novelda/Legacy-HW/X4A02-PCBA-Rev3_3_Design-Documentation_Public/readme.md

# X4A02-PCBA-Rev3_3_Design_Documentation_Public.zip - Package content 

This document describes the contents of this PCBA documentation package.

## Package Content

    |-- PCBA_Doc_28xxxx-xxx/                    # Folder containing documents for board assembly
        |-- BOM-28xxxx-xxx.xlsx                 # Bill of Materials in Excel format
        |-- PCBA_Doc_28xxxx-xxx.PDF             # PCBA Manufacturing Documentation in pdf format
        |-- Pick_Place-28xxxx-xxx.txt           # ascii file for Pick and Place machine
        |-- Test_Point_Report-28xxxx-xxx.txt    # ascii file with coordinates of test points
    |-- 3D_Print_28xxxx-xxx.PDF                 # 3D-view of PCBA in pdf format
    |-- readme.md                               # This file
    |-- STEP_Model_28xxxx-xxx.step              # 3D model of PCBA in step format

## Viewing step model

The step model file contains the PCBA in 3D step format. The model may be imported into most 3D CAD tools. To view the model, use a simple step viewer like
[STP Viewer](http://stpviewer.com/).

## Documents under license

Antennas are available under license. Contact your XeThru partner to get a license agreement for XeThru antennas.
