novelda/Legacy-HW/X4M03-Rev5_Design_Documentation_Public/readme.md

# X4M03-Rev5_Design_Documentation_Public.zip - Package content

This document describes the contents of this PCBA documentation package.

## Package Content

    |-- Altium_Project_000153-005/              # Folder containing Altium project files
      |-- doc/                                  # Folder containing documents in ascii format
        |-- PCBA_documentation.txt              # Markdown file for generation of assembly specifications
        |-- Release_Notes.txt                   # Markdown file with project release notes
      |-- Project.outjob                        # Altium Outjob file
      |-- X4M03.PcbDoc                          # Altium PCB Document
      |-- PCBA_Assembly.PCBDwf                  # Altium Draftsman assembly drawing
      |-- X4M03.PrjPcb                          # Altium PCB Project File
      |-- Main.SchDoc                           # Altium Schematic sheet
    |-- PCBA_Doc_000153-005/                    # Folder containing documents for board assembly
      |-- BOM-000153-005.xlsx                   # Bill of Materials in Excel format
      |-- PCBA_Doc_000153-005.PDF               # PCBA Manufacturing Documentation in pdf format
    |-- readme.md                               # This file
    |-- 3D_Print_000153-005.PDF                 # 3D-view of PCBA in pdf format
    |-- PDF3D_000153-005                        # 3D-model of PCBA in PDF3D format
    |-- STEP_Model_000153-005.step              # 3D model of PCBA in step format

## Viewing step model

The step model file contains the PCBA in 3D step format. The model may be imported into most 3D CAD tools. To view the model, use a simple step viewer like
[STP Viewer](http://stpviewer.com/).

## Documents under license

Antennas are available under license. Contact your XeThru partner to get a license agreement for XeThru antennas.
