novelda/Legacy-HW/X4M05-Rev3_2_Design_Documentation_Public/readme.md

# X4M05_Rev3_2_Design_Documentation_Public.zip - Package content

This document describes the contents of this PCBA documentation package.

## Package Content

    |-- PCBA_Doc_280040-003/                    # Folder containing documents for board assembly
        |-- BOM-280040-003.xlsx                 # Bill of Materials in Excel format
        |-- PCBA_Doc_280040-003.PDF             # PCBA Manufacturing Documentation in pdf format
        |-- Pick_Place-280040-003.txt           # ascii file for Pick and Place machine
        |-- Test_Point_Report-280040-003.txt    # ascii file with coordinates of test points
    |-- 3D_Print_280040-003.PDF                 # 3D-view of PCBA in pdf format
    |-- readme.md                               # This file
    |-- STEP_Model_280040-003.step              # 3D model of PCBA in step format

## Viewing step model

The step model file contains the PCBA in 3D step format. The model may be imported into most 3D CAD tools. To view the model, use a simple step viewer like
[STP Viewer](http://stpviewer.com/).

## Documents under license

Antennas are available under license. Contact your XeThru partner to get a license agreement for XeThru antennas.
