novelda/Legacy-HW/X4A02-PCBA-Rev3_3_Design-Documentation_Public/PCBA_Doc_280024-003/BOM-280024-003.xlsx

 | BOM | 280024-003
 | Project: | X4A02 |  | Company: | Novelda AS
 | Title: | Populated components |  | Address: | Gjerdrums vei 8
 | Date: | 2018-03-19 |  |  | NO-0484 Oslo
 | Sheet number: | 1 of 1 |  |  | Norway
 |  |  |  | Classification: | Public
 |  |  |  | Copyright: | Copyright©2018 Novelda AS
# | Designator | Description | Manufacturer | MPN | Quantity | Notes
1 | A1 | X4A02 PCB Rev3 | Novelda |  | 1 | -
2 | P1 | CONNECTOR, HEADER, 1.27MM, SMT, 8WAY, 2ROW | Harwin | M50-3600842 | 1 | -
3 | R100 | RESISTOR, 0R, 0402, 5%, 63mW | -- |  | 1
 |  |  | Total |  | 3
