novelda/Legacy-HW/X4M02-PCBA-Rev10_2_Design_Documentation_Public/PCBA_Doc_280031-010/BOM-280031-010.xlsx

 | BOM | 280031-010
 | Project: | X4M02 |  | Company: | Novelda AS
 | Title: | Populated components |  | Address: | Gjerdrums vei 8
 | Date: | 2017-06-13 |  |  | NO-0484 Oslo
 | Sheet number: | 1 of 1 |  |  | Norway
 |  |  |  | Classification: | Public
 |  |  |  | Copyright: | Copyright©2017 Novelda AS
# | Designator | Description | Manufacturer | MPN | Quantity | Notes
1 | A1 | X4M02 PCB Rev10 | Novelda | 290056-010 | 1 | -
2 | C1 | CAPACITOR, 10n, 0402, 20%, 25V, X7R | -- |  | 1
3 | C100 | CAPACITOR, 10u, 0603, 20%, 6V3, X5R | -- |  | 1
4 | C101 | CAPACITOR, 22p, 0402, 5%, 25V, NP0 | -- |  | 1
5 | C102 | CAPACITOR, 22u, 0603, 20%, 6V3, X5R | -- |  | 1 | -
6 | C103 | CAPACITOR, 1u, 0402, 10%, 10V, X5R | -- |  | 1
7 | C200 | CAPACITOR, 4u7, 0603, 10%, 10V, X5R | -- |  | 1 | -
8 | C201 | CAPACITOR, 100n, 0402, 10%, 10V, X5R | -- |  | 1
9 | C202 | CAPACITOR, 10n, 0402, 10%, 25V, X7R | -- |  | 1
10 | C203 | CAPACITOR, 1n, 0402, 10%, 25V, X7R | -- |  | 1 | -
11 | C204 | CAPACITOR, 100p, 0402, 5%, 50V, NP0 | -- |  | 1
12 | C212 | CAPACITOR, 12p, 0402, 5%, 50V, NP0 | -- |  | 1 | -
13 | C213 | CAPACITOR, 12p, 0402, 5%, 50V, NP0 | -- |  | 1 | -
14 | C300 | CAPACITOR, 2u2, 0402, 20%, 6V3, X5R | -- |  | 1
15 | C301 | CAPACITOR, 100n, 0402, 10%, 10V, X5R | -- |  | 1
16 | C302 | CAPACITOR, 100n, 0402, 10%, 10V, X5R | -- |  | 1
17 | C303 | CAPACITOR, 100n, 0402, 10%, 10V, X5R | -- |  | 1
18 | C304 | CAPACITOR, 100n, 0402, 10%, 10V, X5R | -- |  | 1
19 | C305 | CAPACITOR, 100n, 0402, 10%, 10V, X5R | -- |  | 1
20 | C310 | CAPACITOR, 100n, 0402, 10%, 10V, X5R | -- |  | 1
21 | C311 | CAPACITOR, 100n, 0402, 10%, 10V, X5R | -- |  | 1
22 | C312 | CAPACITOR, 100n, 0402, 10%, 10V, X5R | -- |  | 1
23 | C313 | CAPACITOR, 1u, 0402, 10%, 10V, X5R | -- |  | 1
24 | C314 | CAPACITOR, 100n, 0402, 10%, 10V, X5R | -- |  | 1
25 | C315 | CAPACITOR, 100n, 0402, 10%, 10V, X5R | -- |  | 1
26 | C316 | CAPACITOR, 100n, 0402, 10%, 10V, X5R | -- |  | 1
27 | C319 | CAPACITOR, 100n, 0402, 10%, 10V, X5R | -- |  | 1
28 | C320 | CAPACITOR, 2u2, 0402, 20%, 6V3, X5R | -- |  | 1
29 | C321 | CAPACITOR, 100n, 0402, 10%, 10V, X5R | -- |  | 1
30 | C322 | CAPACITOR, 10u, 0603, 20%, 6V3, X5R | -- |  | 1
31 | C323 | CAPACITOR, 10p, 0402, 5%, 50V, NP0 | -- |  | 1
32 | C324 | CAPACITOR, 18p, 0402, 5%, 50V, NP0 | -- |  | 1
33 | C325 | CAPACITOR, 18p, 0402, 5%, 50V, NP0 | -- |  | 1
34 | C326 | CAPACITOR, 100n, 0402, 10%, 10V, X5R | -- |  | 1
35 | C328 | CAPACITOR, 100n, 0402, 10%, 10V, X5R | -- |  | 1
36 | C329 | CAPACITOR, 100n, 0402, 10%, 10V, X5R | -- |  | 1
37 | C330 | CAPACITOR, 100n, 0402, 10%, 10V, X5R | -- |  | 1
38 | C331 | CAPACITOR, 4u7, 0603, 10%, 10V, X5R | -- |  | 1 | -
39 | C332 | CAPACITOR, 1u, 0402, 10%, 10V, X5R | -- |  | 1
40 | C333 | CAPACITOR, 1u, 0402, 10%, 10V, X5R | -- |  | 1
41 | C334 | CAPACITOR, 100n, 0402, 10%, 10V, X5R | -- |  | 1
42 | C335 | CAPACITOR, 100n, 0603, 10%, 16V, X7R | -- |  | 1 | 0603
43 | C336 | CAPACITOR, 100n, 0402, 10%, 10V, X5R | -- |  | 1
44 | C337 | CAPACITOR, 2u2, 0402, 20%, 6V3, X5R | -- |  | 1
45 | C338 | CAPACITOR, 100n, 0402, 10%, 10V, X5R | -- |  | 1
46 | C339 | CAPACITOR, 100n, 0402, 10%, 10V, X5R | -- |  | 1
47 | C340 | CAPACITOR, 100n, 0402, 10%, 10V, X5R | -- |  | 1
48 | D1 | DIODE, 1N4148W-7-F, SWITCH, 300MA, 100V, SOD123 | -- |  | 1 | -
49 | D100 | DIODE, 1N4148W-7-F, SWITCH, 300MA, 100V, SOD123 | -- |  | 1 | -
50 | FB1 | FERRITE 1.5A 40 OHM 0805 SMD | Laird-Signal Integrity Product | MI0805K400R-10 | 1
51 | FB300 | FERRITE BEAD, 470ohm@100MHz, 1A | Murata | BLM18PG471SN1D | 1
52 | FB301 | FERRITE BEAD, 470ohm@100MHz, 1A | Murata | BLM18PG471SN1D | 1
53 | L100 | INDUCTOR, PWR, 6.8UH,0.76A,10%,120MHZ | Coilcraft | 1008PS-682KLB | 1
54 | L300 | INDUCTOR, 10u, 0805, 20%, 60mA, 650mOhm | TAIYO YUDEN | CK2125100M-T | 1 | -
55 | LED1 | LED RGB, 0404, Everlight 18-239A/R6GHBHC-D02/2T | Everlight | 18-239A/R6GHBHC-D02/2T | 1
56 | P1 | BOARD-BOARD CONNECTOR HEADER, 8WAY, 2ROW, 2MM PITCH | PINREX | 220-92-08GB22 | 1
57 | P2 | CONNECTOR, MICRO USB, RECEPTACLE, 5WAY | Hirose | ZX62D-B-5PA8 | 1
58 | Q100 | MOSFET, P-CHANNEL, 12V, 4A, 31mOhm | Diodes Incorporated | DMP1045U | 1
59 | R1 | RESISTOR, 27k, 0402, 1%, 63mW | -- |  | 1
60 | R2 | RESISTOR, 47k, 0402, 1%, 63mW | -- |  | 1
61 | R3 | RESISTOR, 620R, 0402, 1%, 63mW | -- |  | 1
62 | R4 | RESISTOR, 200R, 0402, 1%, 63mW | -- |  | 1
63 | R5 | RESISTOR, 120R, 0402, 1%, 63mW | -- |  | 1
64 | R6 | RESISTOR, 0R, 0603, 1%, 100mW | -- |  | 1 | -
65 | R100 | RESISTOR, 680k, 0402, 1%, 63mW | -- |  | 1
66 | R101 | RESISTOR, 1M, 0402, 5%, 63mW | -- |  | 1
67 | R102 | RESISTOR, 100k, 0402, 1%, 63mW | -- |  | 1
68 | R103 | RESISTOR, 100k, 0402, 1%, 63mW | -- |  | 1
69 | R200 | RESISTOR, 10k, 0402, 1%, 63mW | -- |  | 1
70 | R201 | RESISTOR, 100k, 0402, 1%, 63mW | -- |  | 1
71 | R300 | RESISTOR, 5k6, 0402, 1%, 63mW | -- |  | 1
72 | R301 | RESISTOR, 100k, 0402, 1%, 63mW | -- |  | 1
73 | R304 | RESISTOR, 100k, 0402, 1%, 63mW | -- |  | 1
74 | R305 | RESISTOR, 2R2, 0402, 1%, 63mW | -- |  | 1
75 | S1 | Shieldbox 16 x 8 x 3mm | -- | - | 1 | -
76 | U1 | DIODE PROTECTION, TVS, DUAL | NXP | PRTR5V0U2X | 1
77 | U100 | LTC3621EDCB-2, BUCK, 2.7-17V, 2.2MHZ, 1A, 0.6-17V, 6DFN | Linear Technology | LTC3621EDCB-2#TRMBF | 1
78 | U200 | XeThru X4 | Novelda | 200260-002 | 1 | -
79 | U301 | ATSAMS70Q21A-CN, MCU, LFBGA144, 2048k Flash, 384k SRAM | Atmel | ATSAMS70Q21A-CN | 1 | -
80 | U302 | IC, SYNCHRONOUS DRAM (SDRAM), 64MBIT, 6NS, 166MHZ, 4M x 16BIT, 54FBGA | Winbond Electronics Corp. | W9864G6JT-6I | 1 | -
81 | U303 | DSC6003JI2A-012.0000, 12MHZ CMOS MEMS OSCILLATOR 2.5X2MM | Microchip Technology | DSC6003JI2A-012.0000 | 1 | -
82 | Y200 | LFXTAL072115, CRYSTAL 27MHZ, 10PF, SMD | IQD Frequency Products | LFXTAL072115 | 1 | -
83 | Y300 | CRYSTAL, 32.768KHZ, 12.5PF, SMD | Abracon | ABS07-32.768KHZ-T | 1
 |  |  | Total |  | 83
