novelda/Legacy-HW/X4M03-Rev5_Design_Documentation_Public/PCBA_Doc_000153-005/BOM-000153-005.xlsx

 | BOM | 000153-005
 | Project: | X4M03 |  | Company: | Novelda AS
 | Title: | Populated components |  | Address: | Gjerdrums vei 8
 | Date: | 2017-06-07 |  |  | NO-0484 Oslo
 | Sheet number: | 1 of 1 |  |  | Norway
 |  |  |  | Classification: | Public
 |  |  |  | Copyright: | Copyright©2017 Novelda AS
# | Designator | Description | Manufacturer | MPN | Quantity | Notes
1 | A1 | X4M05 PCBA Rev3 | Novelda | 280040-003 | 1 | -
2 | A2 | XTMCU02 PCBA Rev4 | Novelda | 280027-004 | 1 | -
3 | H1 | HEX NUT, M2.5, PLASTIC | -- |  | 1 | -
4 | H2 | HEX NUT, M2.5, PLASTIC | -- |  | 1 | -
5 | H3 | SLOTTED MACHINE SCREW, M2.5, 16MM LENGTH BELOW HEAD, PLASTIC | -- |  | 1 | -
6 | H4 | SLOTTED MACHINE SCREW, M2.5, 16MM LENGTH BELOW HEAD, PLASTIC | -- |  | 1 | -
7 | H5 | FEMALE SPACER, Ø5MM O/D, 6MM LENGTH, PLASTIC | -- |  | 1 | -
8 | H6 | FEMALE SPACER, Ø5MM O/D, 6MM LENGTH, PLASTIC | -- |  | 1 | -
 |  |  | Total |  | 8
