novelda/Legacy-HW/X4M05-Rev3_2_Design_Documentation_Public/PCBA_Doc_280040-003/BOM-280040-003.xlsx

 | BOM | 280040-003
 | Project: | X4M05 |  | Company: | Novelda AS
 | Title: | Populated components |  | Address: | Gjerdrums vei 8
 | Date: | 2017-06-02 |  |  | NO-0484 Oslo
 | Sheet number: | 1 of 1 |  |  | Norway
 |  |  |  | Classification: | Public
 |  |  |  | Copyright: | Copyright©2017 Novelda AS
# | Designator | Description | Manufacturer | MPN | Quantity | Notes
1 | A1 | X4A02 PCB Rev3 | Novelda |  | 1 | -
2 | M1 | X4SIP02 PCBA Rev4 | Novelda | 280022-004 | 1
3 | P1 | CONNECTOR, HEADER, 1.27MM, SMT, 8WAY, 2ROW | Harwin | M50-3600842 | 1 | -
4 | R100 | RESISTOR, 0R, 0402, 5%, 63mW | -- |  | 1
 |  |  | Total |  | 4
