novelda/Legacy-HW/X4M07-Rev2_Design_Documentation_Public/PCBA_Doc_280042-002/BOM-280042-002.xlsx

 | BOM | 280042-002
 | Project: | X4M07 |  | Company: | Novelda AS
 | Title: | Populated components |  | Address: | Gjerdrums vei 8
 | Date: | 2018-02-01 |  |  | NO-0484 Oslo
 | Sheet number: | 1 of 1 |  |  | Norway
 |  |  |  | Classification: | Public
 |  |  |  | Copyright: | Copyright©2018 Novelda AS
# | Designator | Description | Manufacturer | MPN | Quantity | Notes
1 | A1 | X4A04 PCB Rev1 | Novelda | 290065-001 | 1 | -
2 | M1 | X4SIP02 PCBA Rev4 | Novelda | 280022-004 | 1 | -
3 | P1 | CONNECTOR, HEADER, 1.27MM, SMT, 8WAY, 2ROW | Harwin | M50-3600842 | 1 | -
4 | R100 | RESISTOR, 0R, 0402, 5%, 63mW | -- |  | 1
 |  |  | Total |  | 4
