novelda/Legacy-HW/X4SIP02-Rev4_1_Design_Documentation_Public/PCBA_Doc_280022-004/BOM-280022-004.xlsx

 | BOM | 280022-004
 | Project: | X4SIP02 |  | Company: | Novelda AS
 | Title: | Populated components |  | Address: | Gjerdrums vei 8
 | Date: | 2018-03-19 |  |  | NO-0484 Oslo
 | Sheet number: | 1 of 1 |  |  | Norway
 |  |  |  | Classification: | Public
 |  |  |  | Copyright: | Copyright©2018 Novelda AS
# | Designator | Description | Manufacturer | MPN | Quantity | Notes
1 | A1 | X4SIP02 PCB Rev4 | Novelda | 290047-004 | 1 | -
2 | C100 | CAPACITOR, 4u7, 0603, 10%, 10V, X5R | -- |  | 1 | -
3 | C101 | CAPACITOR, 100n, 0402, 10%, 10V, X5R | -- |  | 1
4 | C102 | CAPACITOR, 10n, 0402, 10%, 25V, X7R | -- |  | 1
5 | C103 | CAPACITOR, 1n, 0402, 10%, 25V, X7R | -- |  | 1 | -
6 | C104 | CAPACITOR, 100p, 0402, 20%, 50V, X7R | -- |  | 1 | -
7 | C105 | CAPACITOR, 12p, 0402, 5%, 50V, NP0 | -- |  | 1 | -
8 | C106 | CAPACITOR, 12p, 0402, 5%, 50V, NP0 | -- |  | 1 | -
9 | R100 | RESISTOR, 10k, 0402, 1%, 63mW | -- |  | 1
10 | R101 | RESISTOR, 100k, 0402, 1%, 63mW | -- |  | 1
11 | S1 | Shieldbox 14.2 x 12.2 x 3mm | -- | - | 1 | -
12 | U100 | XeThru X4 | Novelda | 200260-002 | 1 | -
13 | Y100 | LFXTAL072115, CRYSTAL 27MHZ, 10PF, SMD | IQD Frequency Products | LFXTAL072115 | 1 | -
 |  |  | Total |  | 13
