novelda/Legacy-HW/XTMCU02-Rev4_1_Design-Documentation_Public/PCBA_Doc_280027-004/BOM-280027-004.xlsx

 | BOM | 280027-004
 | Project: | XTMCU02 |  | Company: | Novelda AS
 | Title: | Populated components |  | Address: | Gjerdrums vei 8
 | Date: | 2018-03-21 |  |  | NO-0484 Oslo
 | Sheet number: | 1 of 1 |  |  | Norway
 |  |  |  | Classification: | Public
 |  |  |  | Copyright: | Copyright©2018 Novelda AS
# | Designator | Description | Manufacturer | MPN | Quantity | Notes
1 | A1 | XTMCU02 PCB Rev4 | Novelda | 290052-004 | 1 | -
2 | C1 | CAPACITOR, 10n, 0402, 20%, 25V, X7R | -- |  | 1
3 | C100 | CAPACITOR, 10u, 0603, 20%, 6V3, X5R | -- |  | 1
4 | C101 | CAPACITOR, 22p, 0402, 5%, 25V, NP0 | -- |  | 1
5 | C102 | CAPACITOR, 22u, 0603, 20%, 6V3, X5R | -- |  | 1 | -
6 | C103 | CAPACITOR, 1u, 0402, 10%, 10V, X5R | -- |  | 1
7 | C200 | CAPACITOR, 100n, 0402, 10%, 10V, X5R | -- |  | 1
8 | C201 | CAPACITOR, 100n, 0402, 10%, 10V, X5R | -- |  | 1
9 | C202 | CAPACITOR, 100n, 0402, 10%, 10V, X5R | -- |  | 1
10 | C203 | CAPACITOR, 100n, 0402, 10%, 10V, X5R | -- |  | 1
11 | C204 | CAPACITOR, 100n, 0402, 10%, 10V, X5R | -- |  | 1
12 | C205 | CAPACITOR, 100n, 0402, 10%, 10V, X5R | -- |  | 1
13 | C206 | CAPACITOR, 100n, 0402, 10%, 10V, X5R | -- |  | 1
14 | C207 | CAPACITOR, 100n, 0402, 10%, 10V, X5R | -- |  | 1
15 | C208 | CAPACITOR, 100n, 0402, 10%, 10V, X5R | -- |  | 1
16 | C209 | CAPACITOR, 1u, 0402, 10%, 10V, X5R | -- |  | 1
17 | C210 | CAPACITOR, 2u2, 0402, 20%, 6V3, X5R | -- |  | 1
18 | C211 | CAPACITOR, 100n, 0402, 10%, 10V, X5R | -- |  | 1
19 | C212 | CAPACITOR, 100n, 0402, 10%, 10V, X5R | -- |  | 1
20 | C213 | CAPACITOR, 100n, 0402, 10%, 10V, X5R | -- |  | 1
21 | C214 | CAPACITOR, 2u2, 0402, 20%, 6V3, X5R | -- |  | 1
22 | C215 | CAPACITOR, 100n, 0402, 10%, 10V, X5R | -- |  | 1
23 | C216 | CAPACITOR, 100n, 0402, 10%, 10V, X5R | -- |  | 1
24 | C217 | CAPACITOR, 100n, 0402, 10%, 10V, X5R | -- |  | 1
25 | C218 | CAPACITOR, 100n, 0402, 10%, 10V, X5R | -- |  | 1
26 | C219 | CAPACITOR, 10u, 0603, 20%, 6V3, X5R | -- |  | 1
27 | C220 | CAPACITOR, 10p, 0402, 5%, 50V, NP0 | -- |  | 1
28 | C221 | CAPACITOR, 18p, 0402, 5%, 50V, NP0 | -- |  | 1
29 | C222 | CAPACITOR, 18p, 0402, 5%, 50V, NP0 | -- |  | 1
30 | C223 | CAPACITOR, 100n, 0402, 10%, 10V, X5R | -- |  | 1
31 | C225 | CAPACITOR, 4u7, 0603, 10%, 10V, X5R | -- |  | 1 | -
32 | C226 | CAPACITOR, 100n, 0402, 10%, 10V, X5R | -- |  | 1
33 | C227 | CAPACITOR, 100n, 0402, 10%, 10V, X5R | -- |  | 1
34 | C228 | CAPACITOR, 100n, 0402, 10%, 10V, X5R | -- |  | 1
35 | C229 | CAPACITOR, 100n, 0402, 10%, 10V, X5R | -- |  | 1
36 | C230 | CAPACITOR, 100n, 0402, 10%, 10V, X5R | -- |  | 1
37 | C231 | CAPACITOR, 100n, 0402, 10%, 10V, X5R | -- |  | 1
38 | C232 | CAPACITOR, 2u2, 0402, 20%, 6V3, X5R | -- |  | 1
39 | C233 | CAPACITOR, 1u, 0402, 10%, 10V, X5R | -- |  | 1
40 | C234 | CAPACITOR, 1u, 0402, 10%, 10V, X5R | -- |  | 1
41 | D1 | DIODE, 1N4148W-7-F, SWITCH, 300MA, 100V, SOD123 | -- |  | 1 | -
42 | D100 | DIODE, 1N4148W-7-F, SWITCH, 300MA, 100V, SOD123 | -- |  | 1 | -
43 | FB1 | FERRITE 1.5A 40 OHM 0805 SMD | Laird-Signal Integrity Product | MI0805K400R-10 | 1
44 | FB200 | FERRITE BEAD, 470ohm@100MHz, 1A | Murata | BLM18PG471SN1D | 1
45 | FB201 | FERRITE BEAD, 470ohm@100MHz, 1A | Murata | BLM18PG471SN1D | 1
46 | J1 | CONNECTOR, RECEPTACLE, 1.27MM, THT, 8WAY, 2ROW | Harwin | M50-3000845 | 1 | -
47 | L100 | INDUCTOR, PWR, 6.8UH,0.76A,10%,120MHZ | Coilcraft | 1008PS-682KLB | 1
48 | L200 | INDUCTOR, 10u, 0805, 20%, 60mA, 650mOhm | TAIYO YUDEN | CK2125100M-T | 1 | -
49 | LED1 | LED RGB, 0404, Everlight 18-239A/R6GHBHC-D02/2T | Everlight | 18-239A/R6GHBHC-D02/2T | 1
50 | P1 | BOARD-BOARD CONNECTOR HEADER, 8WAY, 2ROW, 2MM PITCH | PINREX | 220-92-08GB22 | 1
51 | P2 | CONNECTOR, MICRO USB, RECEPTACLE, 5WAY | Hirose | ZX62D-B-5PA8 | 1
52 | P3 | CONNECTOR, 1.27MM, THRU HOLE, 2X5WAY | Samtec | SHF-105-01-L-D-TH | 1 | -
53 | Q100 | MOSFET, P-CHANNEL, 12V, 4A, 31mOhm | Diodes Incorporated | DMP1045U | 1
54 | R1 | RESISTOR, 27k, 0402, 1%, 63mW | -- |  | 1
55 | R2 | RESISTOR, 47k, 0402, 1%, 63mW | -- |  | 1
56 | R3 | RESISTOR, 620R, 0402, 1%, 63mW | -- |  | 1
57 | R4 | RESISTOR, 200R, 0402, 1%, 63mW | -- |  | 1
58 | R5 | RESISTOR, 120R, 0402, 1%, 63mW | -- |  | 1
59 | R6 | RESISTOR, 0R, 0603, 1%, 100mW | -- |  | 1 | -
60 | R100 | RESISTOR, 680k, 0402, 1%, 63mW | -- |  | 1
61 | R101 | RESISTOR, 1M, 0402, 5%, 63mW | -- |  | 1
62 | R102 | RESISTOR, 100k, 0402, 1%, 63mW | -- |  | 1
63 | R103 | RESISTOR, 100k, 0402, 1%, 63mW | -- |  | 1
64 | R200 | RESISTOR, 100k, 0402, 1%, 63mW | -- |  | 1
65 | R201 | RESISTOR, 5k6, 0402, 1%, 63mW | -- |  | 1
66 | R204 | RESISTOR, 100k, 0402, 1%, 63mW | -- |  | 1
67 | R205 | RESISTOR, 2R2, 0402, 1%, 63mW | -- |  | 1
68 | U1 | DIODE PROTECTION, TVS, DUAL | NXP | PRTR5V0U2X | 1
69 | U100 | LTC3621EDCB-2, BUCK, 2.7-17V, 2.2MHZ, 1A, 0.6-17V, 6DFN | Linear Technology | LTC3621EDCB-2#TRMBF | 1
70 | U200 | ATSAMS70Q21A-CN, MCU, LFBGA144, 2048k Flash, 384k SRAM | Atmel | ATSAMS70Q21A-CN | 1 | -
71 | U201 | IC, SYNCHRONOUS DRAM (SDRAM), 64MBIT, 6NS, 166MHZ, 4M x 16BIT, 54FBGA | Winbond Electronics Corp. | W9864G6JT-6I | 1 | -
72 | U202 | DSC6003JI2A-012.0000, 12MHZ CMOS MEMS OSCILLATOR 2.5X2MM | Microchip Technology | DSC6003JI2A-012.0000 | 1 | -
73 | Y200 | CRYSTAL, 32.768KHZ, 12.5PF, SMD | Abracon | ABS07-32.768KHZ-T | 1
 |  |  | Total |  | 73
