novelda/Legacy-HW/X4A02-PCBA-Rev3_3_Design-Documentation_Public/STEP_Model_280024-003.step

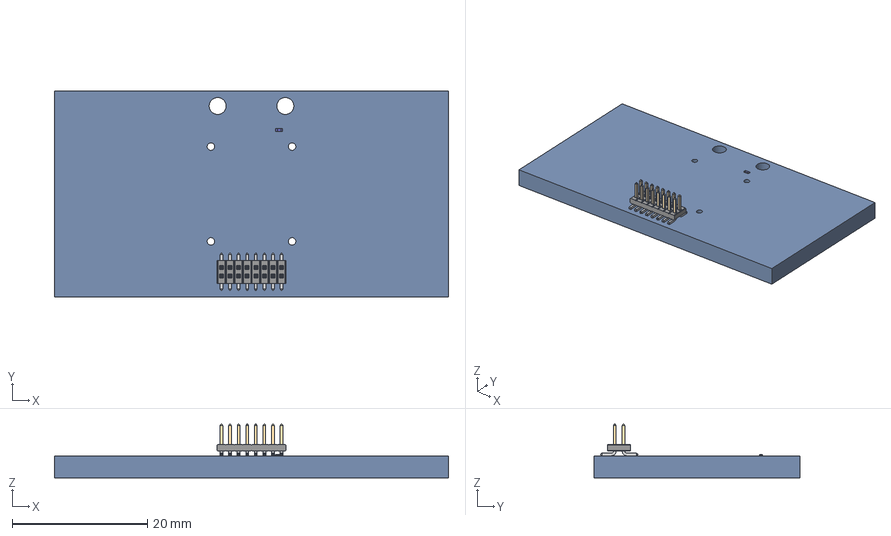
[picture p1: CAD file, 2020-04-07]
X4A02-PCBA-Rev3_3_Design-Documentation_Public/STEP_Model_280024-003.step
58.2 x 30.4 x 7.95 mm
Board
Open_CASCADE_STEP_translator_6.2_6.1
M50-350-MLD
M50-360-CONTACT x 16
