novelda/Legacy-HW/X4M05-Rev3_2_Design_Documentation_Public/STEP_Model_280040-003.step

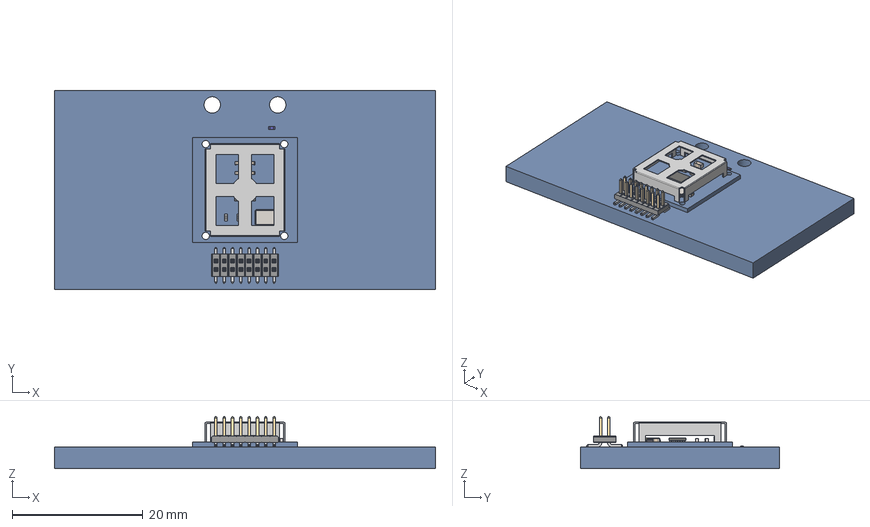
[picture p2: CAD file, 2020-04-07]
X4M05-Rev3_2_Design_Documentation_Public/STEP_Model_280040-003.step
58.2 x 30.4 x 7.95 mm
Board x 2
200284-003_ShieldBox
Extruded
User_Library-res0402-1 x 2
User_Library-SMD_CAPACITOR0402 x 6
User_Library-SMD_CAPACITOR0603
tsx-3225
M50-350-MLD
M50-360-CONTACT x 16
Open_CASCADE_STEP_translator_6.2_6.1
