novelda/Legacy-HW/X4SIP02-Rev4_1_Design_Documentation_Public/STEP_Model_280022-004.step

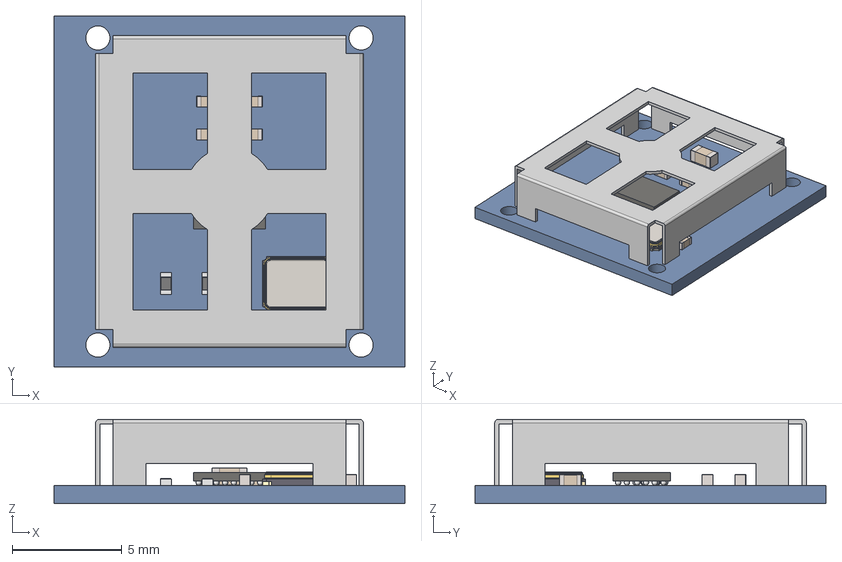
[picture p3: CAD file, 2020-04-07]
X4SIP02-Rev4_1_Design_Documentation_Public/STEP_Model_280022-004.step
16.0 x 16.0 x 3.83 mm
Board
200284-003_ShieldBox
Extruded
User_Library-res0402-1 x 2
User_Library-SMD_CAPACITOR0402 x 6
User_Library-SMD_CAPACITOR0603
tsx-3225
