novelda/Legacy-HW/(list of files, cad)

Other CAD files:
X4M07-Rev2_Design_Documentation_Public/STEP_Model_280042-002.step
