novelda/Legacy-HW/X4SIP02-Rev4_1_Design_Documentation_Public/Altium_Project_280022-004/doc/Testpoints.txt

---
title: Documentation of test points
---
# Test points - general information

This PCB have implemented no dedicated test points, but the pads on the bottom layer can be used as test points for
MDA (Manufacturing Defect Analyser).
