novelda/Legacy-HW/X4M03-Rev5_Design_Documentation_Public/Altium_Project_000153-005/doc/Release_Notes.txt

# Release Notes

## Revision 5 - 2017-06-07

* Changed A1 to X4M05 PCBA Rev3.
* Changed A2 to XTMCU02 PCBA Rev4.

## Revision 4 - 2017-02-22

* Changed A2 to XTMCU02 PCBA Rev3.

## Revision 3 - 2017-01-26

* Change A1 to X4M05 PCBA Rev2.
* Add hardware.

## Revision 2

* Change A1 to X4A02-T1 PCBA Rev1.
* Change A2 to XTMCU02 PCBA Rev2.

## Revision 1

Initial Prototype.
