novelda/Legacy-HW/X4A02-PCBA-Rev3_3_Design-Documentation_Public/PCBA_Doc_280024-003/PCBA_Doc-280024-003.PDF

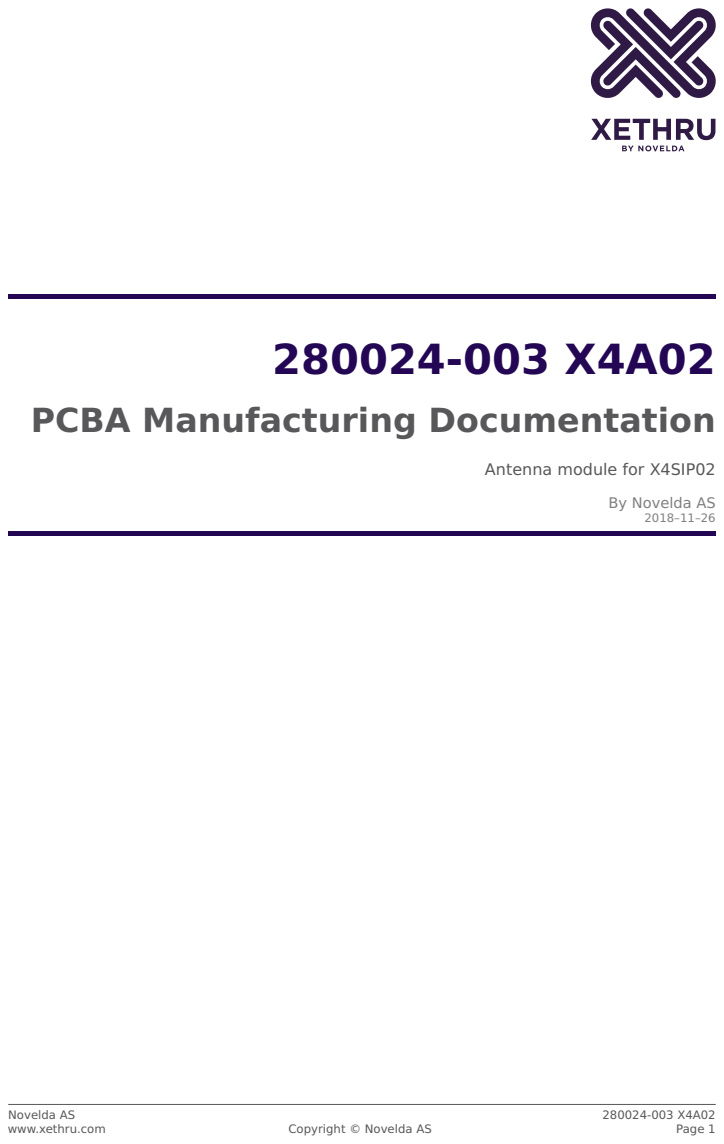
[picture p4: page 1]

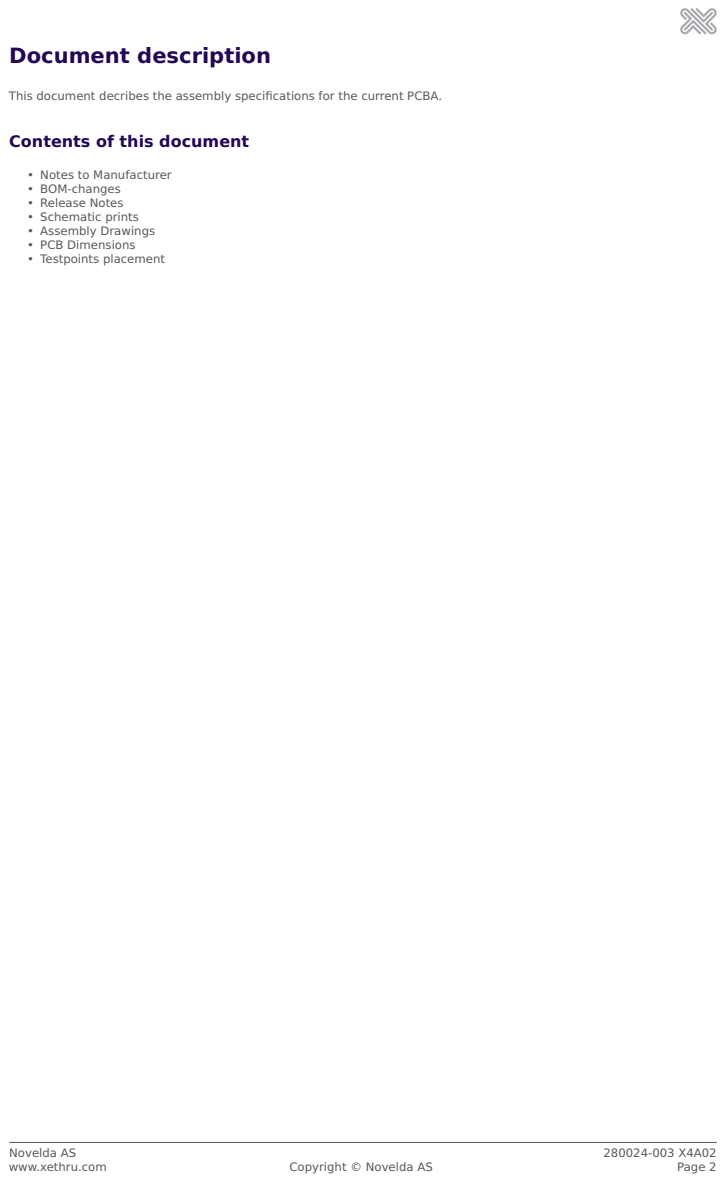
[picture p5: page 2]

This document decribes the assembly specifications for the current PCBA.

Contents of this document

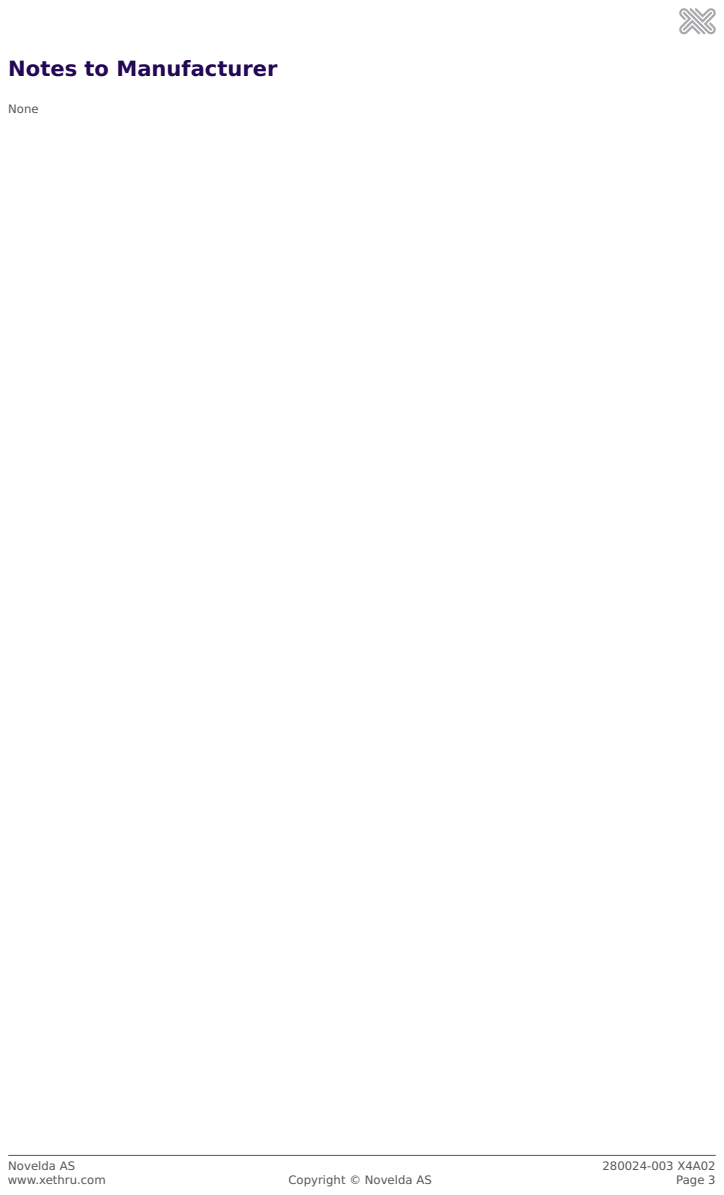
[picture p6: page 3]

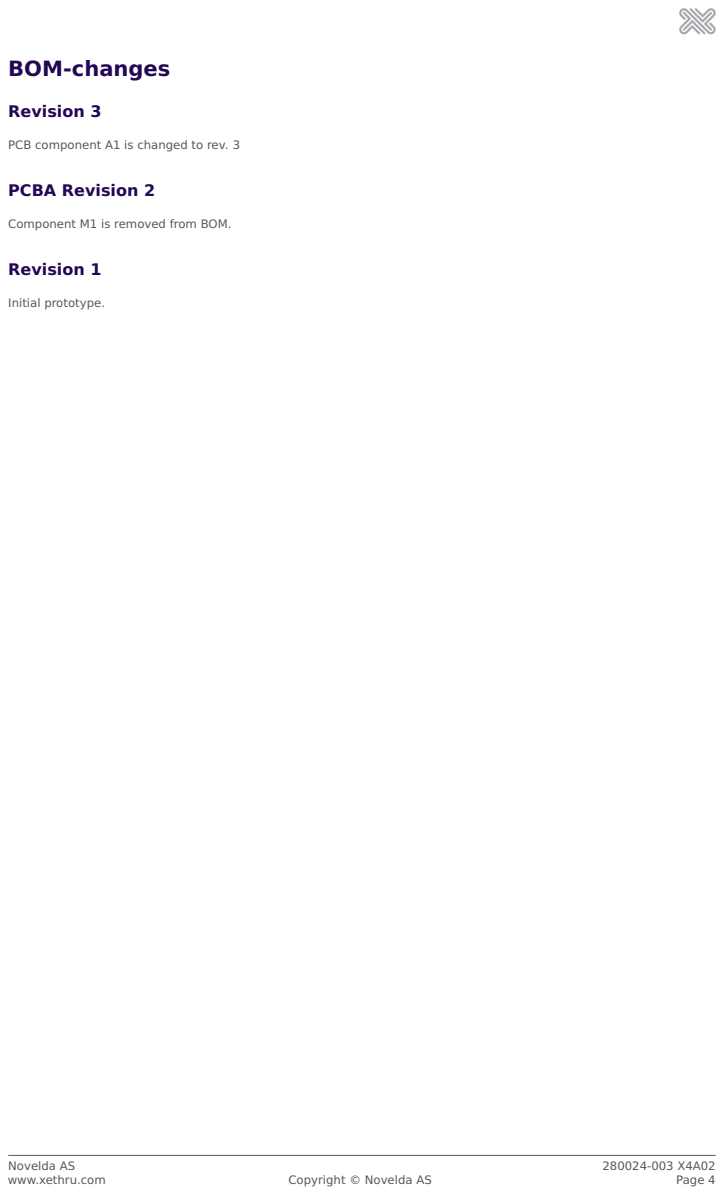
[picture p7: page 4]

PCB component A1 is changed to rev. 3

Component M1 is removed from BOM.

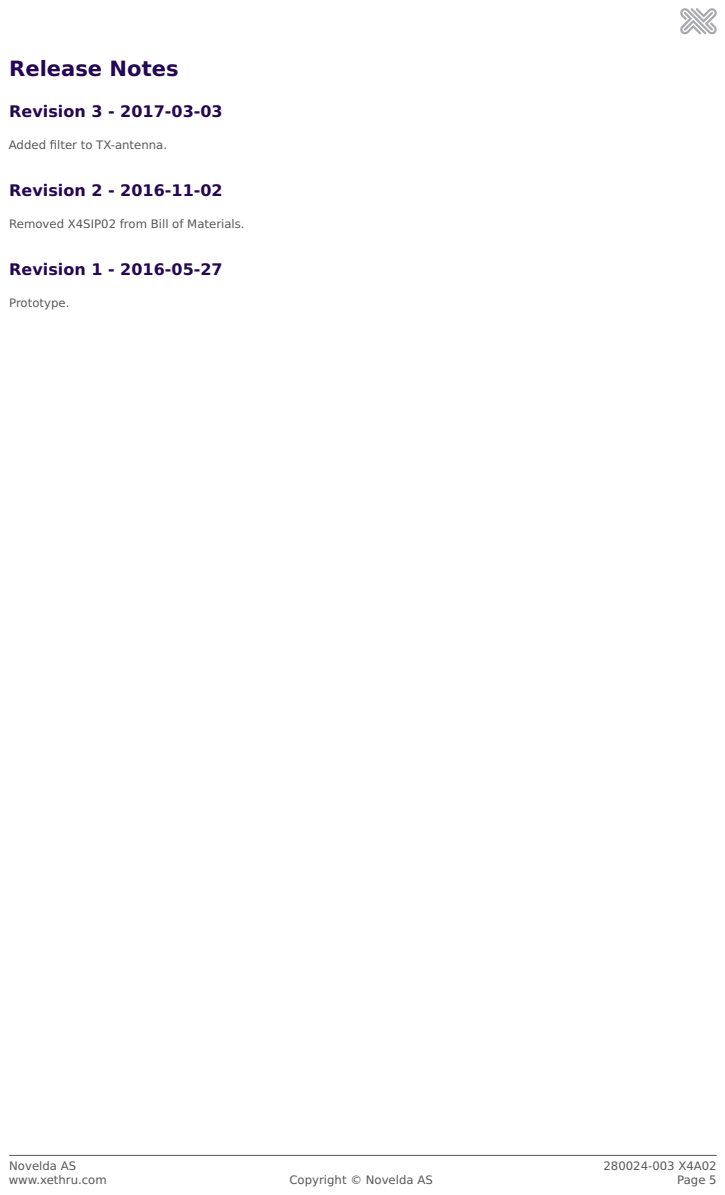
[picture p8: page 5]

Added filter to TX-antenna.

Removed X4SIP02 from Bill of Materials.

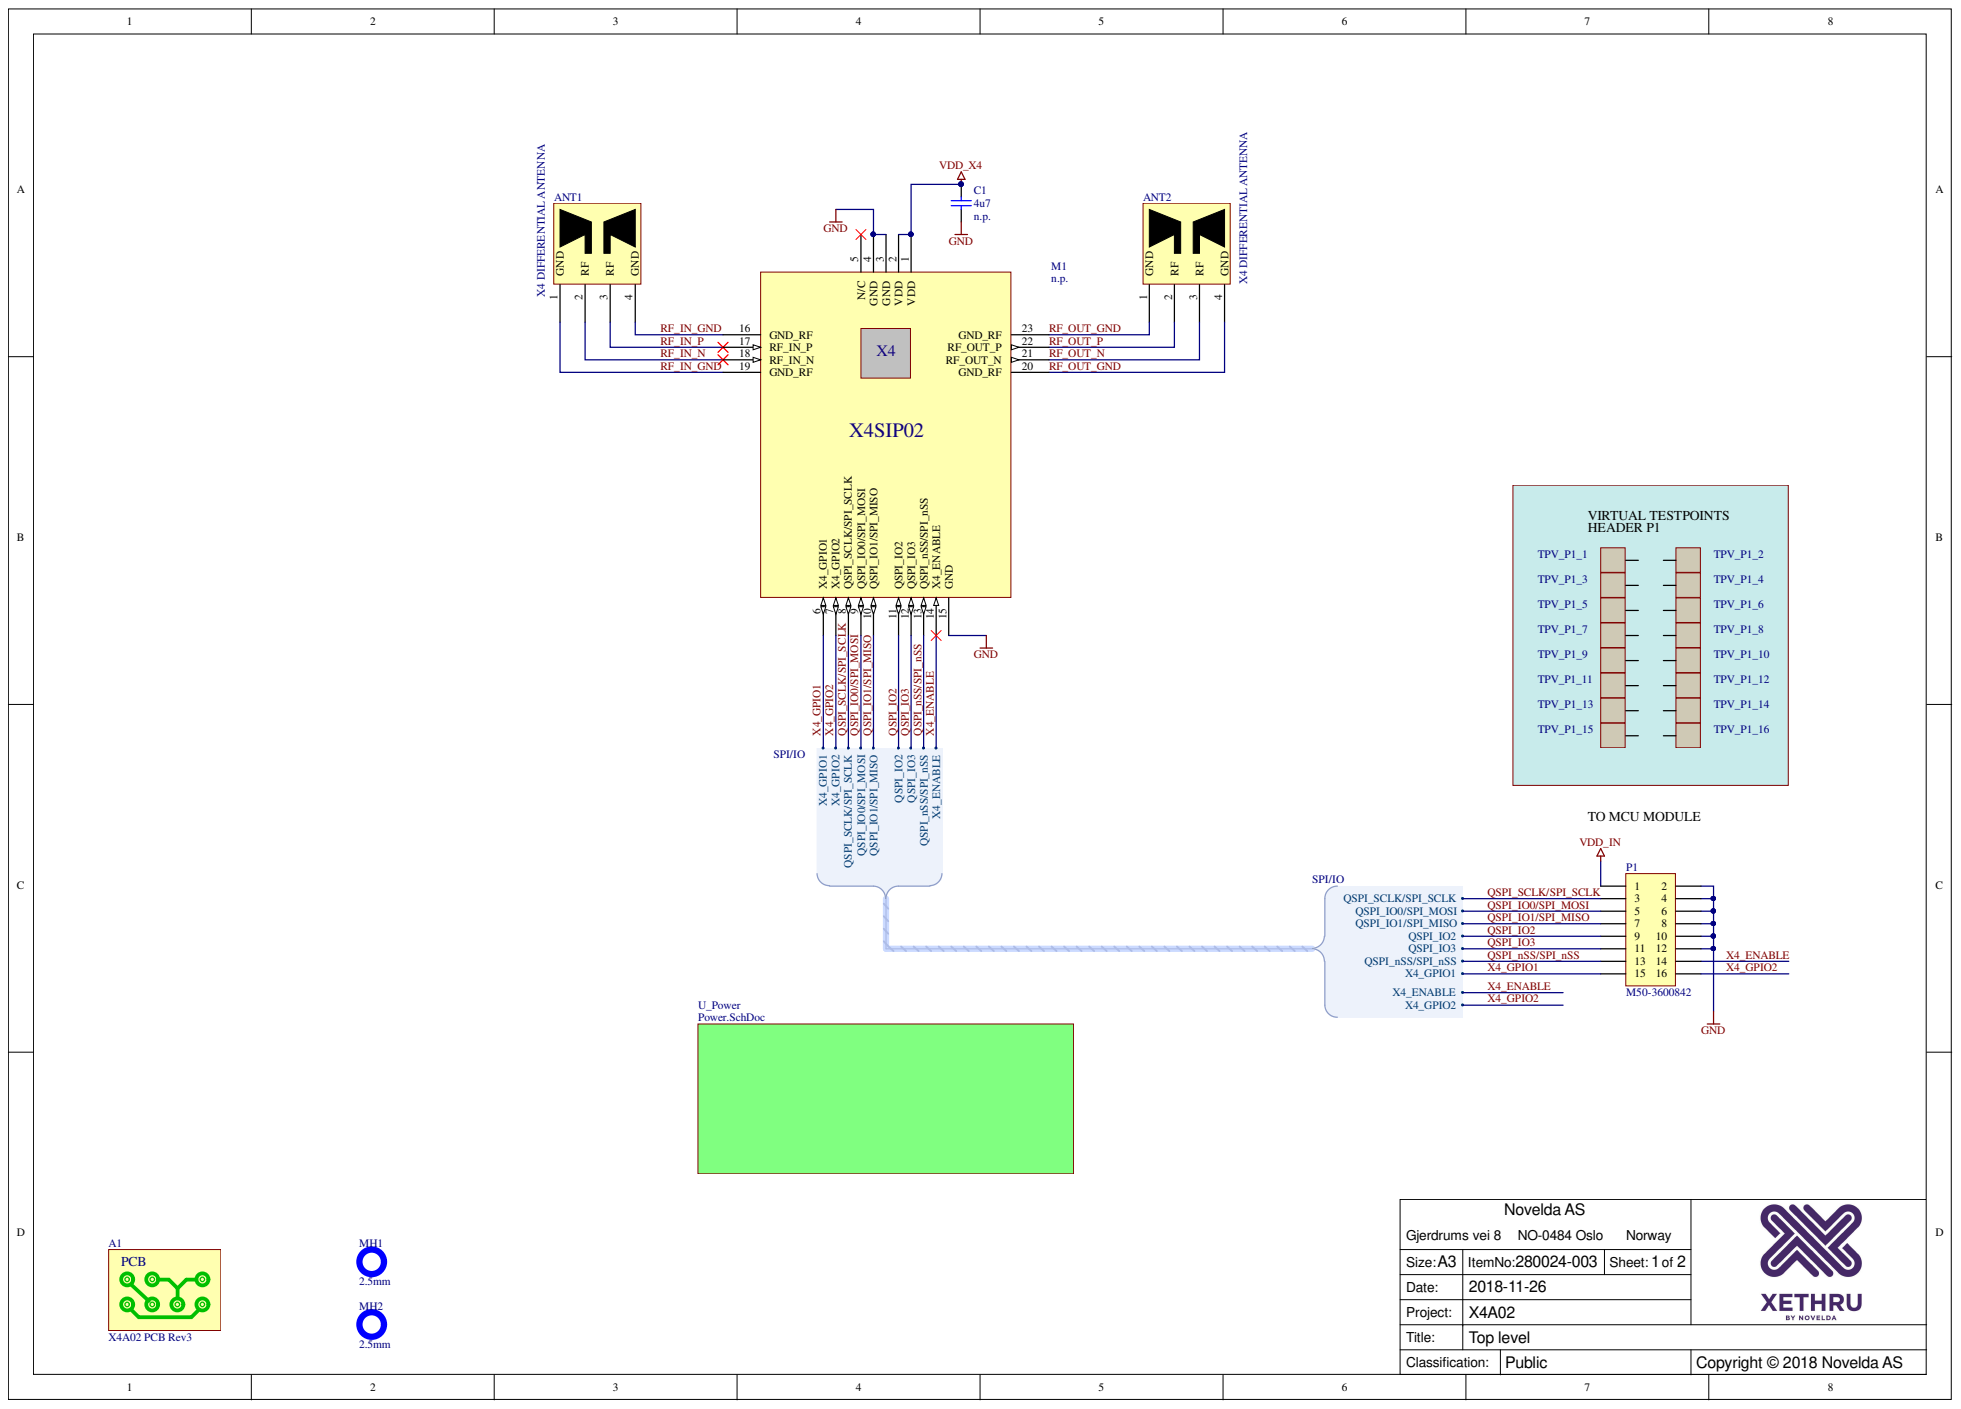
[picture p9: page 6]

Date: | 2018-11-26

Project: | X4A02
Title: | Top level
Classification: | Public | Copyright © 2018 Novelda AS

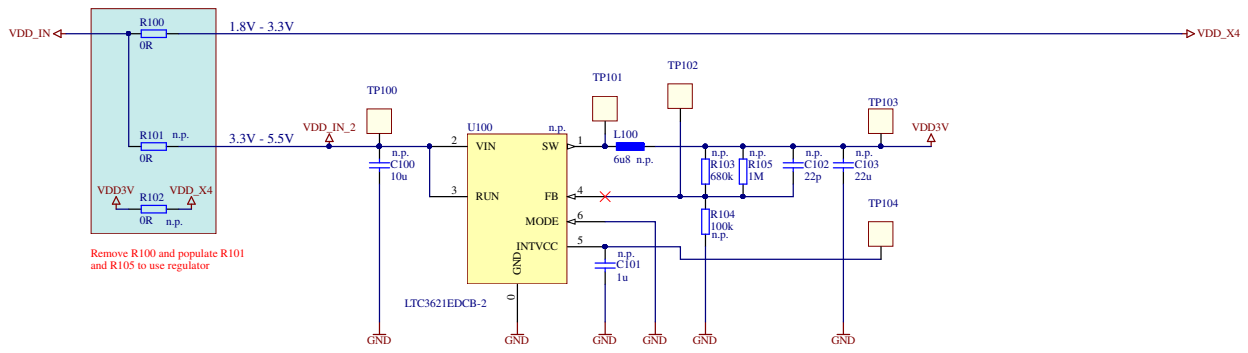
[picture p10: page 7]

Remove R100 and populate R101
and R105 to use regulator

n.p.
C101 1u

Novelda AS Gjerdrums vei 8 NO-0484 Oslo Norway

Size:A3 | ItemNo:280024-003 | Sheet: 2of 2
Date: | 2018-11-26

Project: | X4A02

Title: | Power
Classification: | Public | Copyright © 2018 Novelda AS

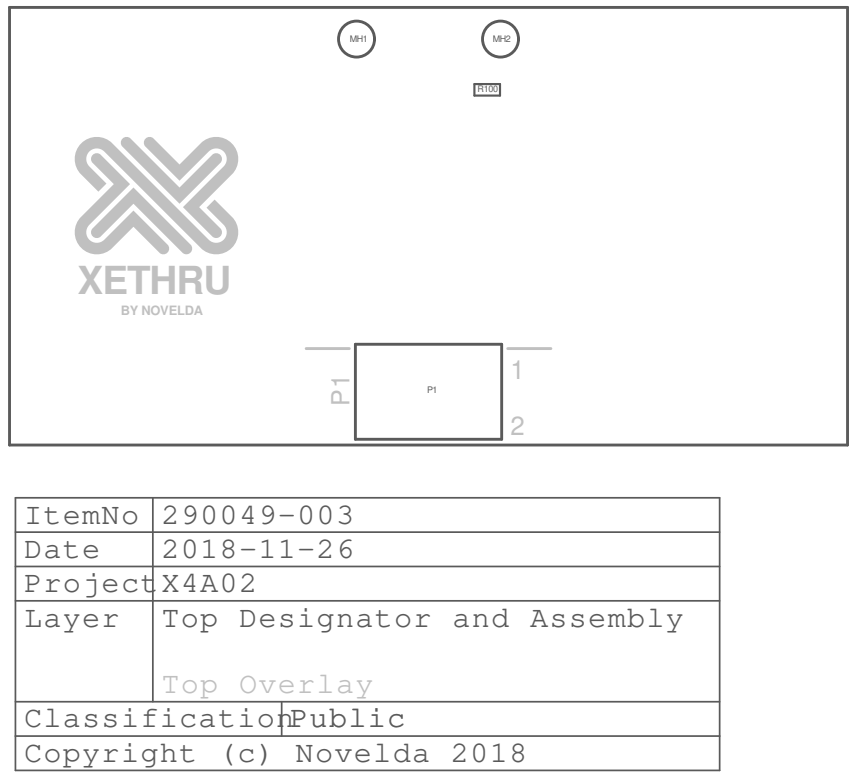
[picture p11: page 8]

ItemNo | 290049-003
Date | 2018-11-26
Project | X4A02
Layer | Top Designator and Assembly Top Overlay

Classification | Public

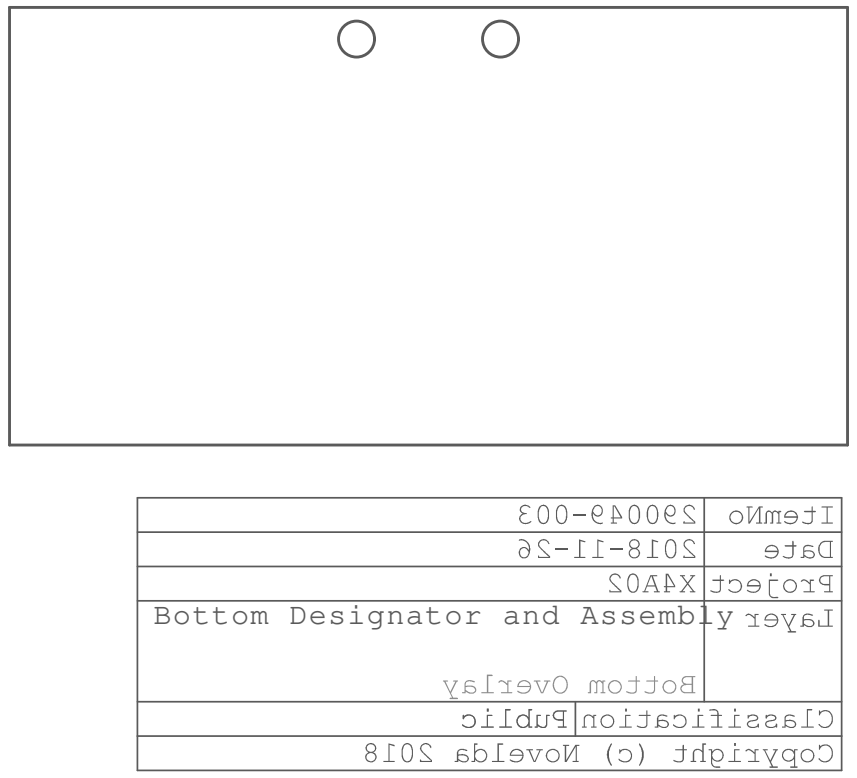
[picture p12: page 9]

Bottom Designator and Assembly

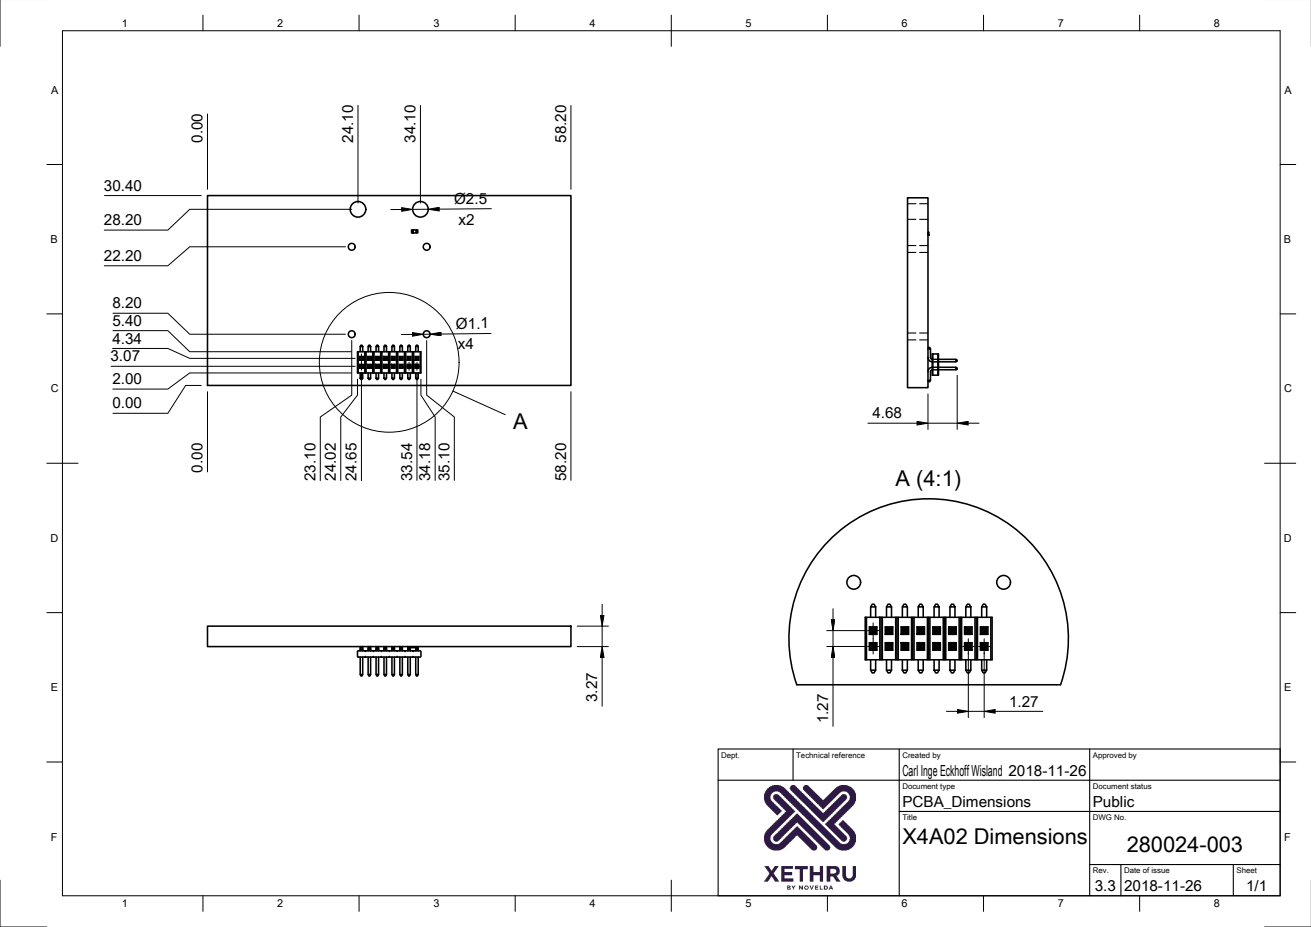
[picture p13: page 10]

Dept. | Technical reference | Created by Carl Inge Eckhoff Wisland 2018-11-26 | Approved by

Document type PCBA_Dimensions | Document status Public

Title | DWG No. 280024-003 X4A02 Dimensions

Rev. 3.3 2018-11-26 | Date of issue | Sheet 1/1

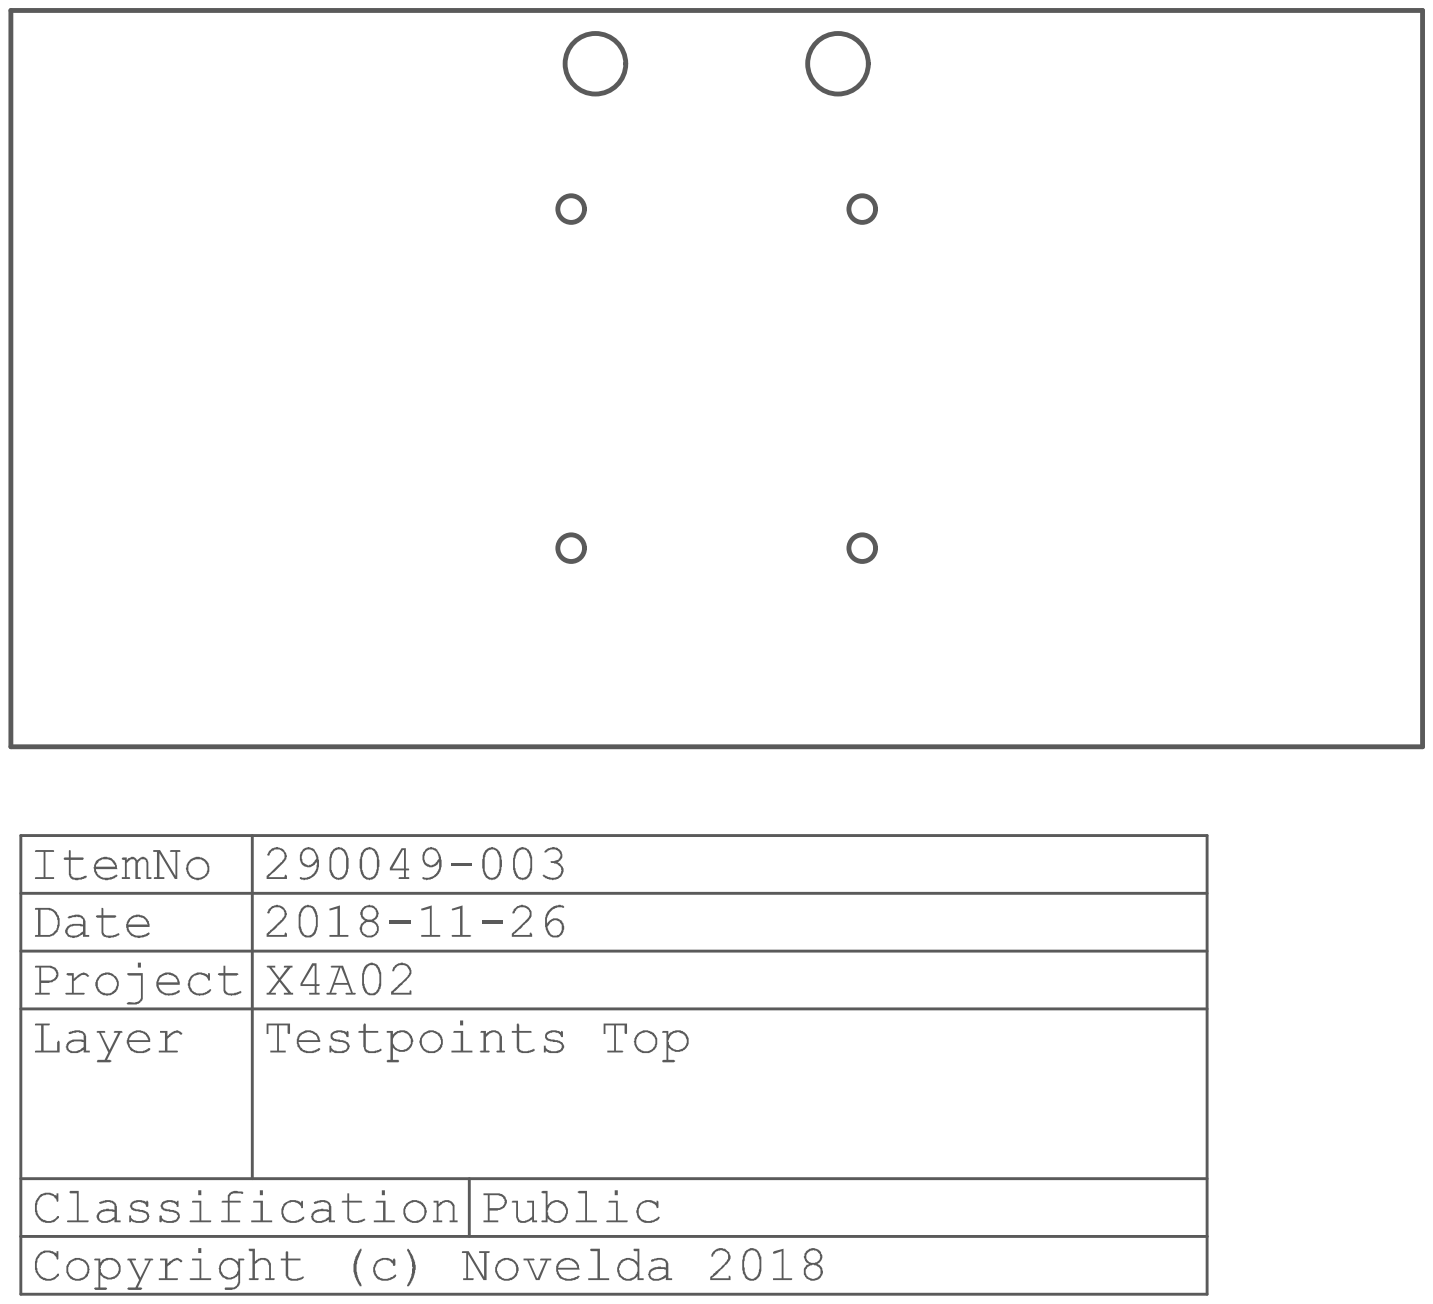
[picture p14: page 11]

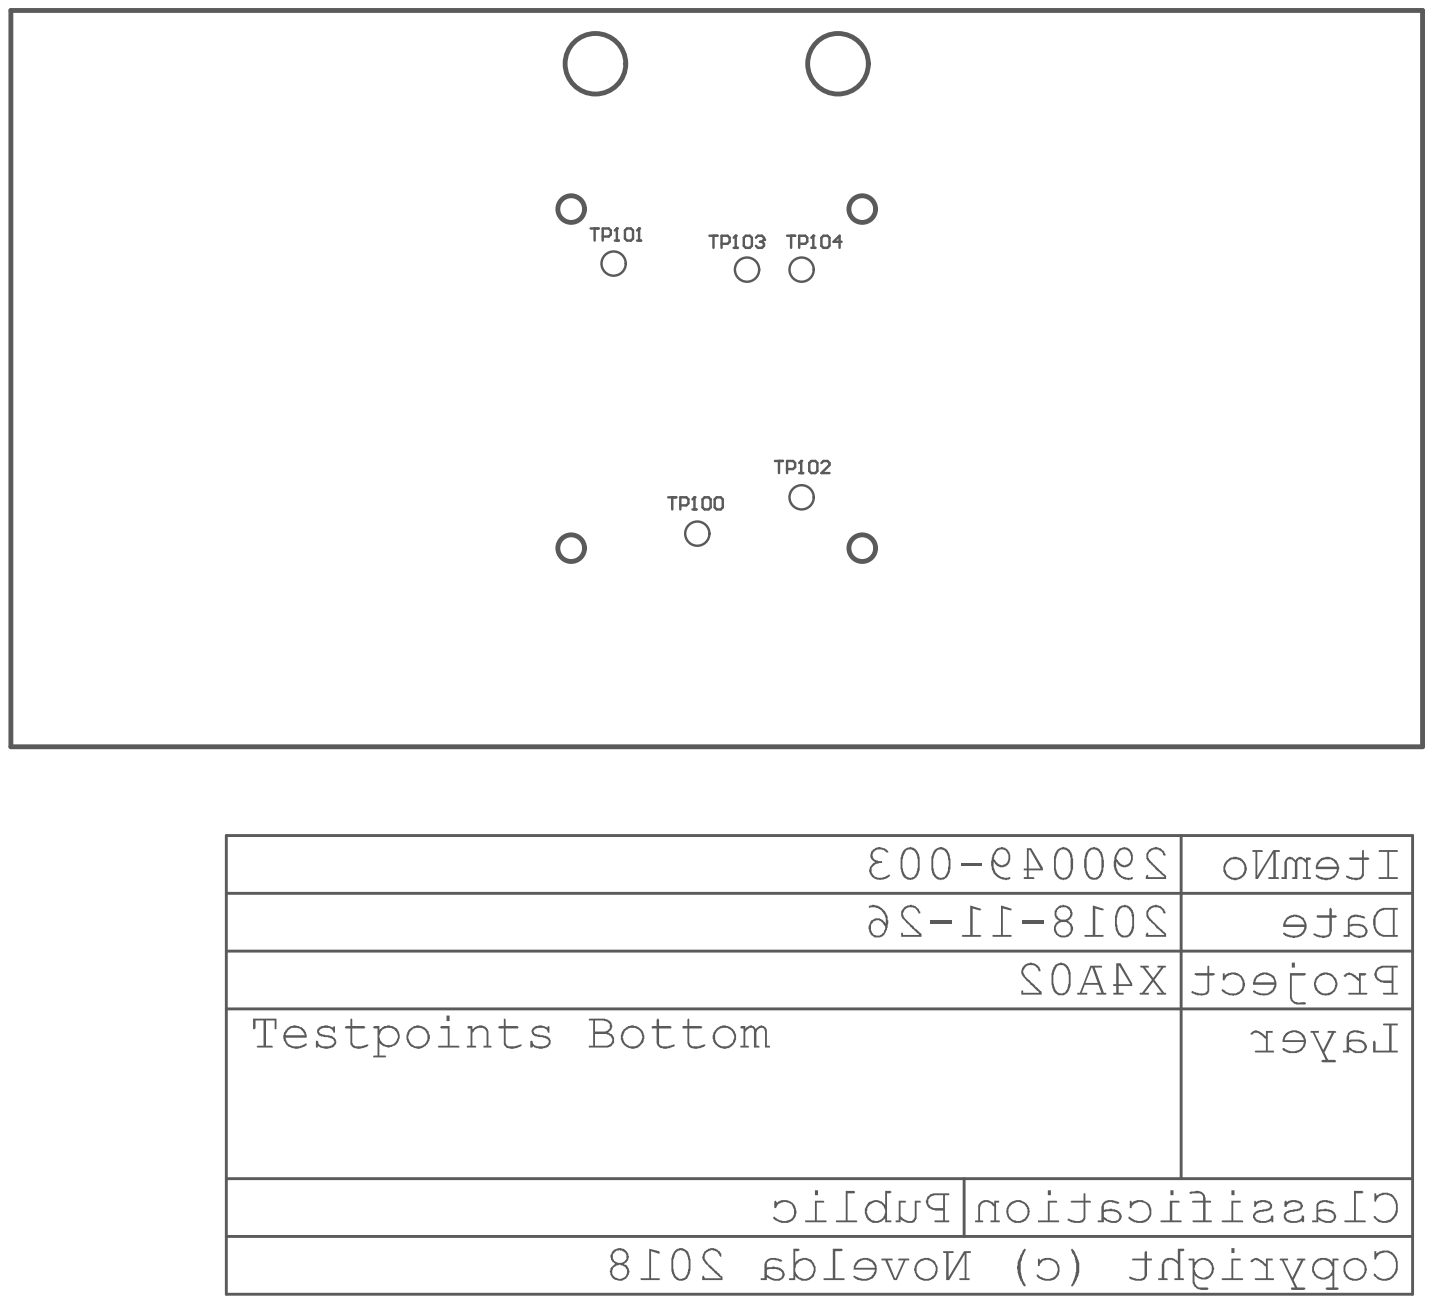
[picture p15: page 12]
