novelda/Legacy-HW/X4M02-PCBA-Rev10_2_Design_Documentation_Public/PCBA_Doc_280031-010/PCBA_Doc-280031-010.PDF

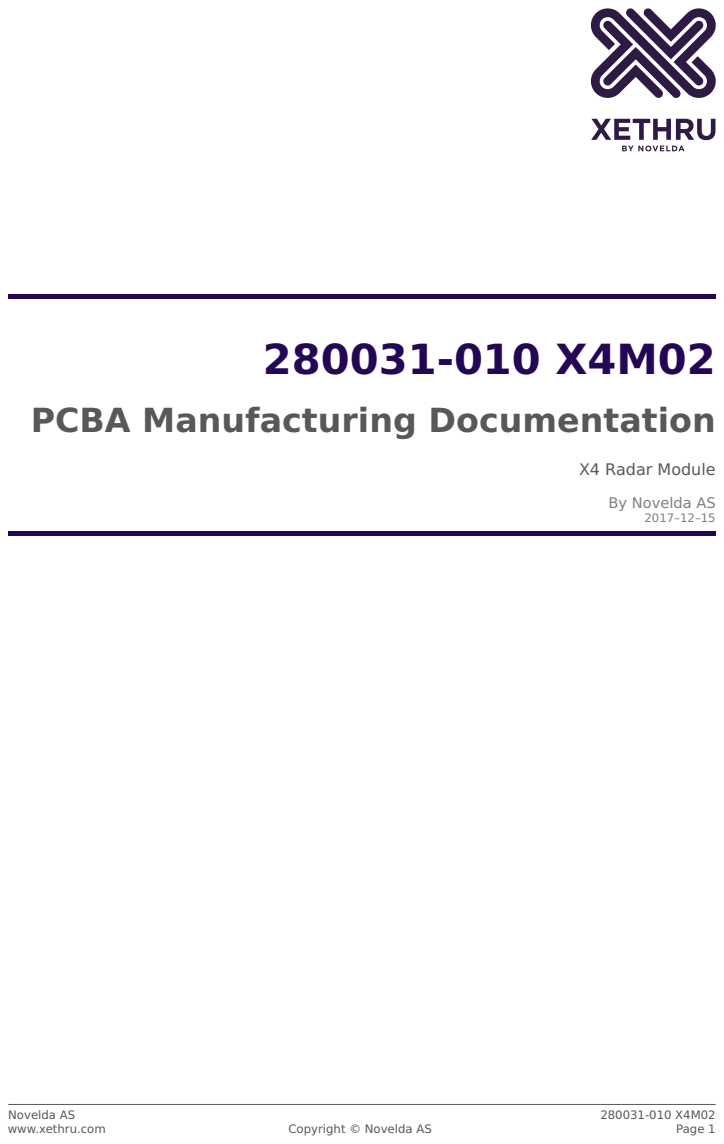
[picture p16: page 1]

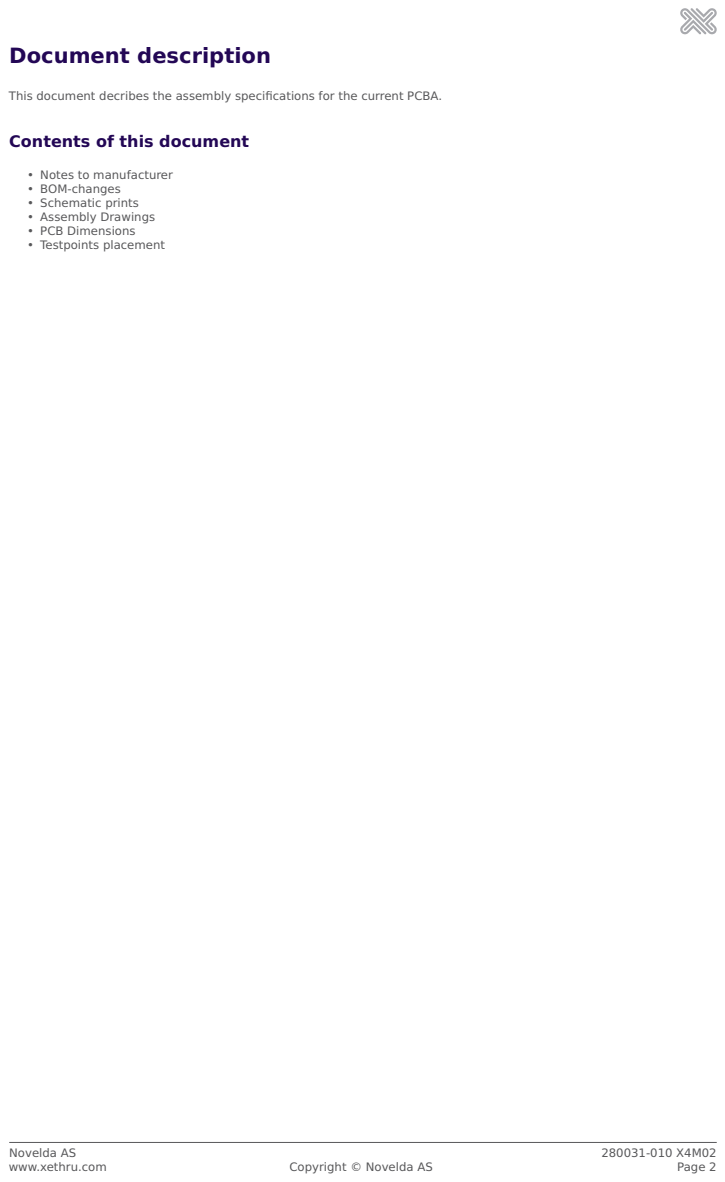
[picture p17: page 2]

This document decribes the assembly specifications for the current PCBA.

Contents of this document

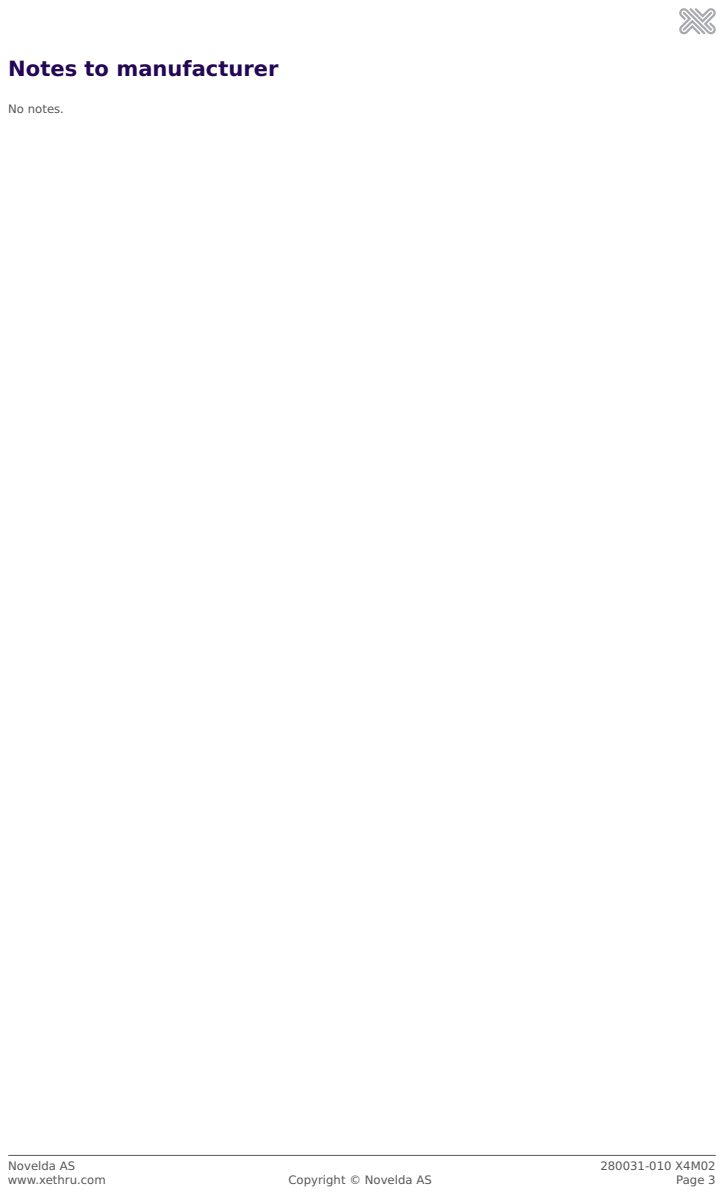
[picture p18: page 3]

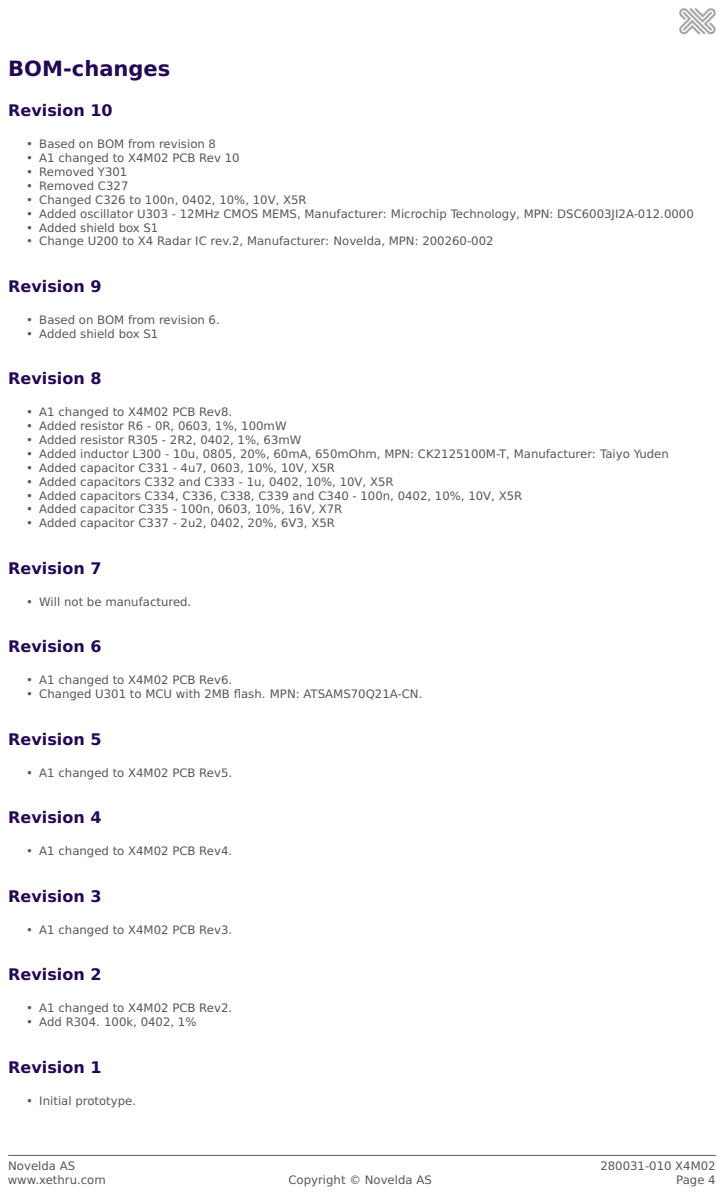
[picture p19: page 4]

• Based on BOM from revision 8
• A1 changed to X4M02 PCB Rev 10
• Removed Y301
• Removed C327
• Changed C326 to 100n, 0402, 10%, 10V, X5R
• Added oscillator U303 - 12MHz CMOS MEMS, Manufacturer: Microchip Technology, MPN: DSC6003JI2A-012.0000
• Added shield box S1
• Change U200 to X4 Radar IC rev.2, Manufacturer: Novelda, MPN: 200260-002

• Based on BOM from revision 6.

• A1 changed to X4M02 PCB Rev8.
• Added resistor R6 - 0R, 0603, 1%, 100mW
• Added resistor R305 - 2R2, 0402, 1%, 63mW
• Added inductor L300 - 10u, 0805, 20%, 60mA, 650mOhm, MPN: CK2125100M-T, Manufacturer: Taiyo Yuden
• Added capacitor C331 - 4u7, 0603, 10%, 10V, X5R
• Added capacitors C332 and C333 - 1u, 0402, 10%, 10V, X5R
• Added capacitors C334, C336, C338, C339 and C340 - 100n, 0402, 10%, 10V, X5R
• Added capacitor C335 - 100n, 0603, 10%, 16V, X7R
• Added capacitor C337 - 2u2, 0402, 20%, 6V3, X5R

• Will not be manufactured.

• A1 changed to X4M02 PCB Rev6.
• Changed U301 to MCU with 2MB flash. MPN: ATSAMS70Q21A-CN.

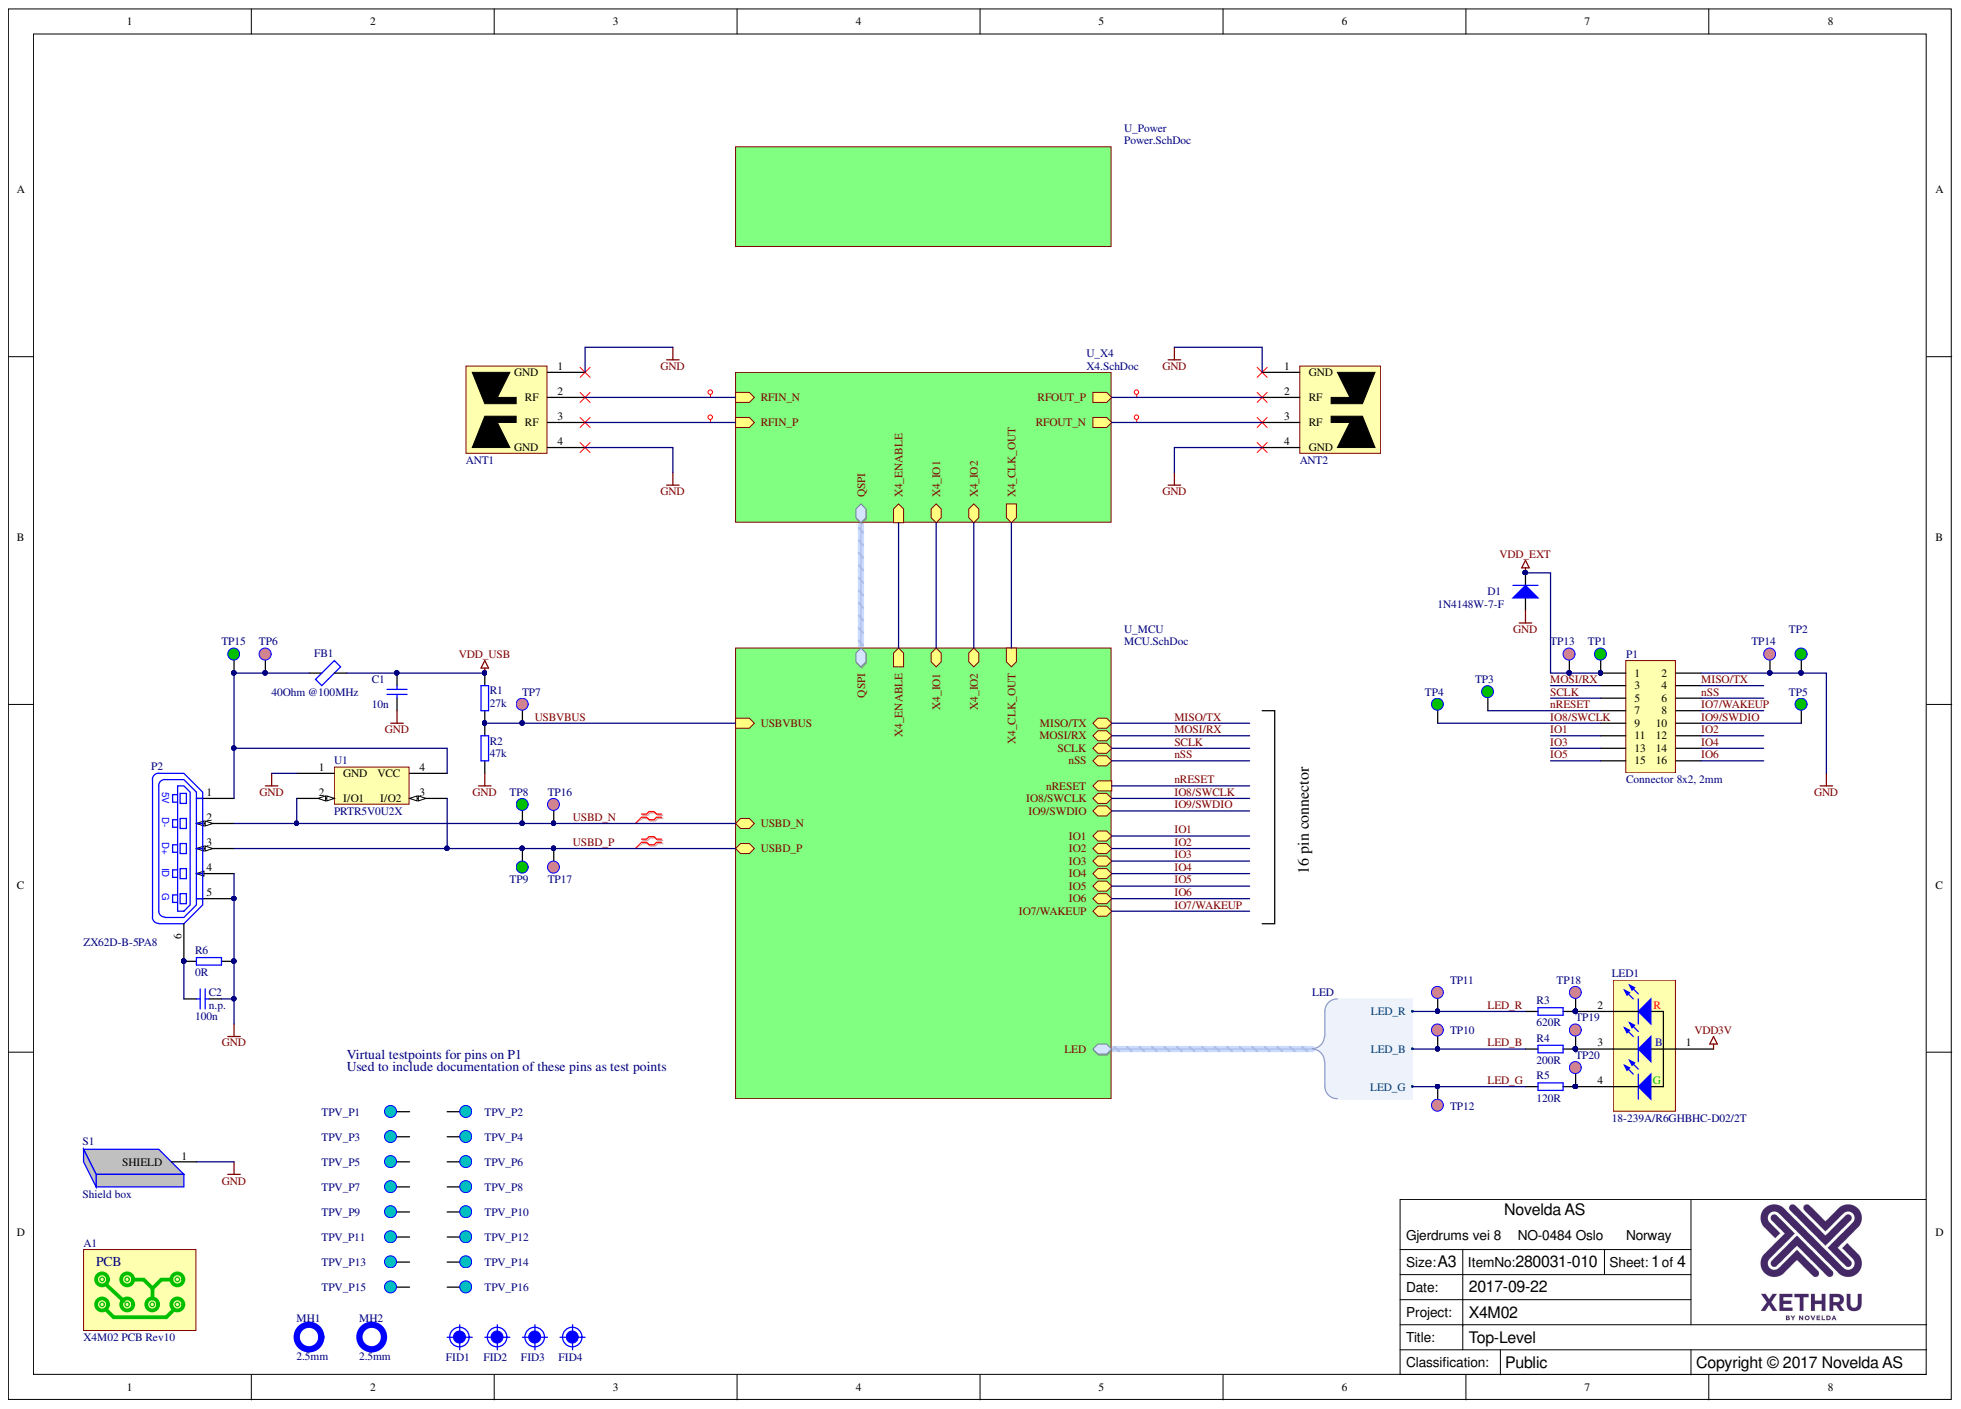
[picture p20: page 5]

U1
GND 1 I/O1 2

Virtual testpoints for pins on P1
Used to include documentation of these pins as test points

Date: | 2017-09-22

Project: | X4M02
Title: | Top-Level
Classification: | Public | Copyright © 2017 Novelda AS

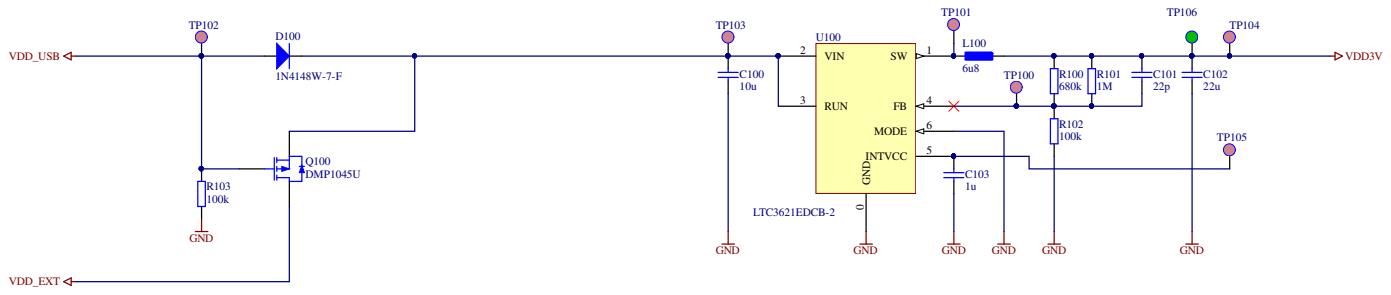
[picture p21: page 6]

Novelda AS Gjerdrums vei 8 NO-0484 Oslo Norway

Size:A3 | ItemNo:280031-010 | Sheet: 2of 4
Date: | 2017-09-22

Project: | X4M02

Title: | Power
Classification: | Public | Copyright © 2017 Novelda AS

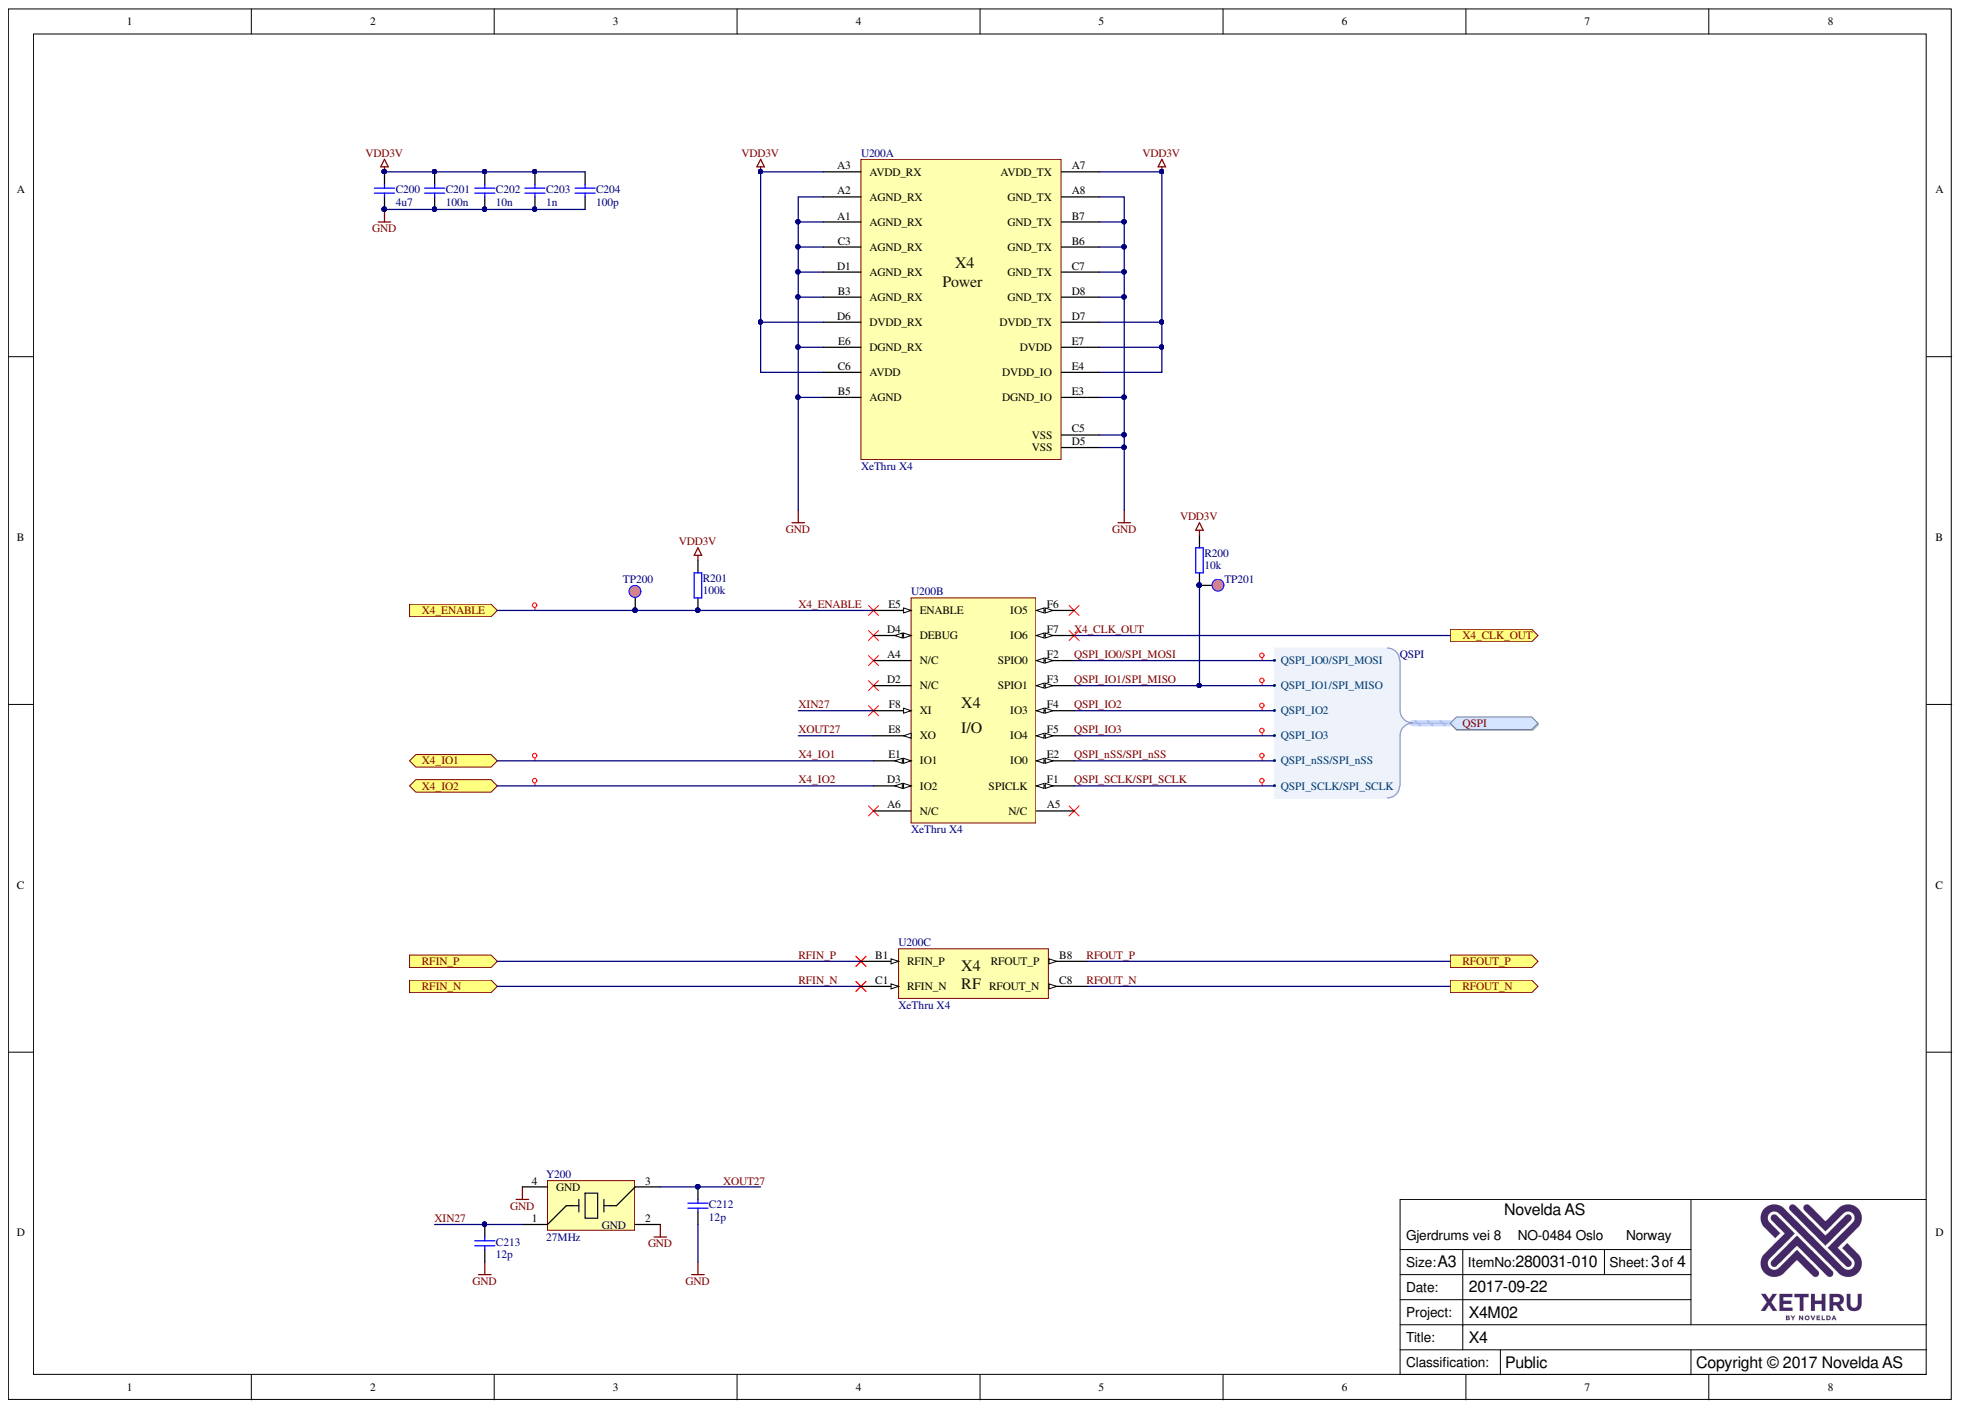
[picture p22: page 7]

Novelda AS Gjerdrums vei 8 NO-0484 Oslo Norway

Size:A3 | ItemNo:280031-010 | Sheet: 3of 4
Date: | 2017-09-22

Project: | X4M02

Title: | X4
Classification: | Public | Copyright © 2017 Novelda AS

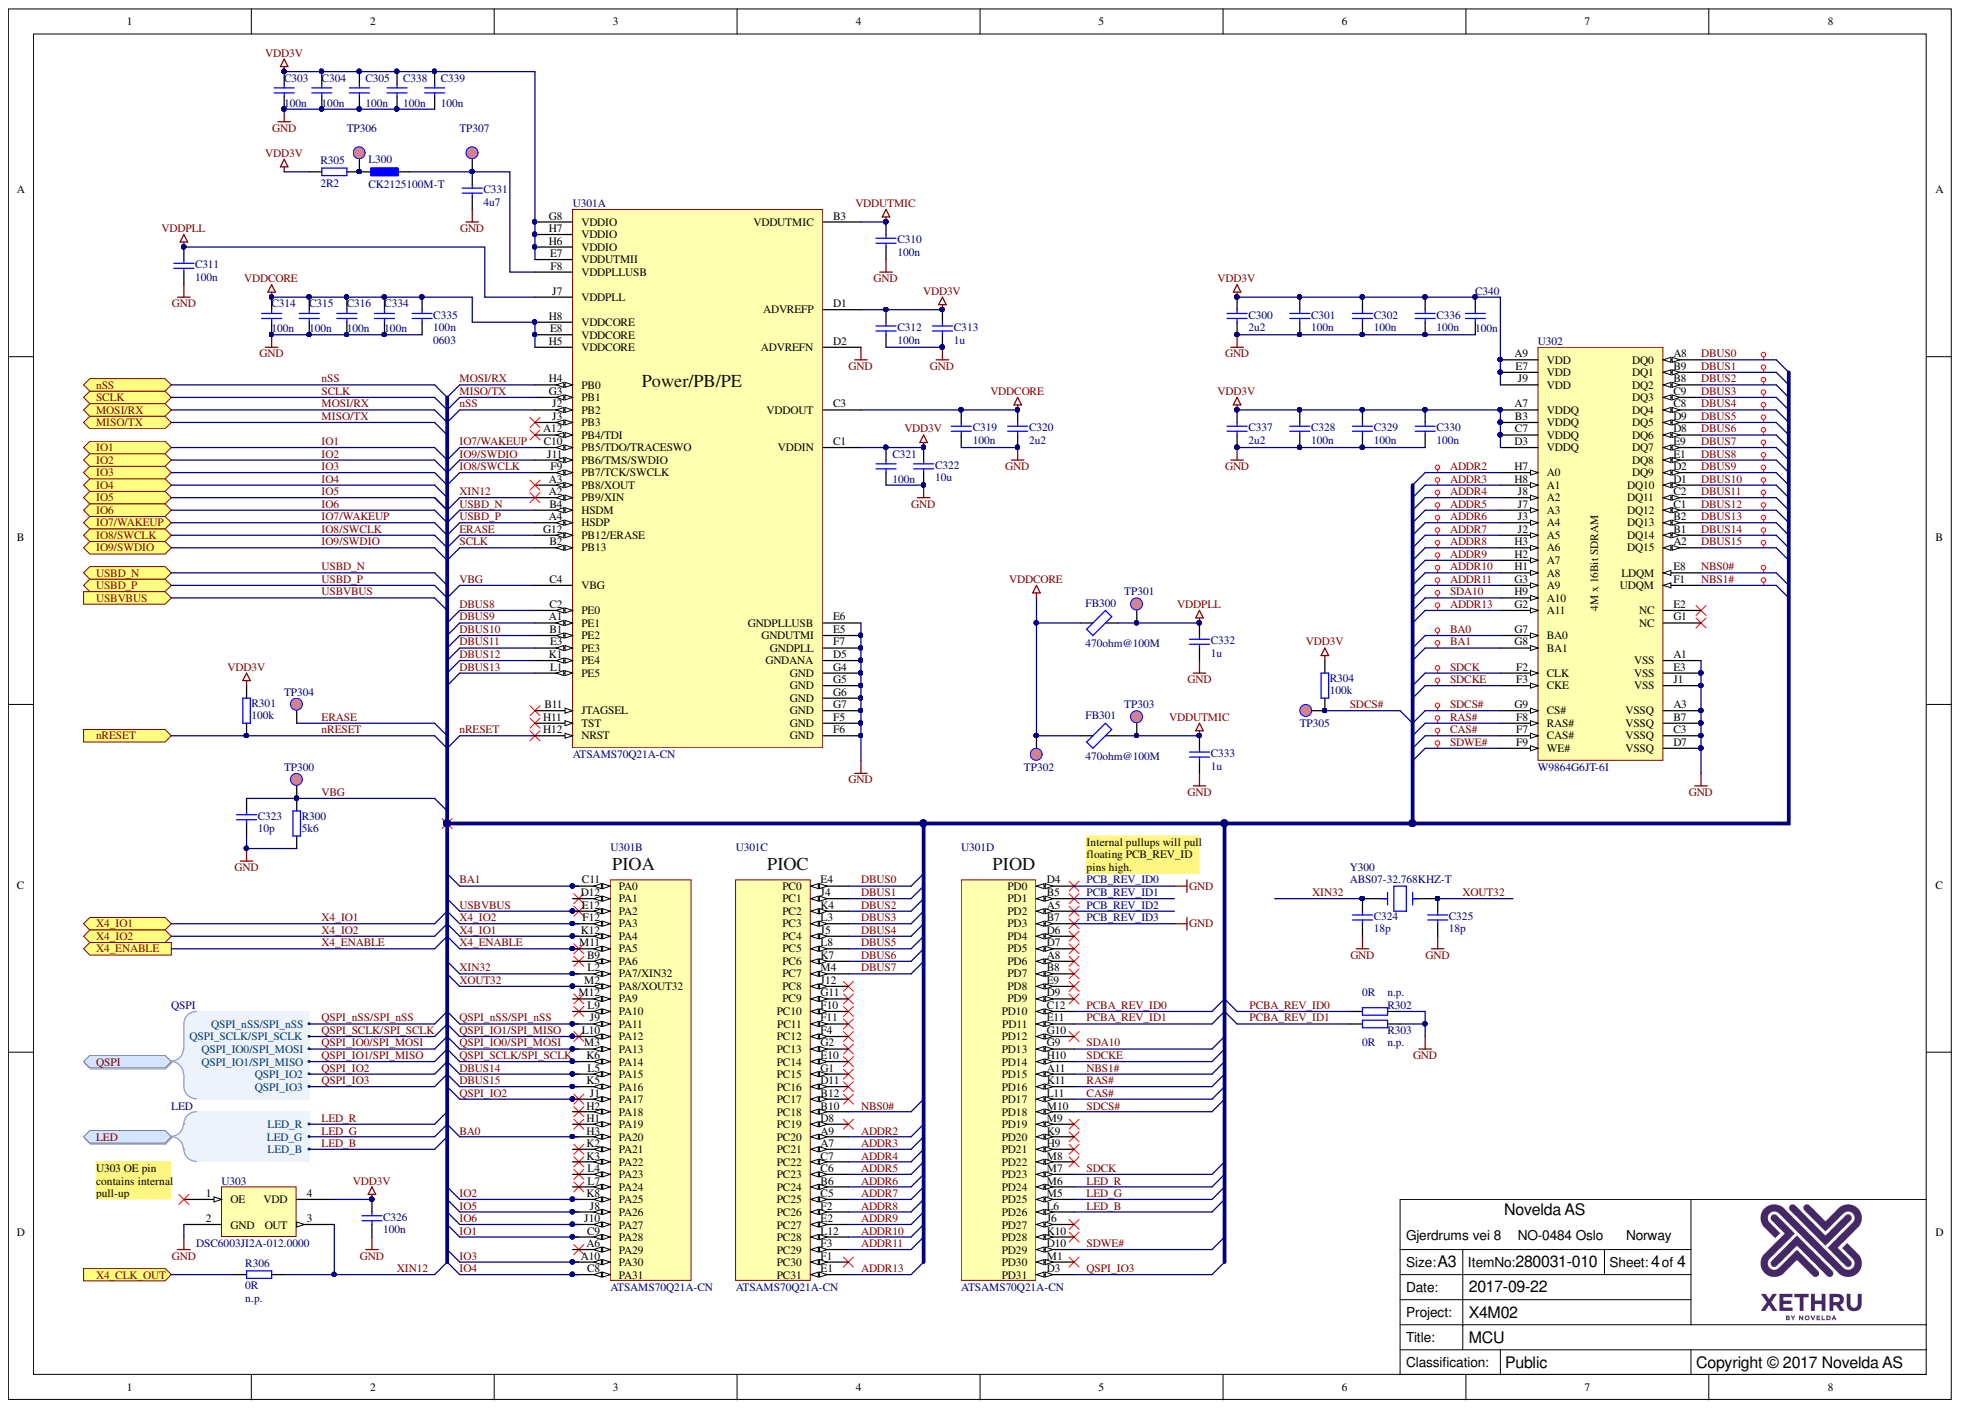
[picture p23: page 8]

Date: | 2017-09-22

Project: | X4M02

Title: | MCU
Classification: | Public | Copyright © 2017 Novelda AS

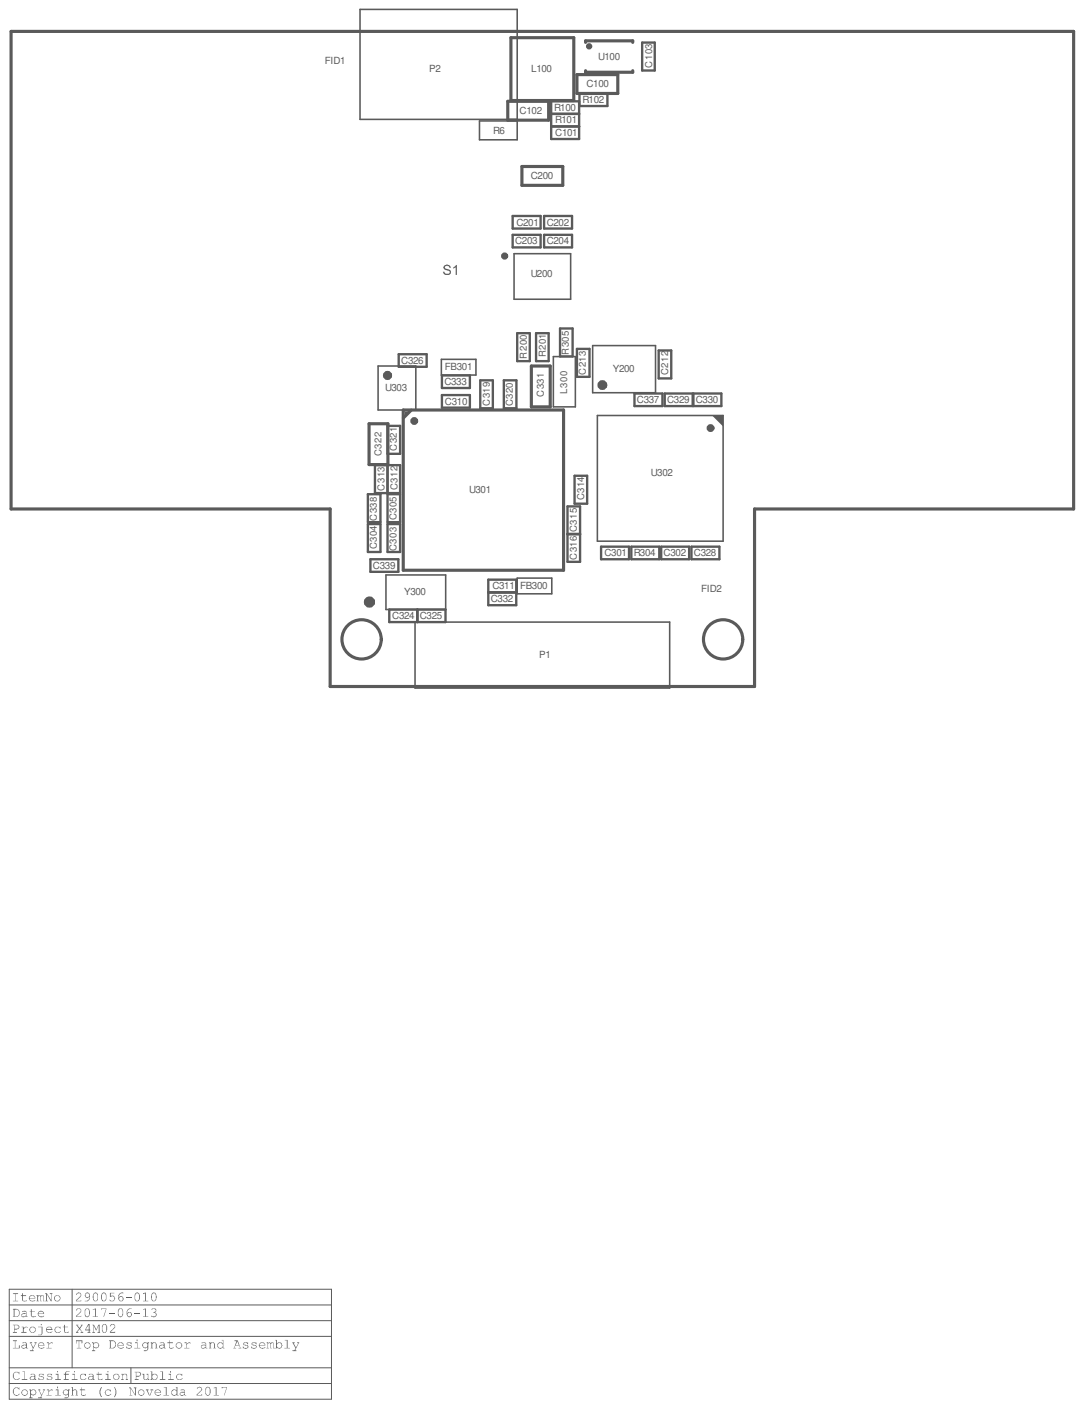
[picture p24: page 9]

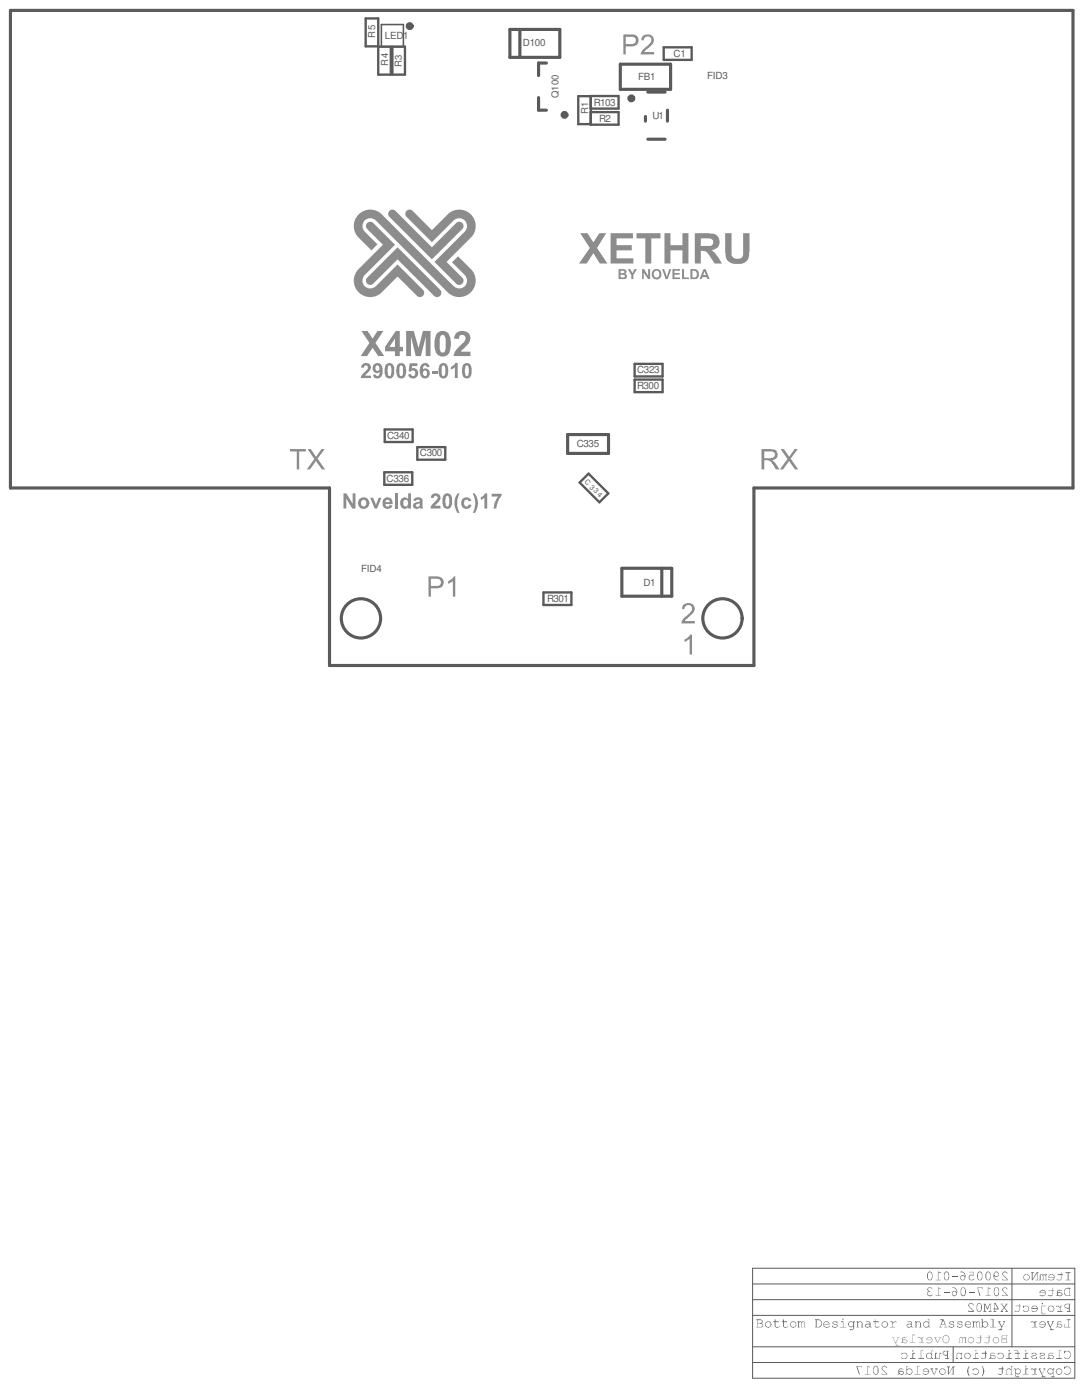
[picture p25: page 10]

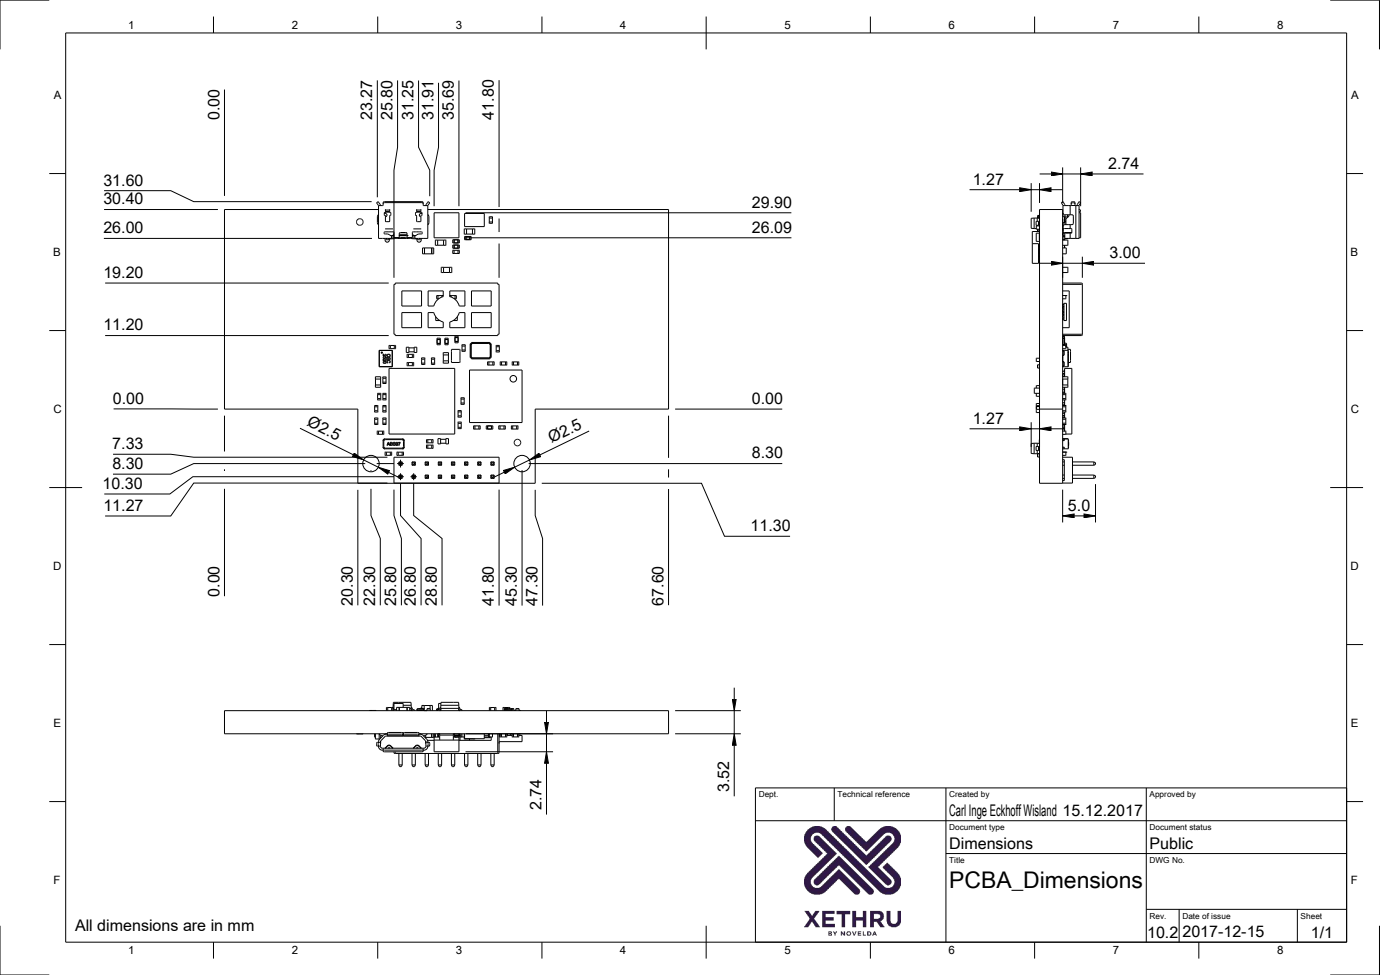
[picture p26: page 11]

Dept. | Technical reference | Created by Carl Inge Eckhoff Wisland 15.12.2017 | Approved by

Document type Dimensions | Document status Public

Title PCBA_Dimensions | DWG No.

Rev. 10.2 2017-12-15 | Date of issue | Sheet 1/1

All dimensions are in mm

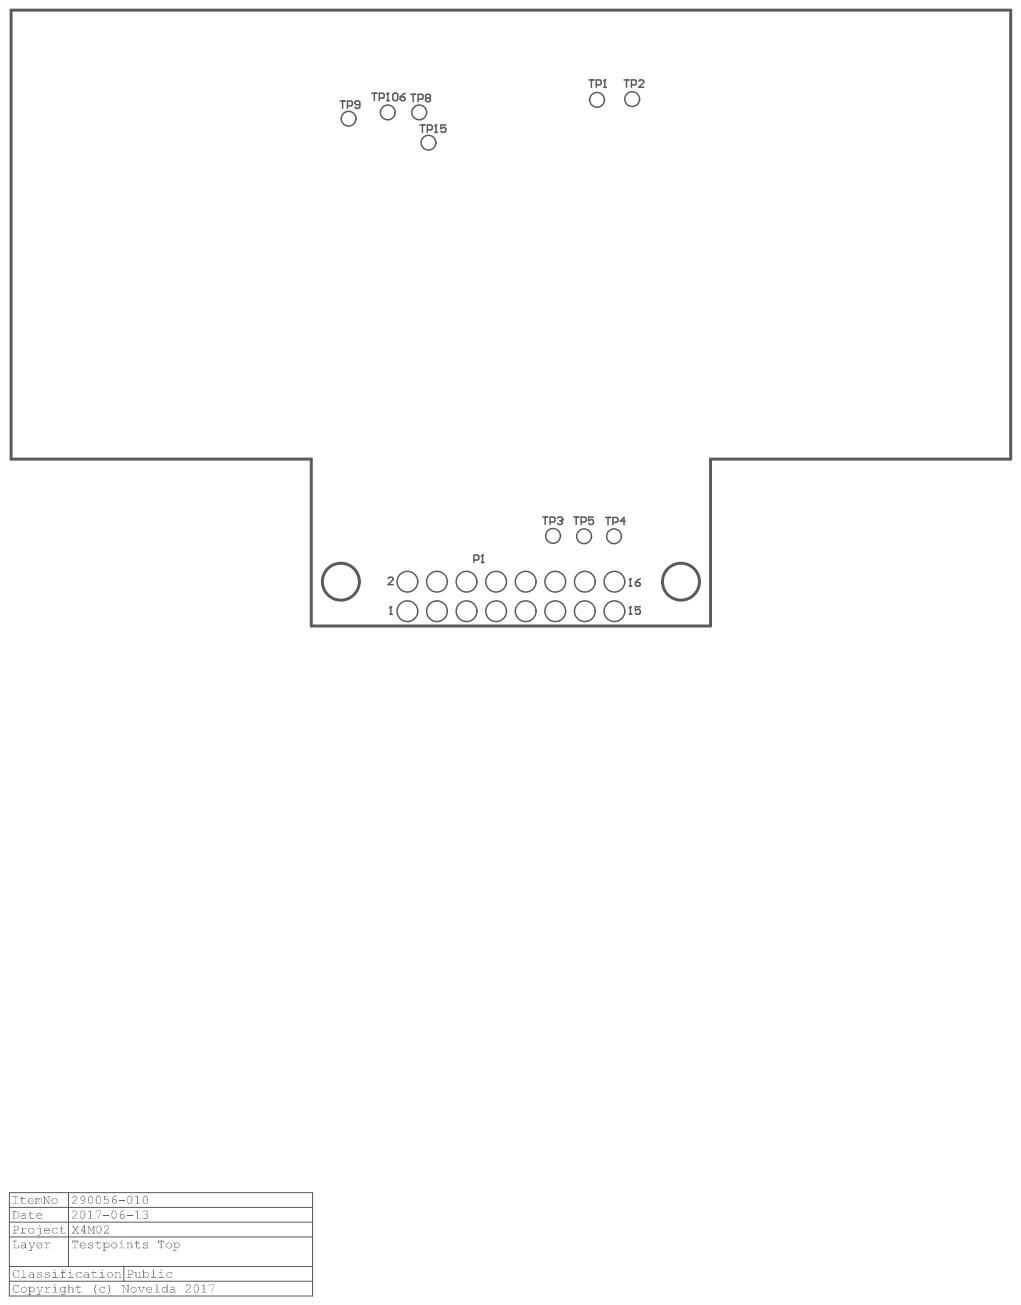
[picture p27: page 12]

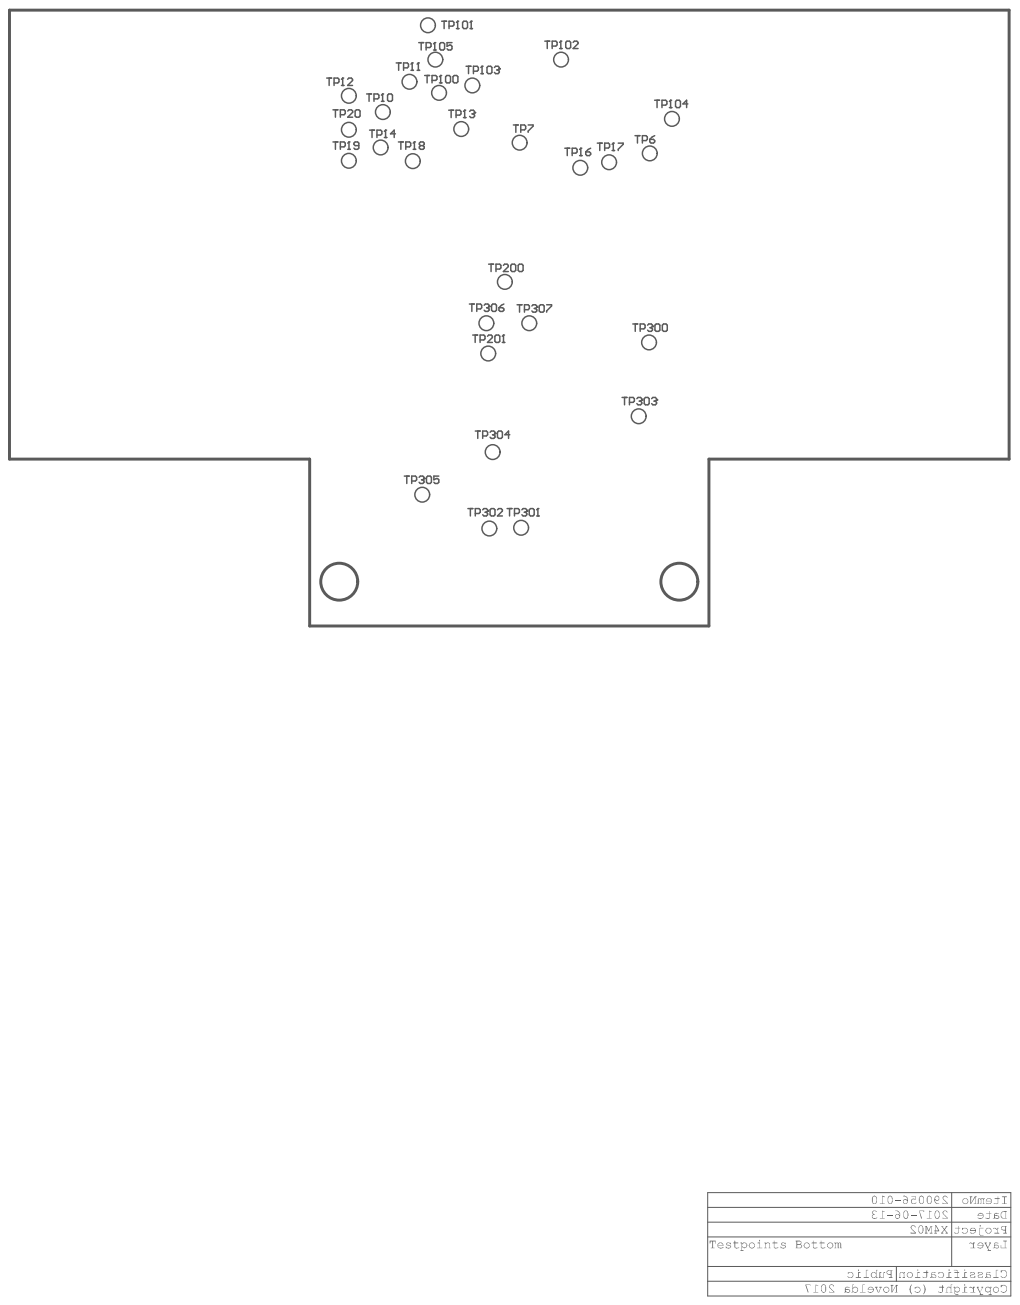
[picture p28: page 13]
