novelda/Legacy-HW/X4M05-Rev3_2_Design_Documentation_Public/PCBA_Doc_280040-003/PCBA_Doc-280040-003.PDF

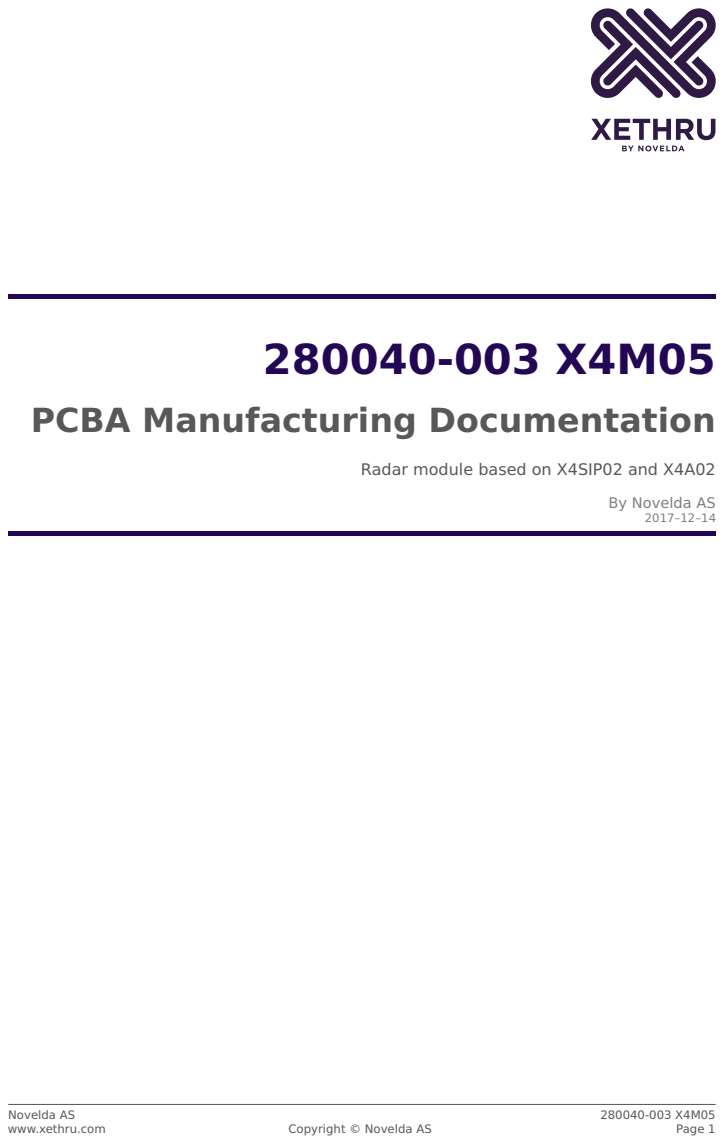
[picture p29: page 1]

Radar module based on X4SIP02 and X4A02

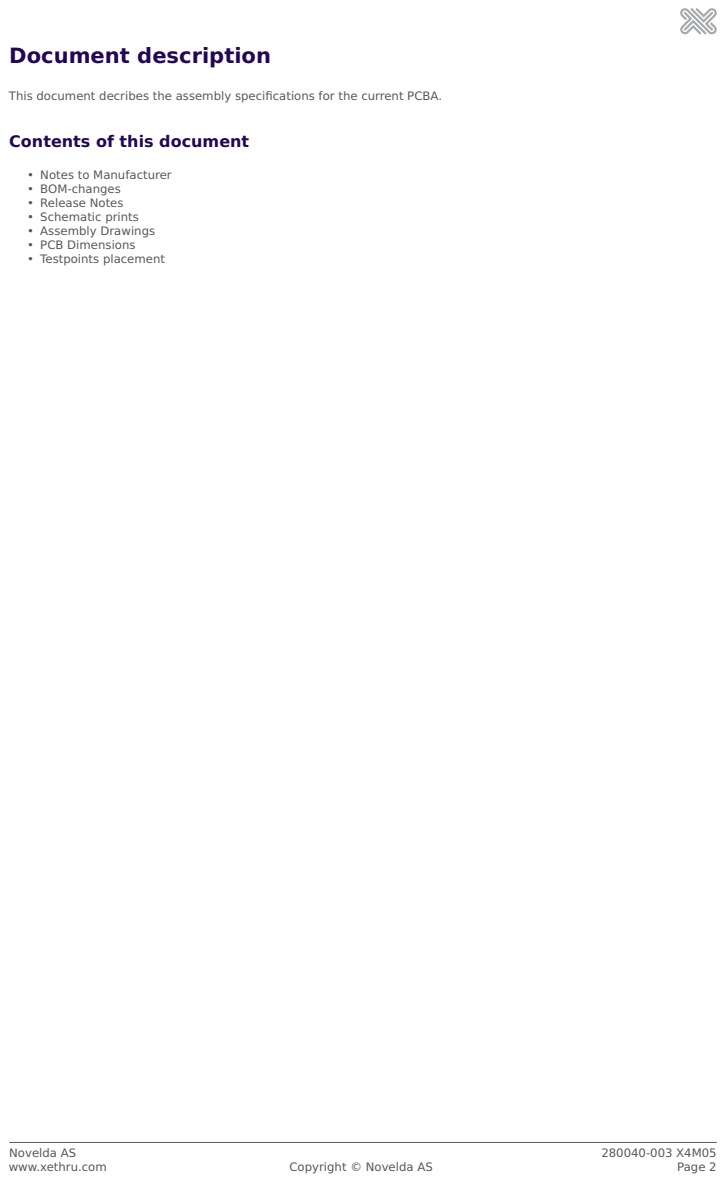
[picture p30: page 2]

This document decribes the assembly specifications for the current PCBA.

Contents of this document

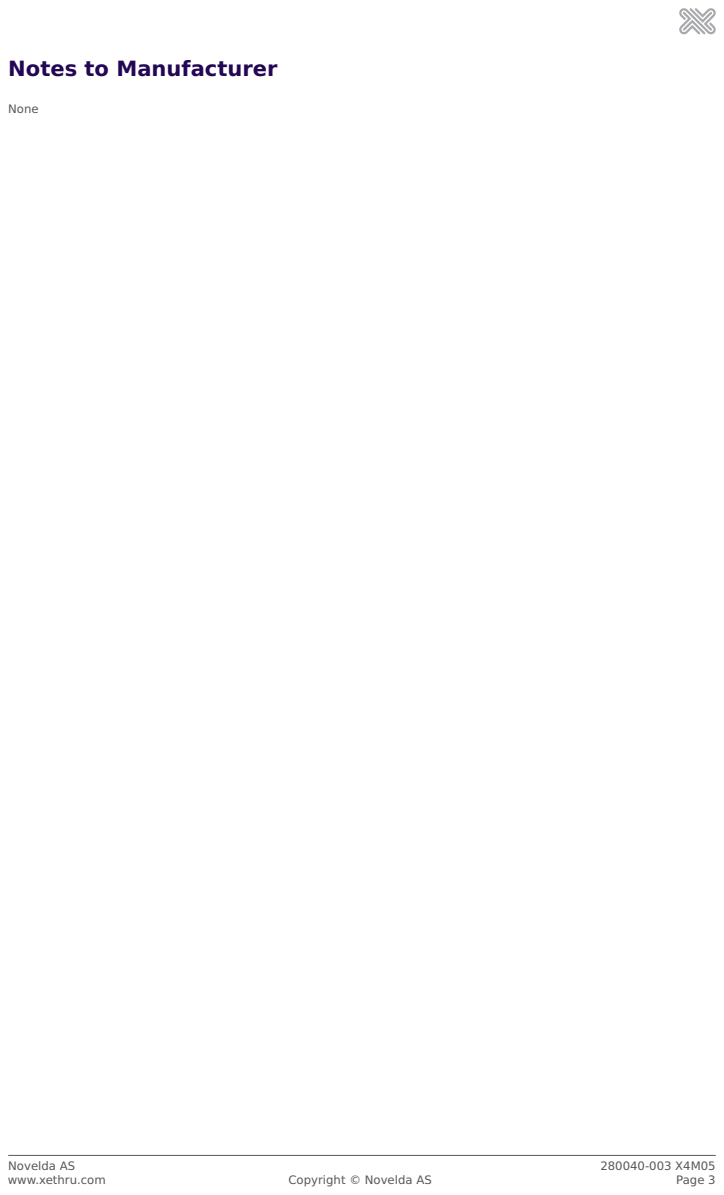
[picture p31: page 3]

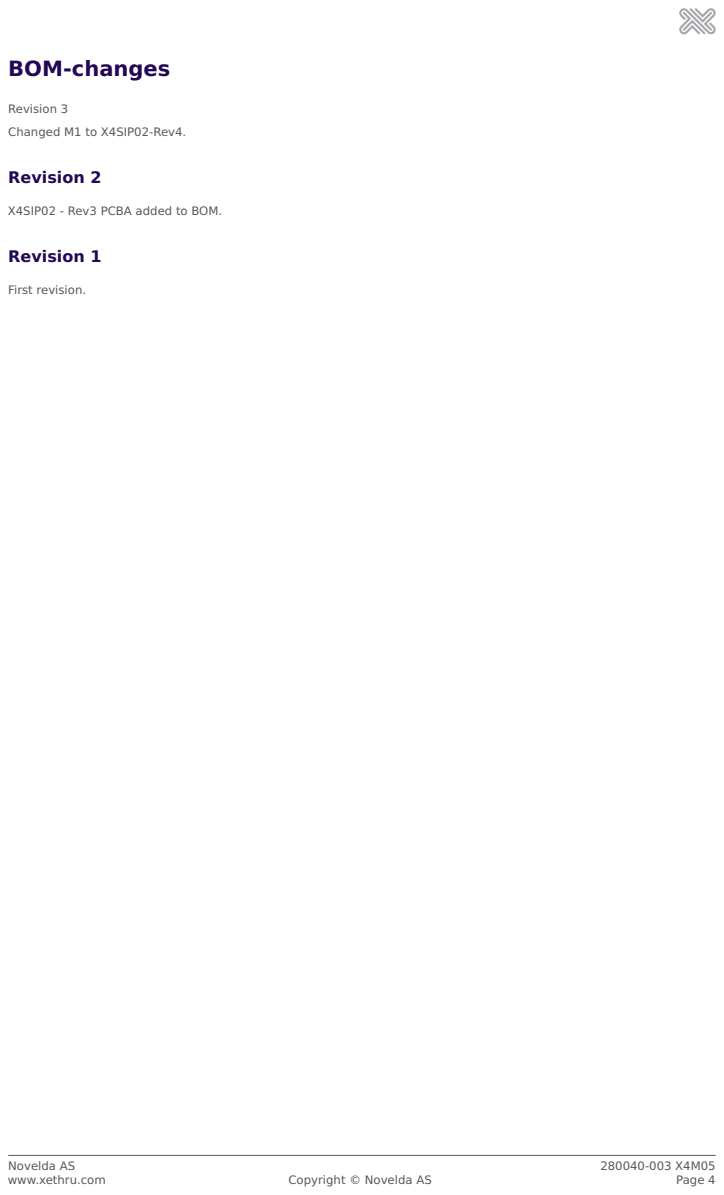
[picture p32: page 4]

X4SIP02 - Rev3 PCBA added to BOM.

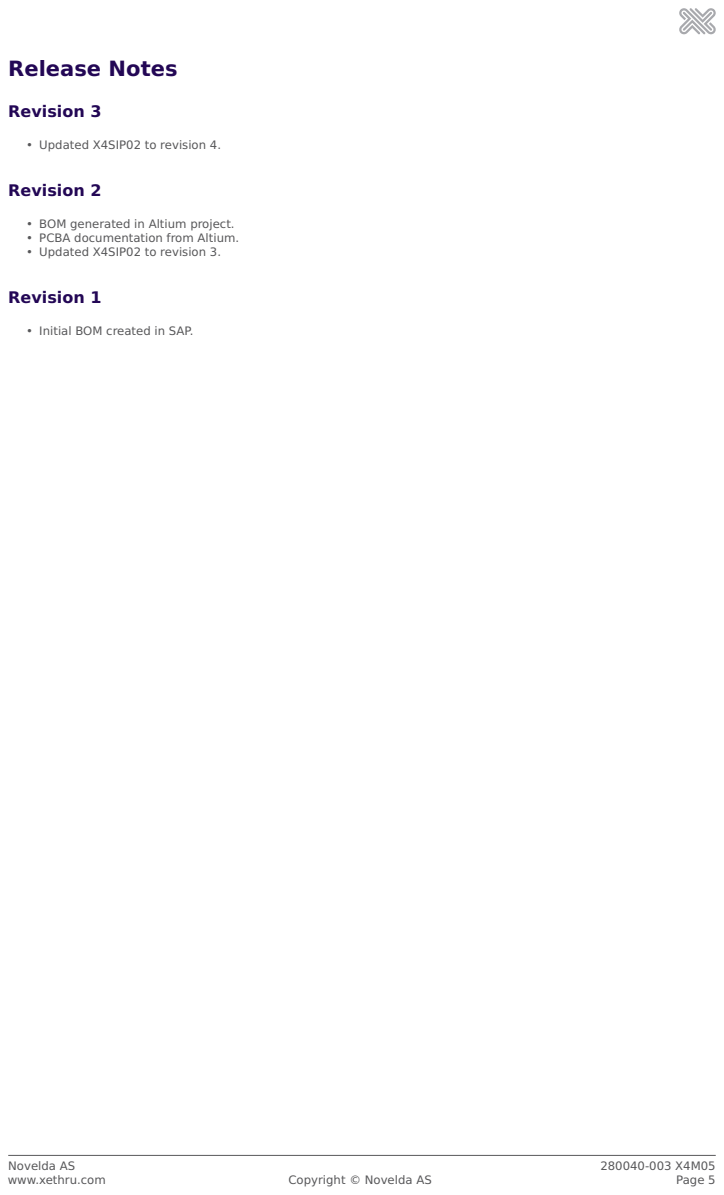
[picture p33: page 5]

• BOM generated in Altium project.
• PCBA documentation from Altium.
• Updated X4SIP02 to revision 3.

• Initial BOM created in SAP.

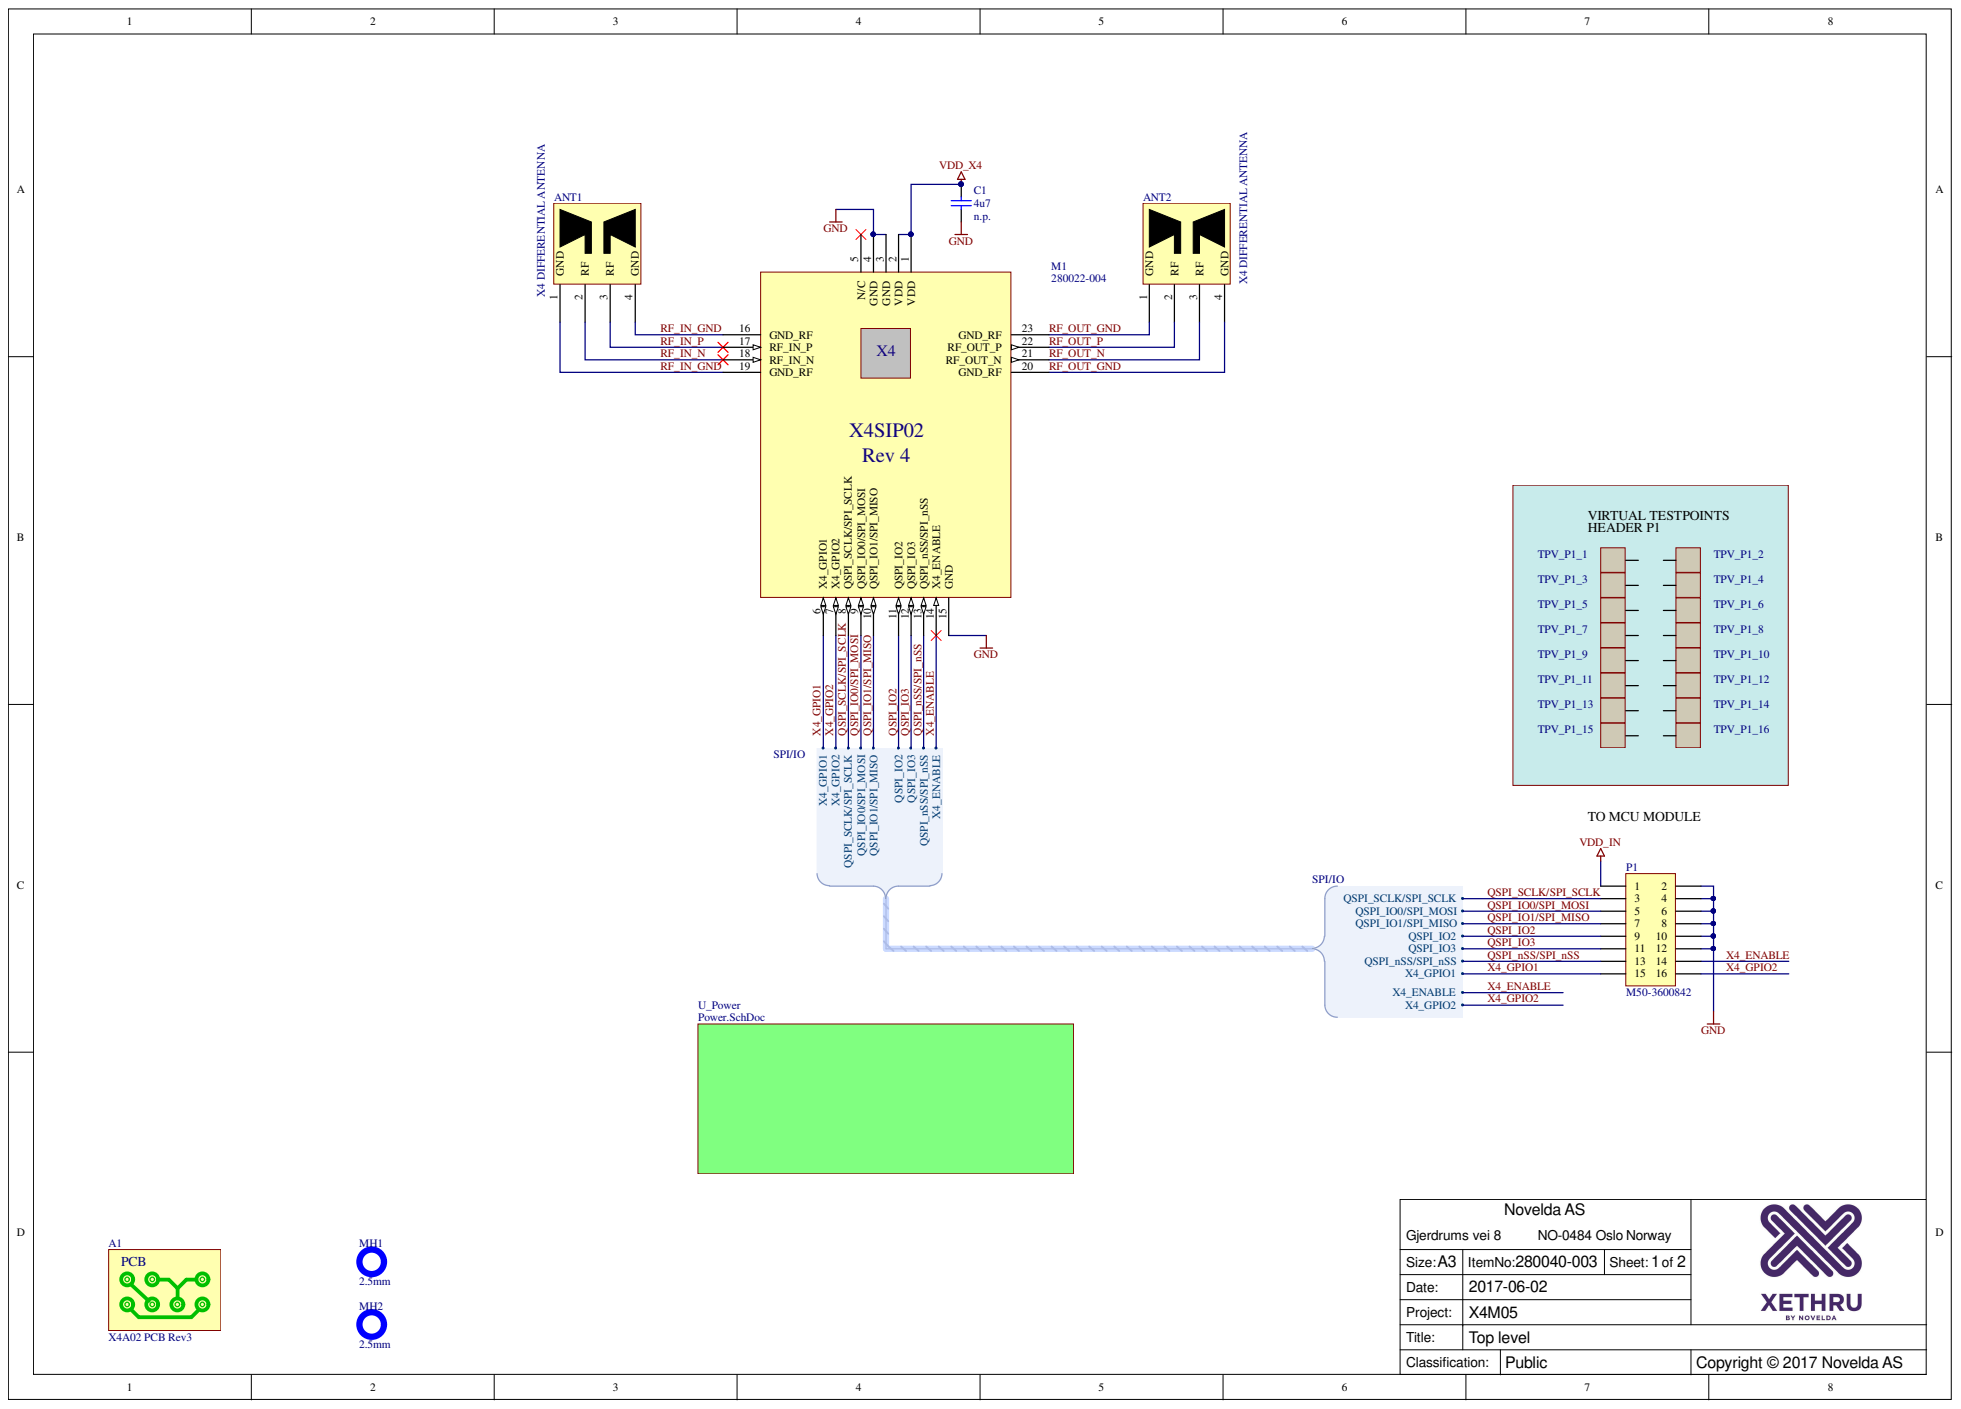
[picture p34: page 6]

Date: | 2017-06-02

Project: | X4M05
Title: | Top level
Classification: | Public | Copyright © 2017 Novelda AS

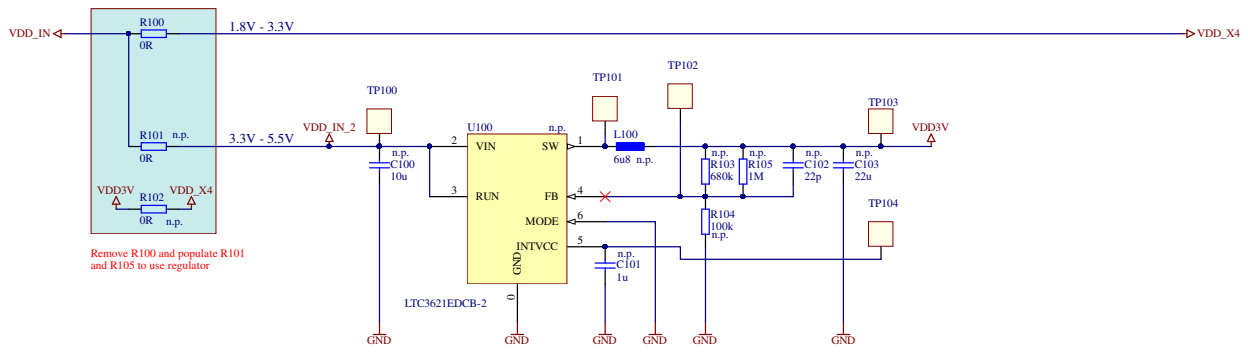
[picture p35: page 7]

Remove R100 and populate R101
and R105 to use regulator

n.p.
C101 1u

Novelda AS Gjerdrums vei 8 NO-0484 Oslo Norway

Size:A3 | ItemNo:280040-003 | Sheet: 2of 2
Date: | 2017-06-02

Project: | X4M05

Title: | Power
Classification: | Public | Copyright © 2017 Novelda AS

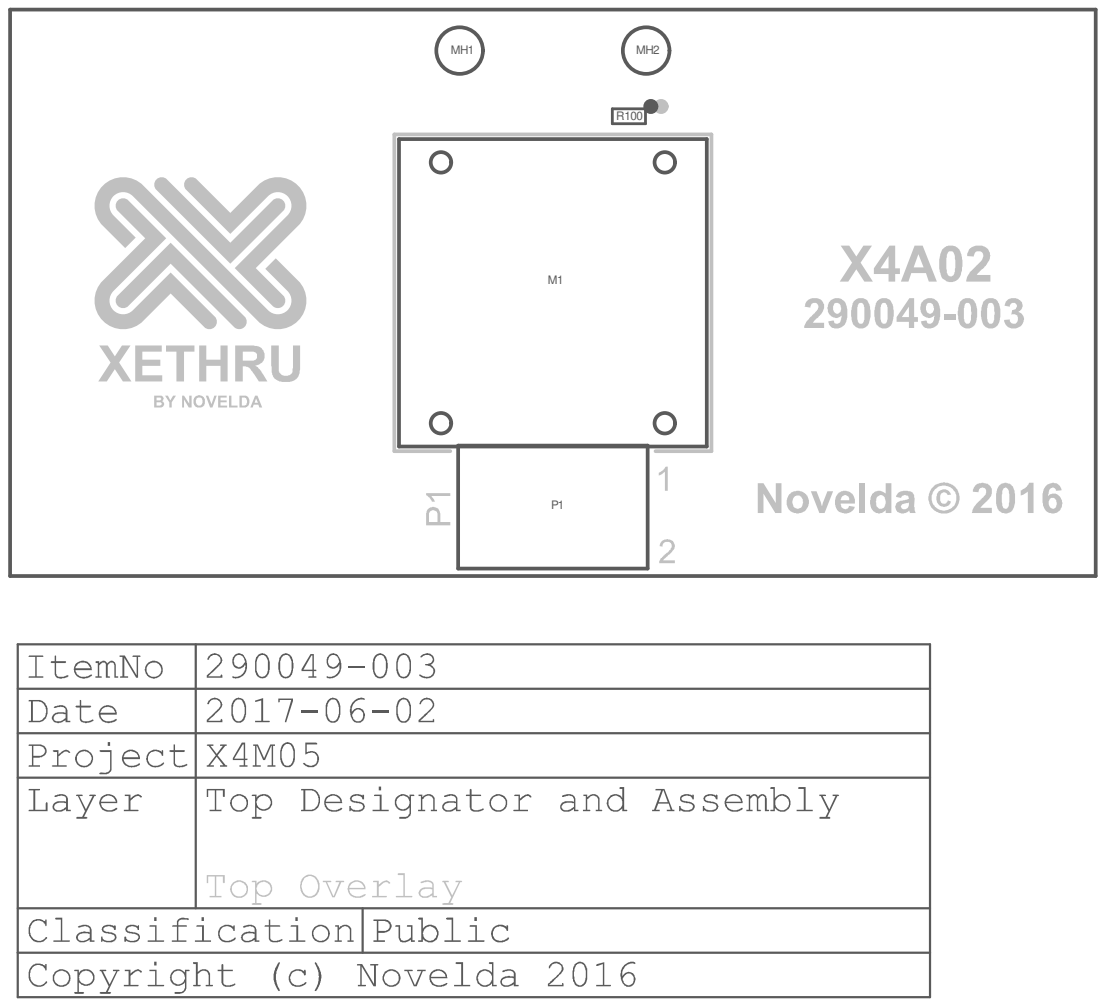
[picture p36: page 8]

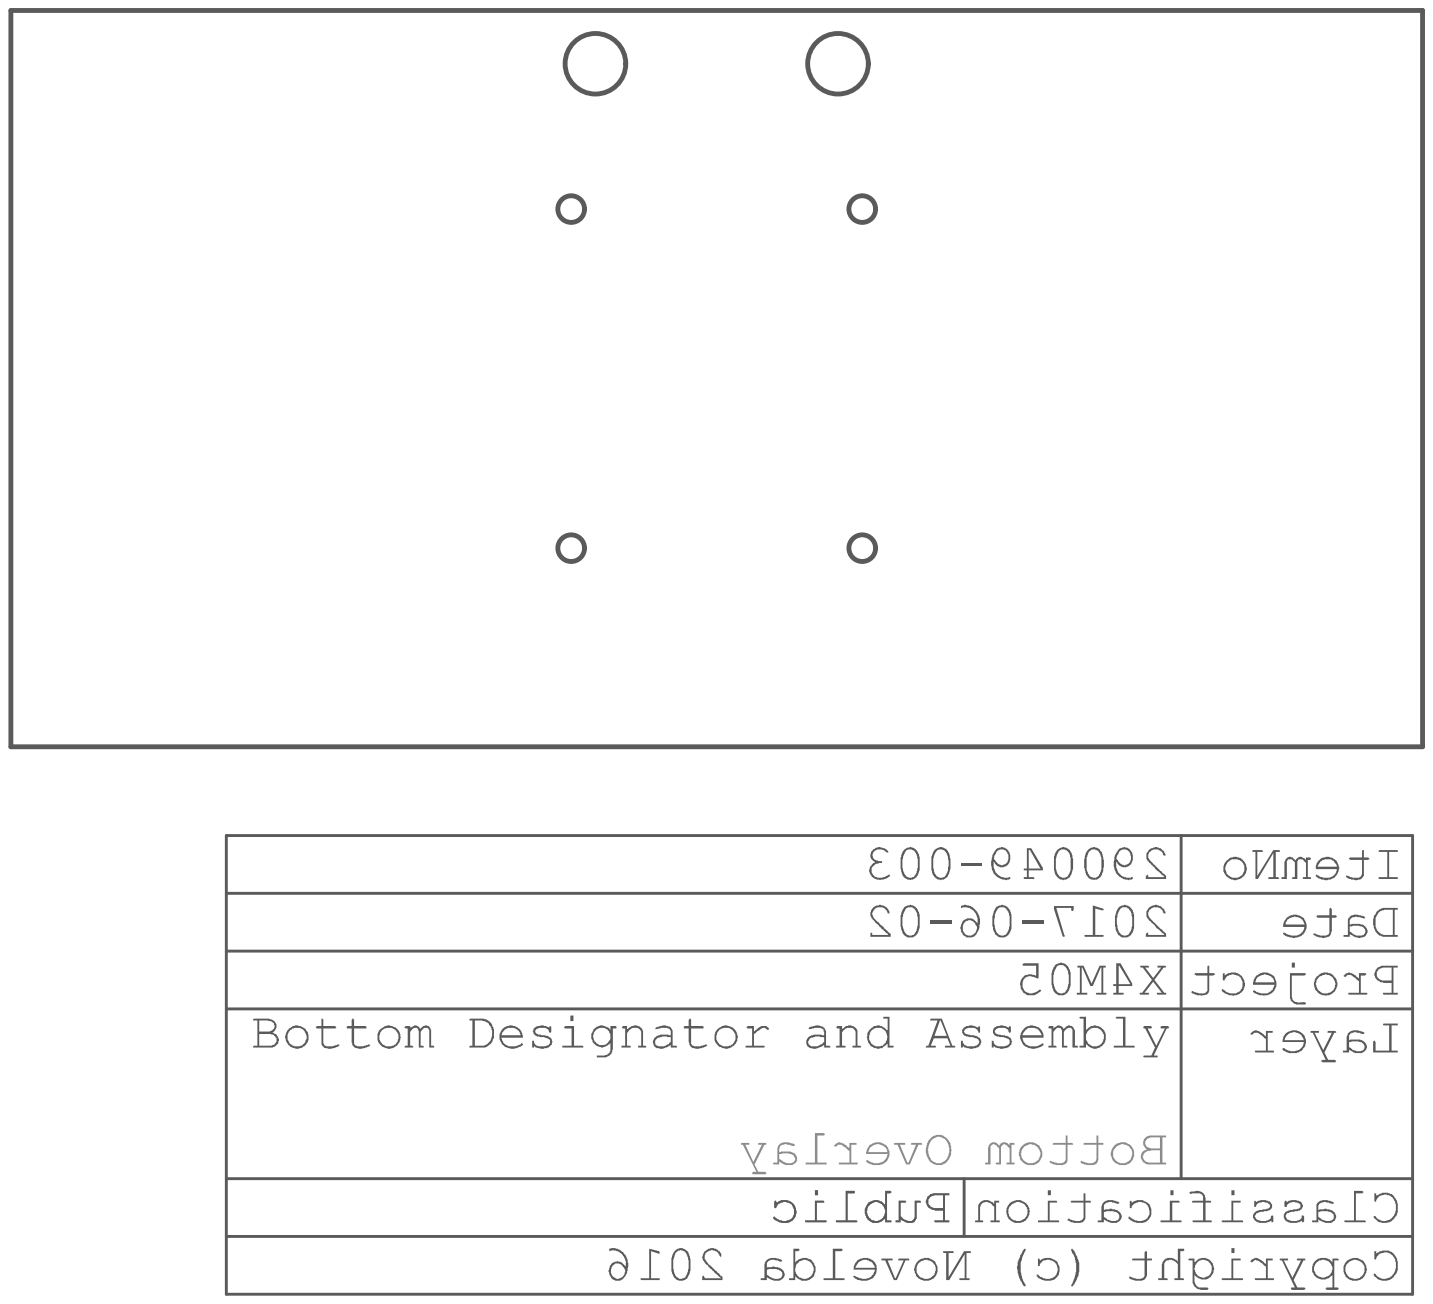
[picture p37: page 9]

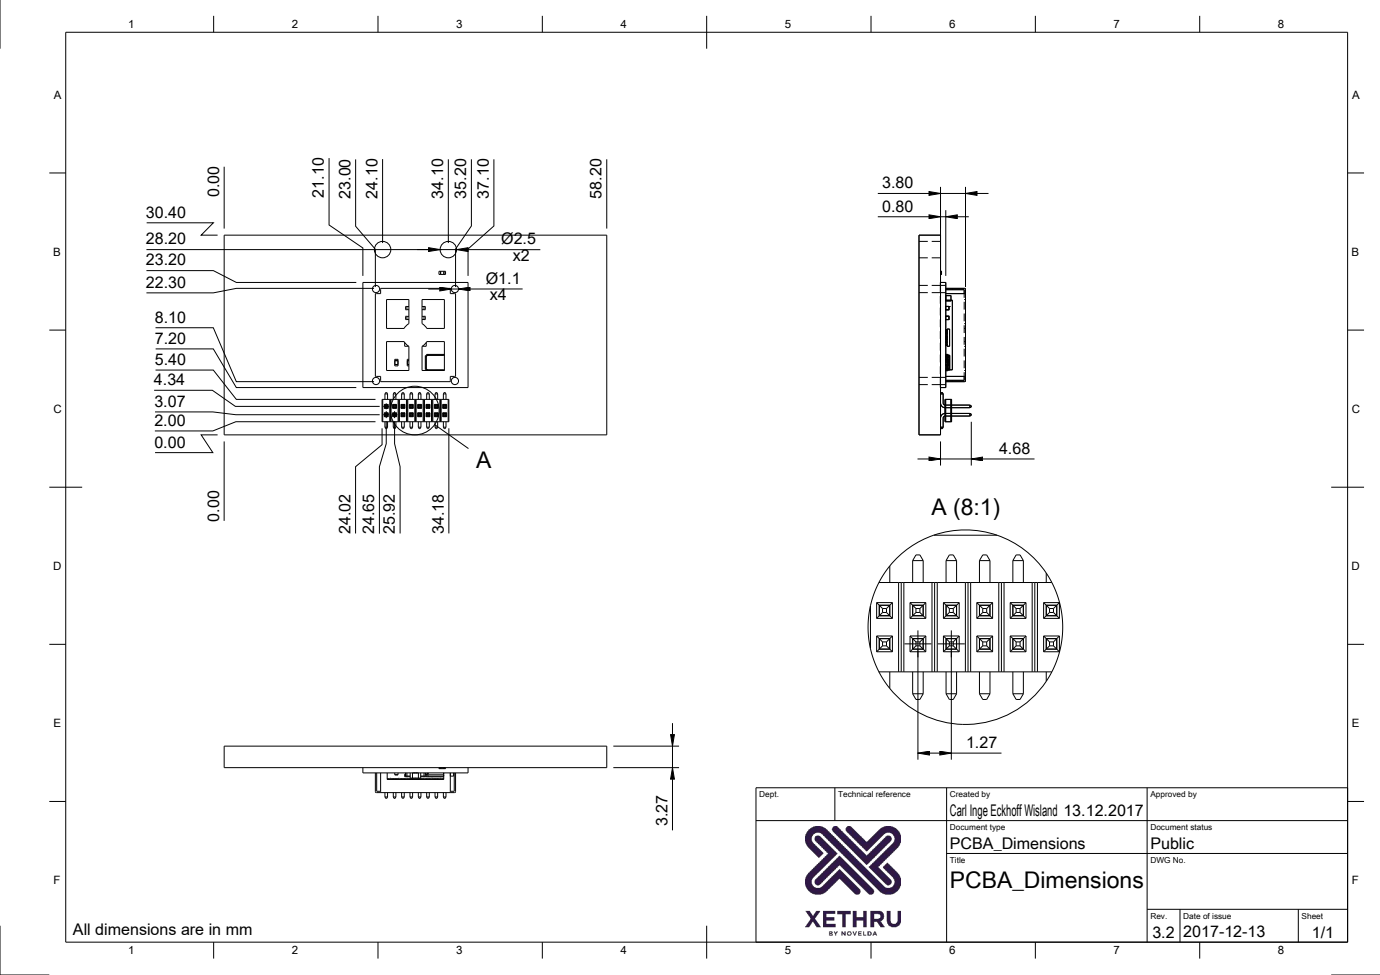
[picture p38: page 10]

Dept. | Technical reference | Created by Carl Inge Eckhoff Wisland 13.12.2017 | Approved by

Document type PCBA_Dimensions | Document status Public

Title PCBA_Dimensions | DWG No.

Rev. 3.2 2017-12-13 | Date of issue | Sheet 1/1

All dimensions are in mm

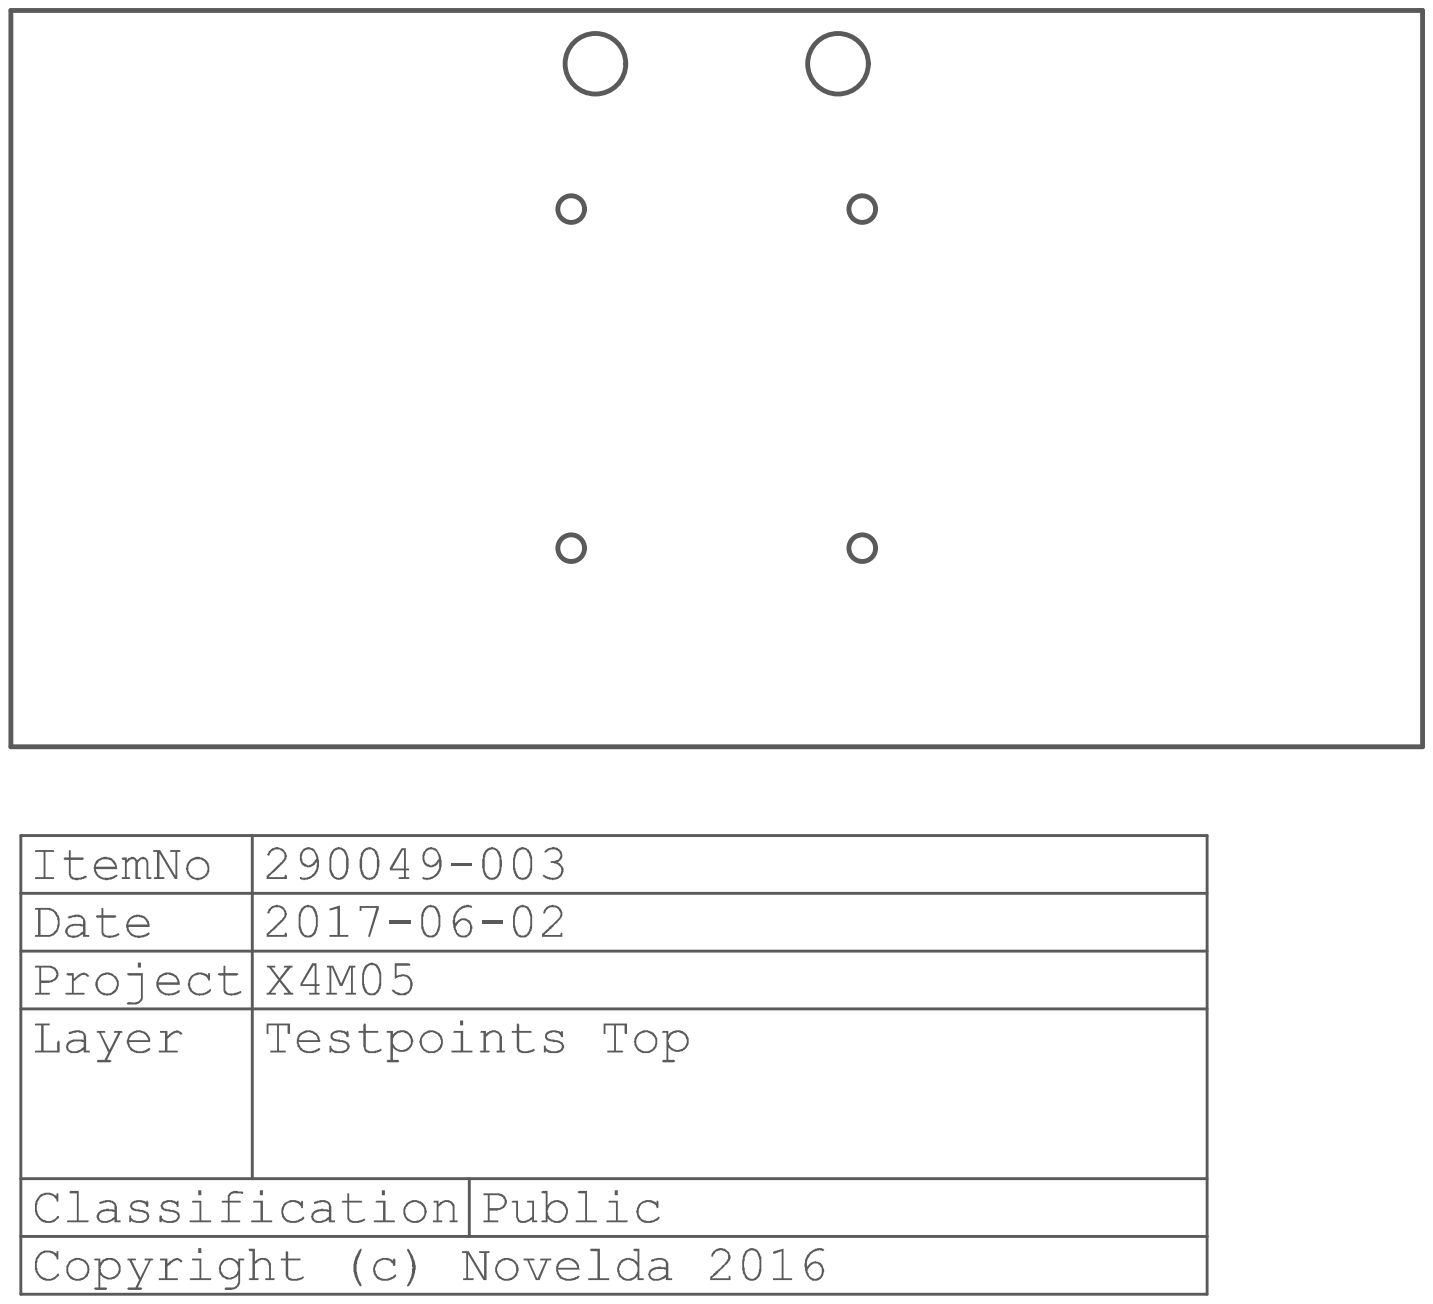
[picture p39: page 11]

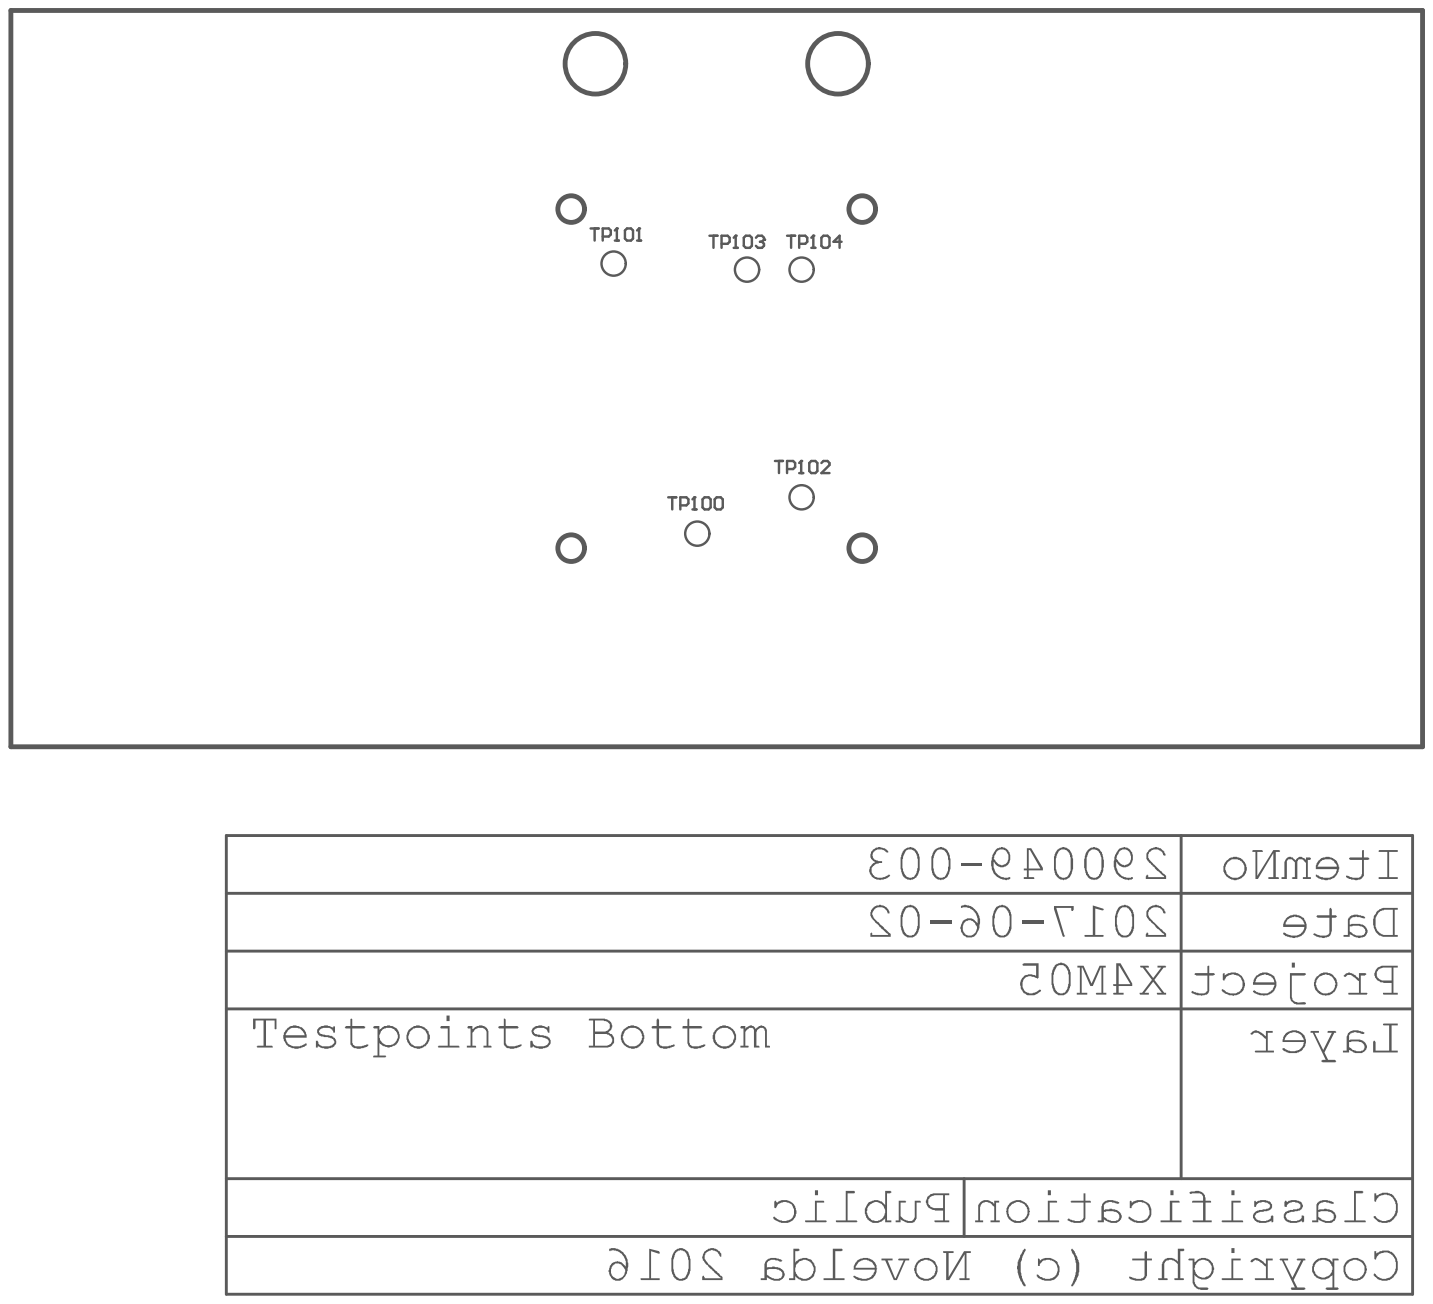
[picture p40: page 12]
