novelda/Legacy-HW/X4M07-Rev2_Design_Documentation_Public/PCBA_Doc_280042-002/PCBA_Doc-280042-002.PDF

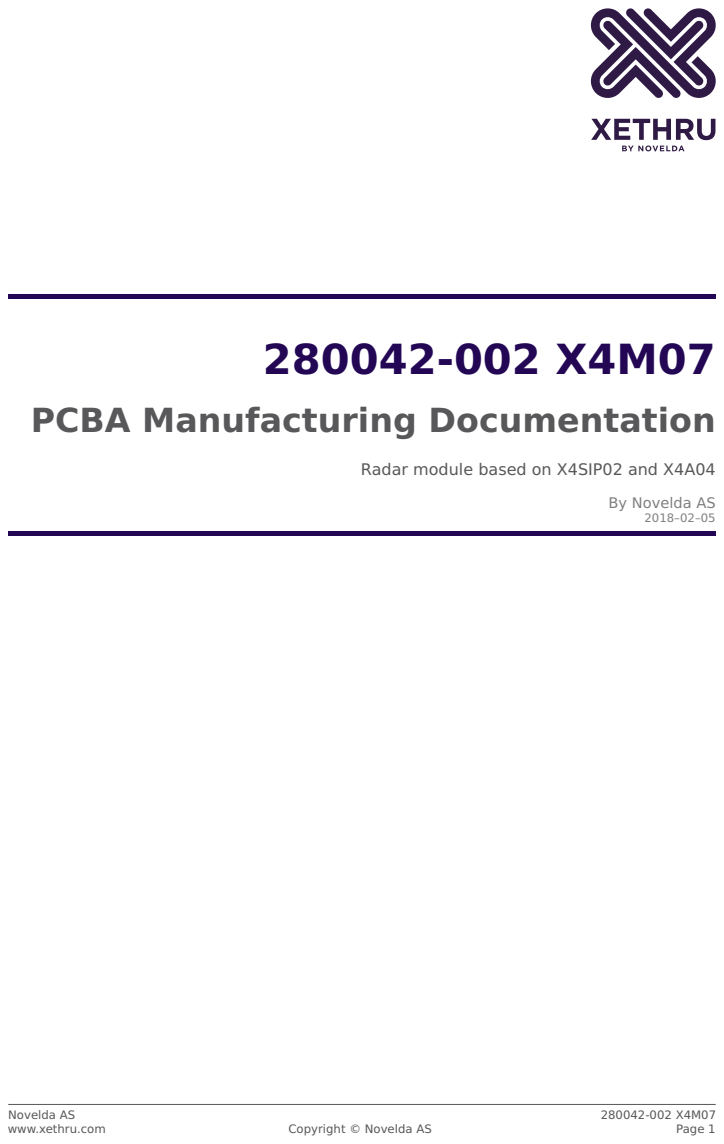
[picture p41: page 1]

Radar module based on X4SIP02 and X4A04

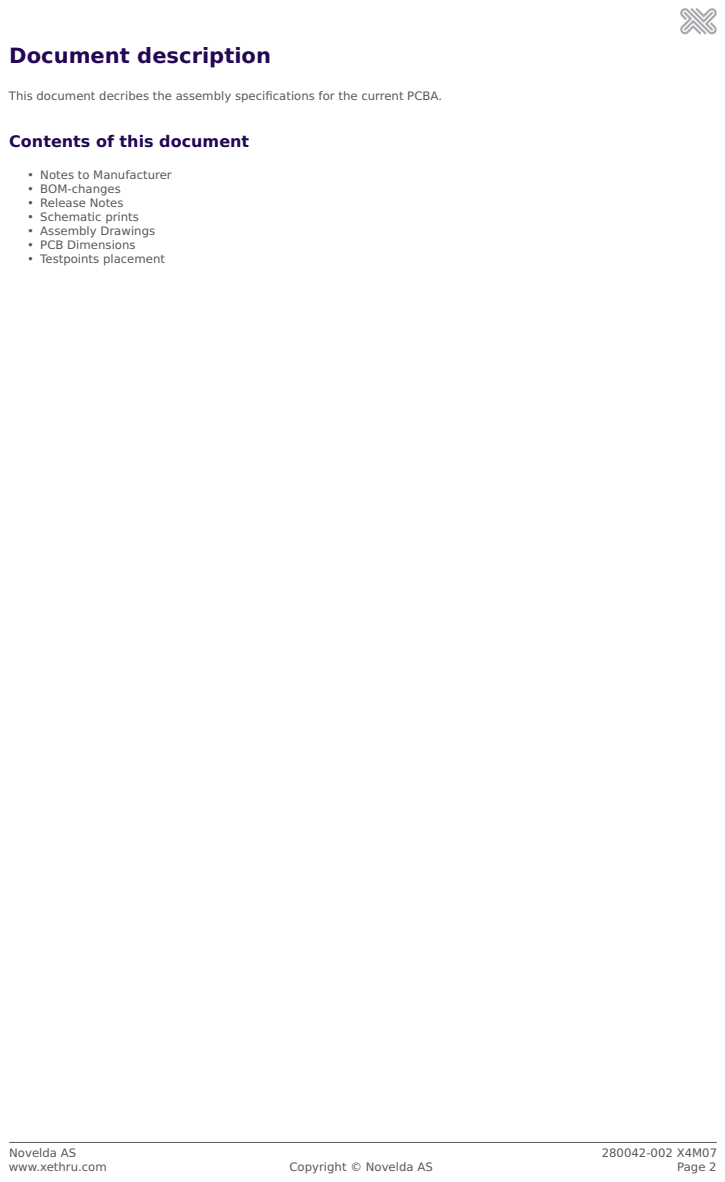
[picture p42: page 2]

This document decribes the assembly specifications for the current PCBA.

Contents of this document

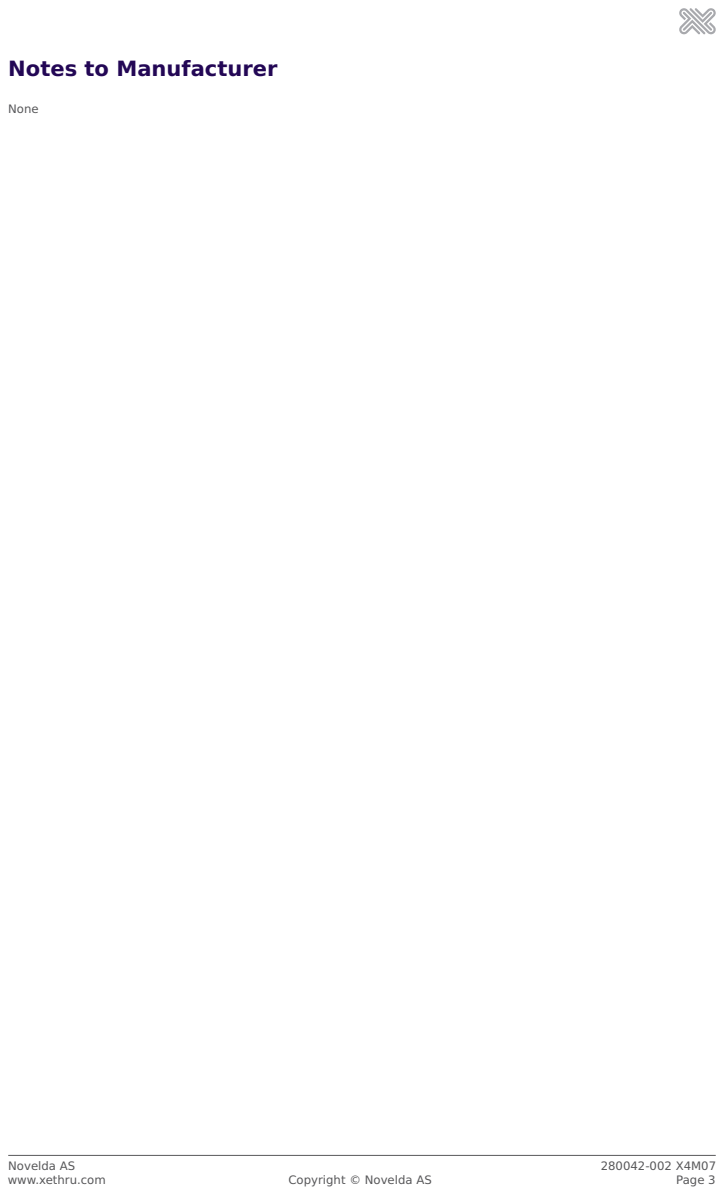
[picture p43: page 3]

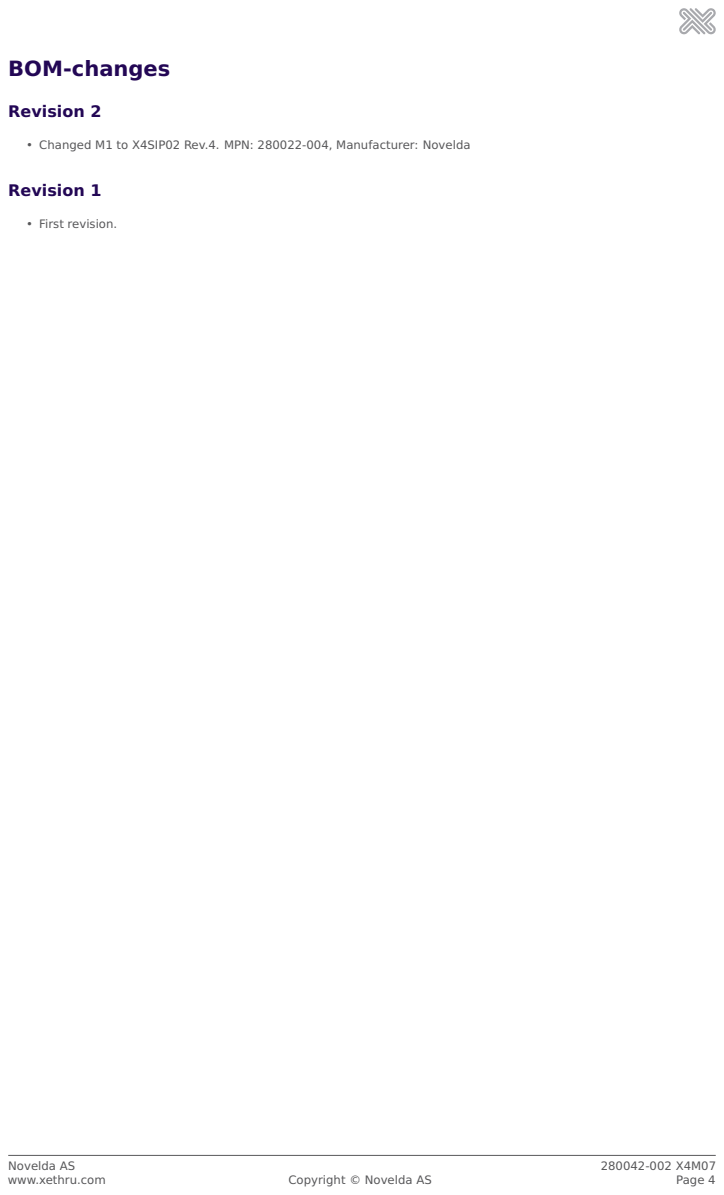
[picture p44: page 4]

• Changed M1 to X4SIP02 Rev.4. MPN: 280022-004, Manufacturer: Novelda

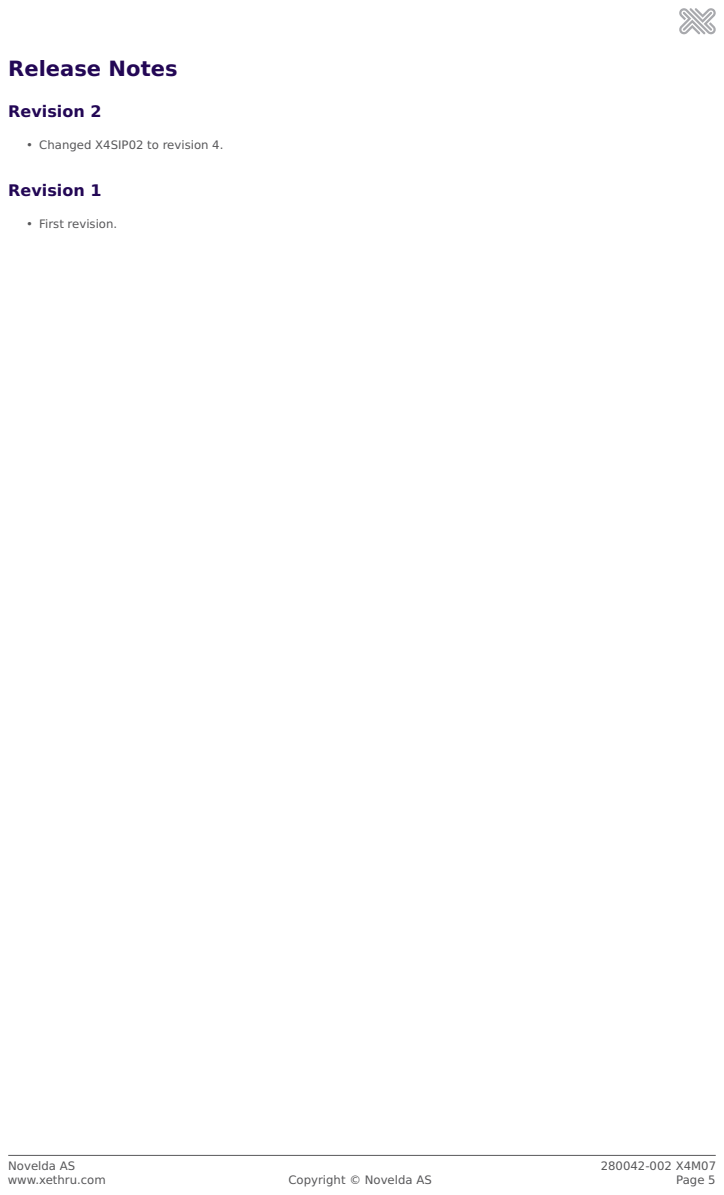
[picture p45: page 5]

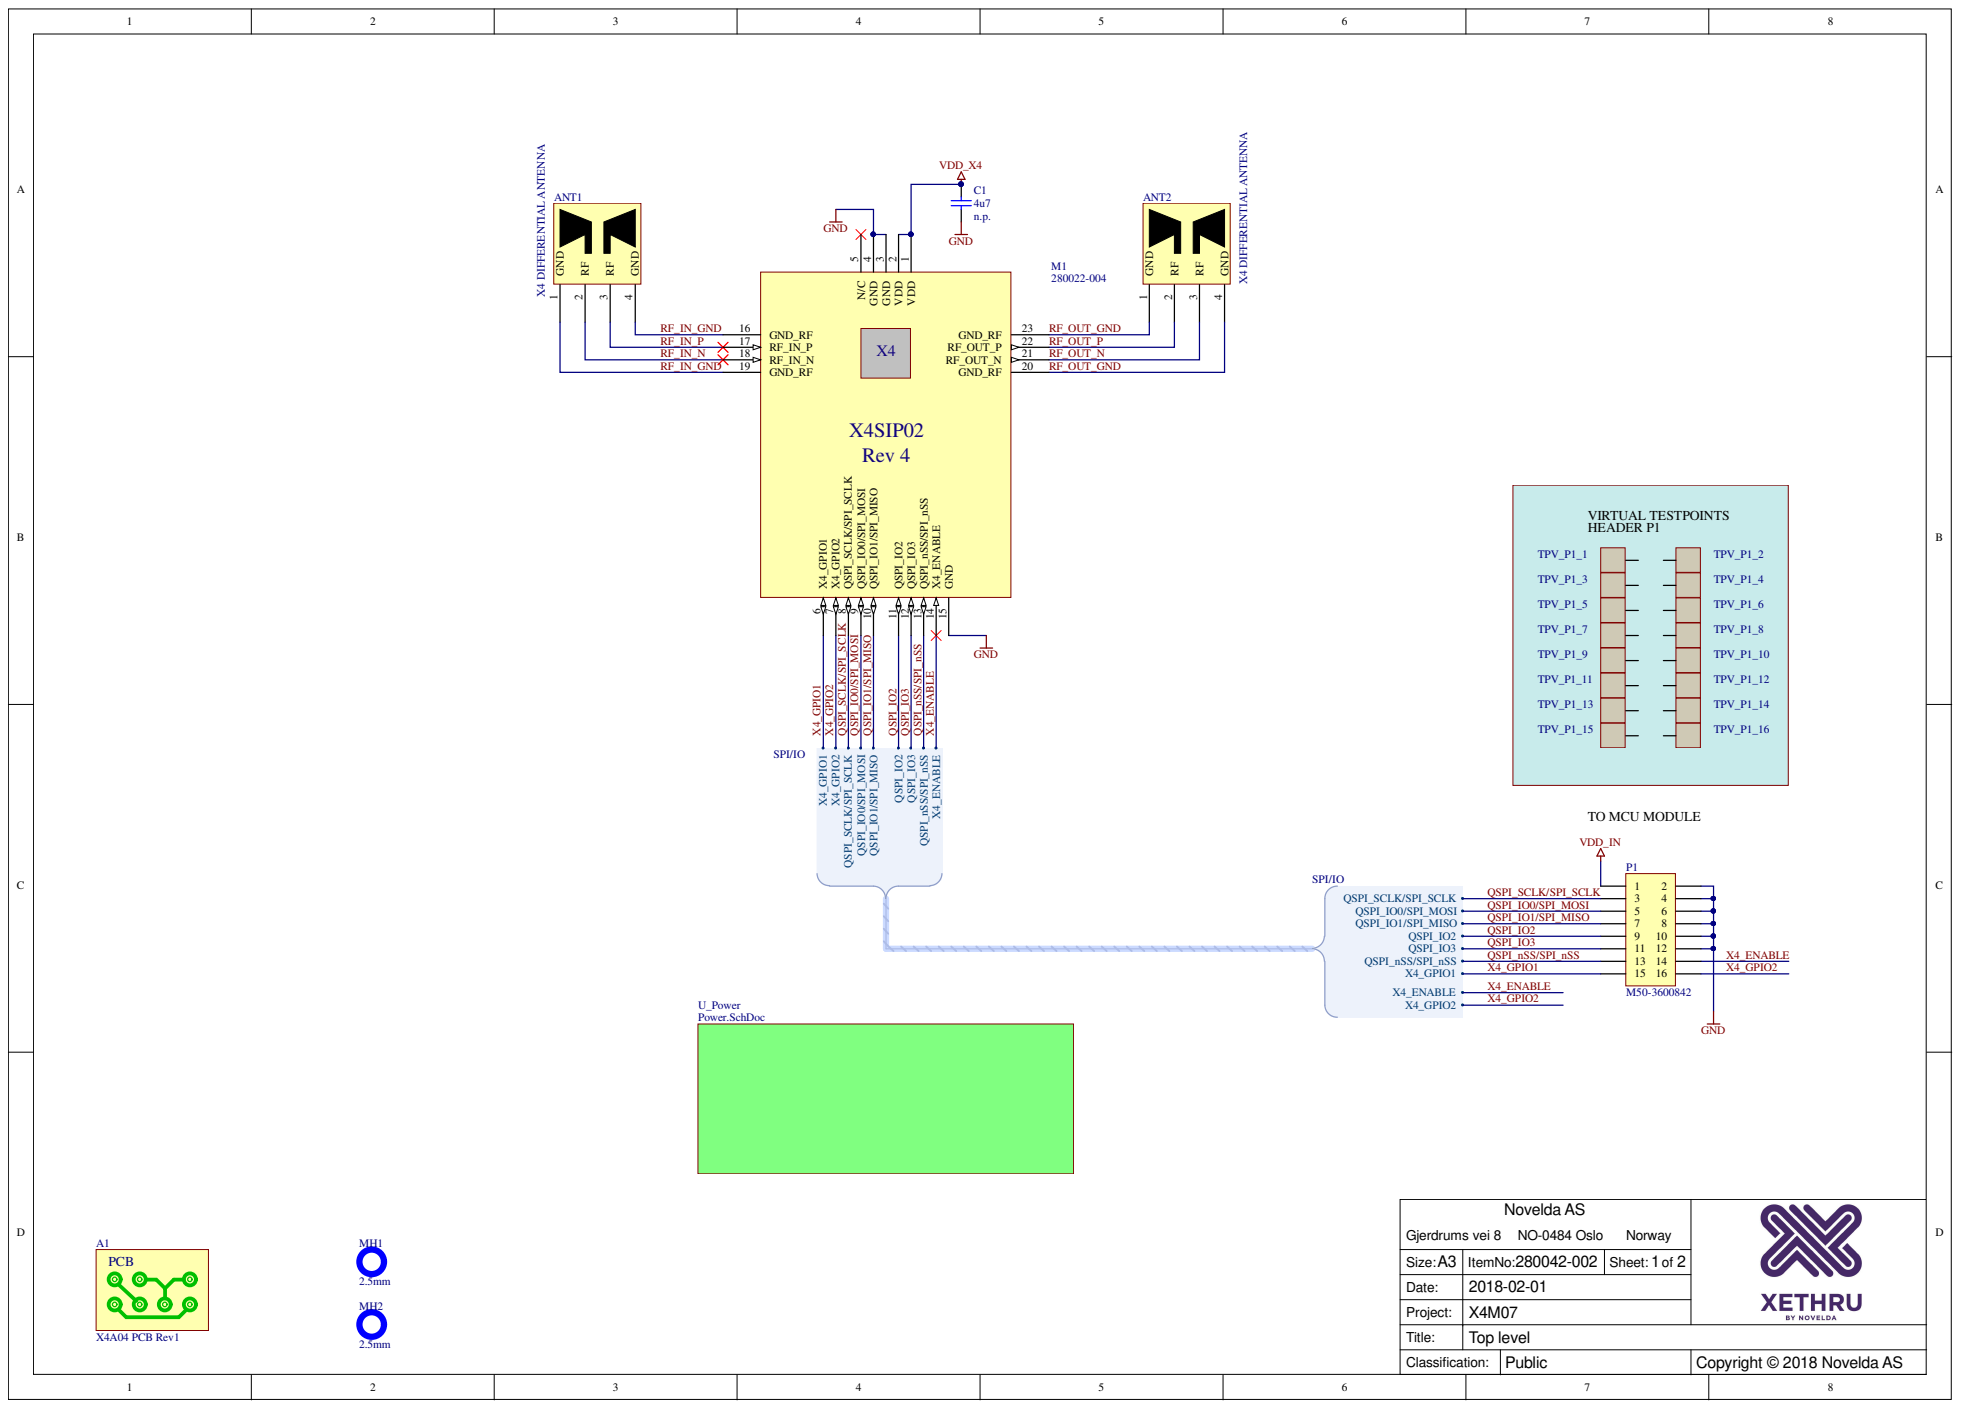
[picture p46: page 6]

Date: | 2018-02-01

Project: | X4M07
Title: | Top level
Classification: | Public | Copyright © 2018 Novelda AS


Remove R100 and populate R101
and R105 to use regulator

n.p.
C101 1u

Novelda AS Gjerdrums vei 8 NO-0484 Oslo Norway

Size:A3 | ItemNo:280042-002 | Sheet: 2of 2
Date: | 2018-02-01

Project: | X4M07

Title: | Power
Classification: | Public | Copyright © 2018 Novelda AS

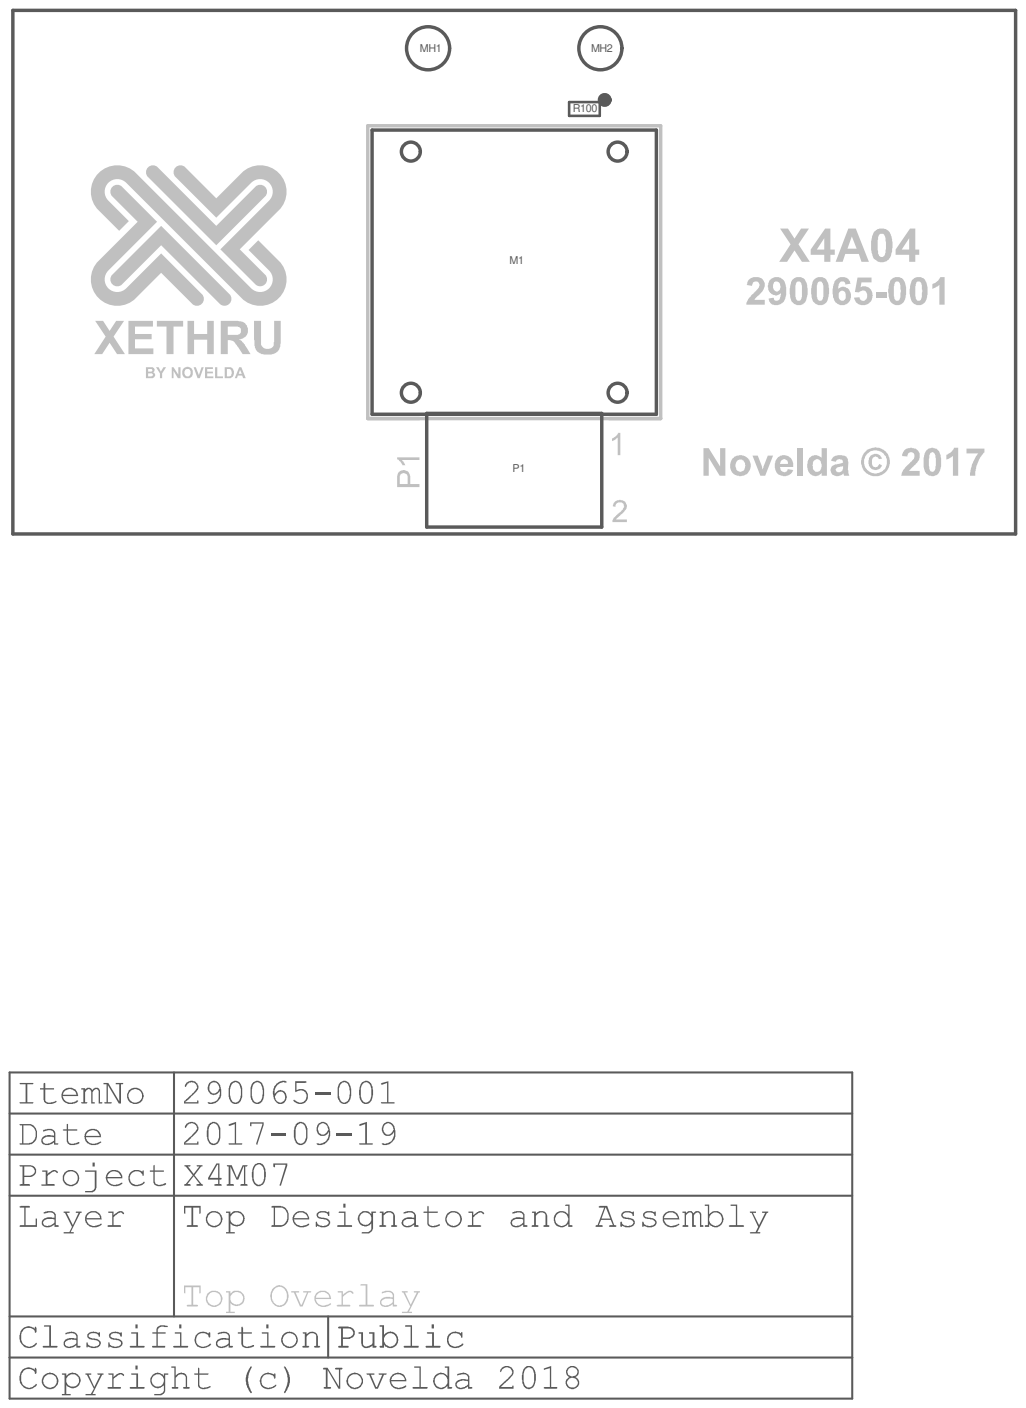
[picture p47: page 8]

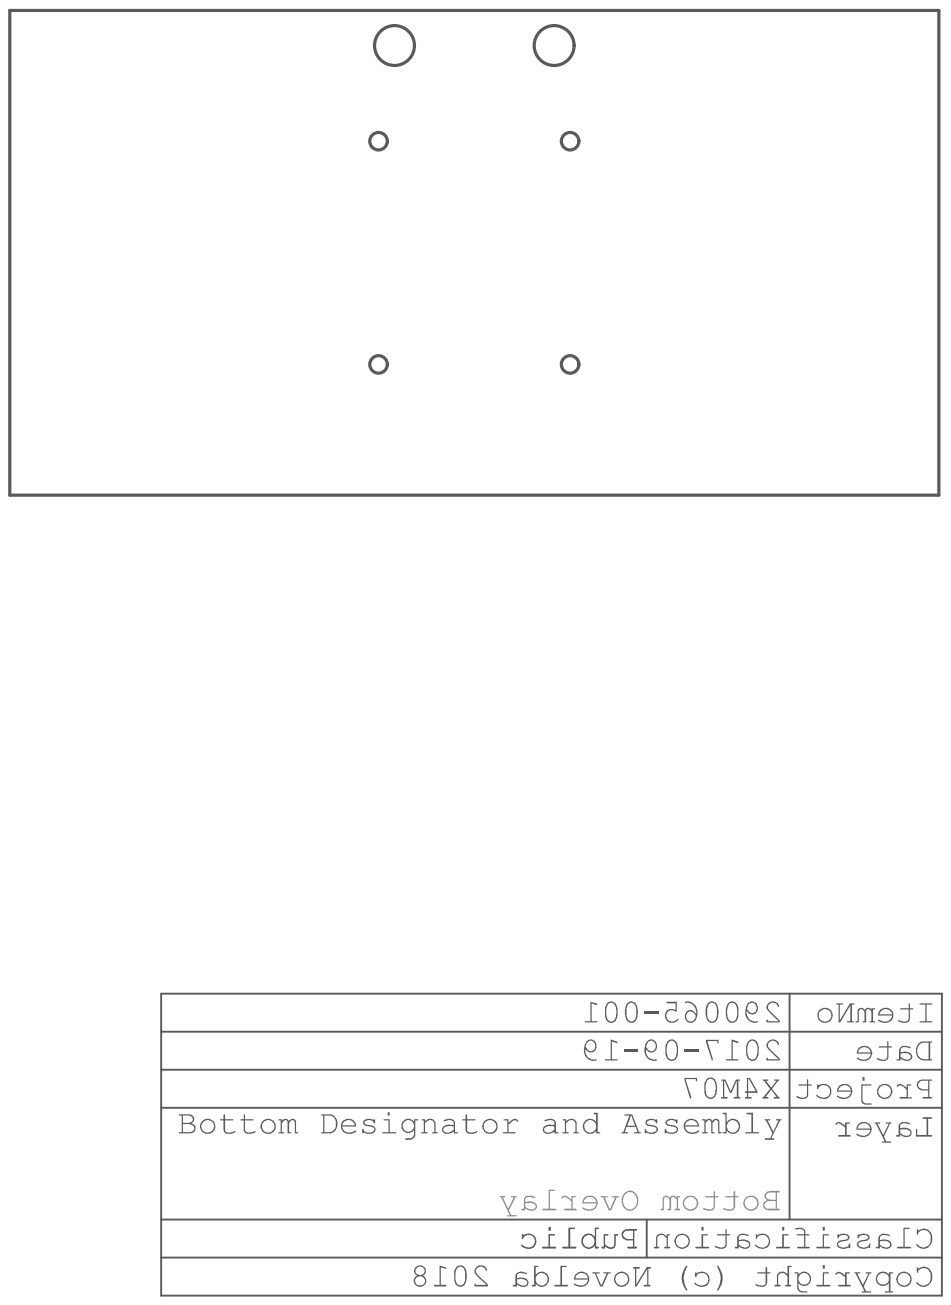
[picture p48: page 9]

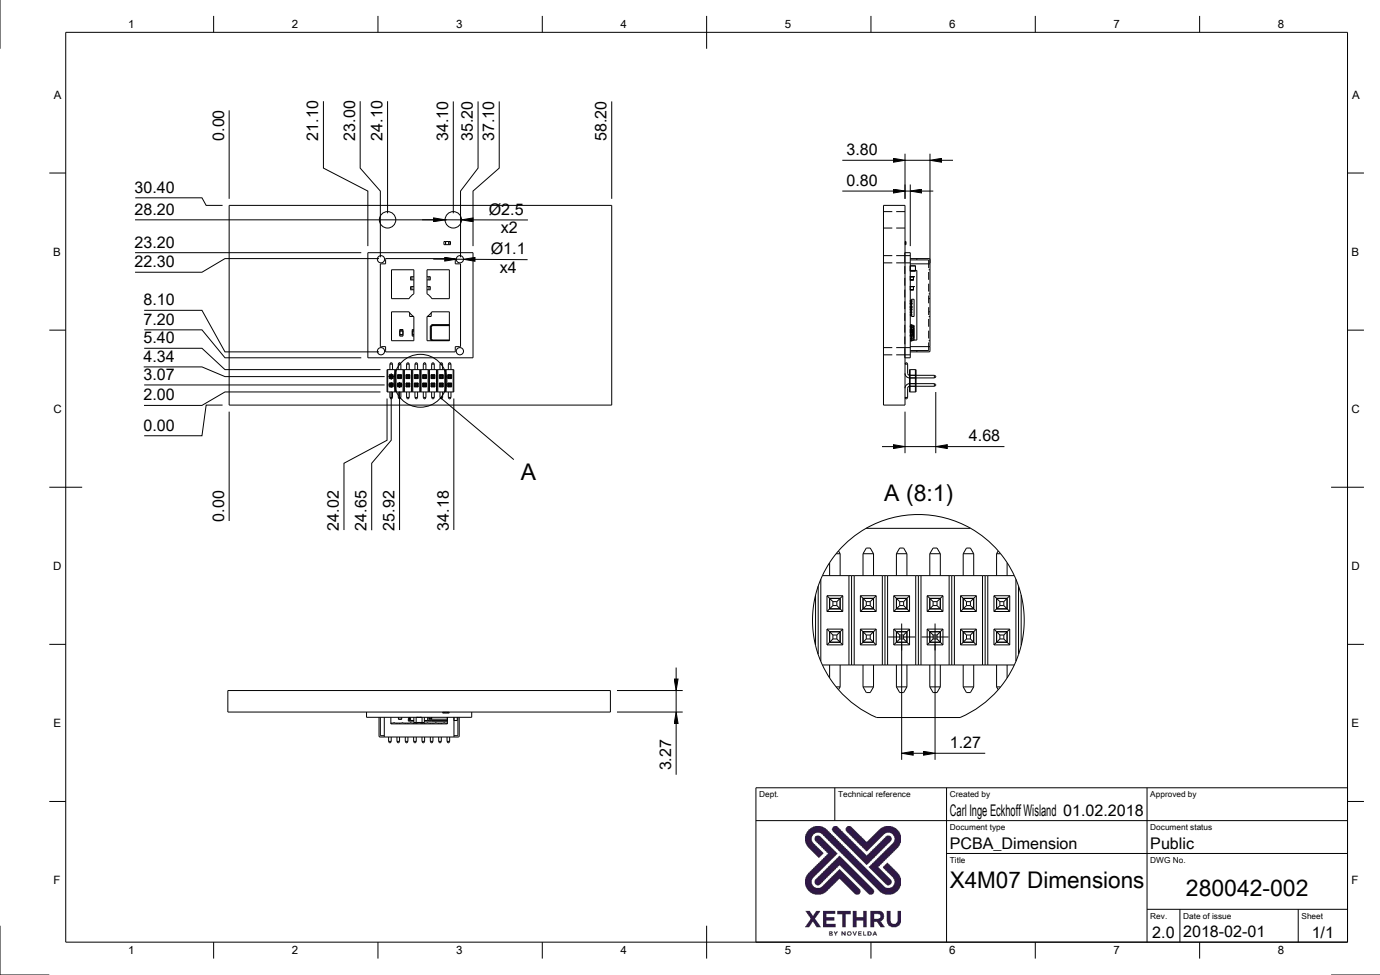
[picture p49: page 10]

Dept. | Technical reference | Created by Carl Inge Eckhoff Wisland 01.02.2018 | Approved by

Document type PCBA_Dimension | Document status Public

Title | DWG No. 280042-002 X4M07 Dimensions

Rev. 2.0 2018-02-01 | Date of issue | Sheet 1/1

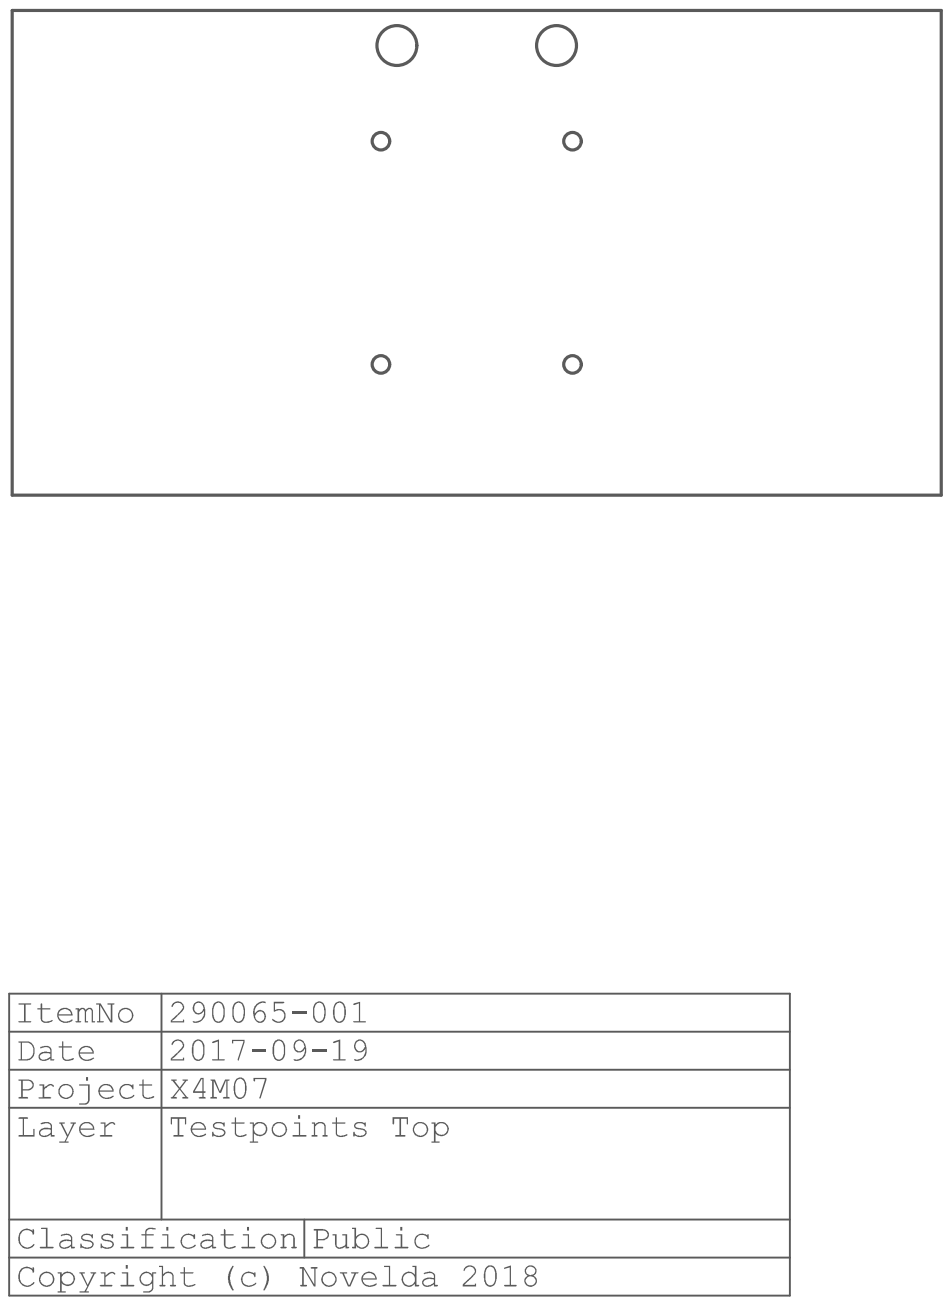
[picture p50: page 11]

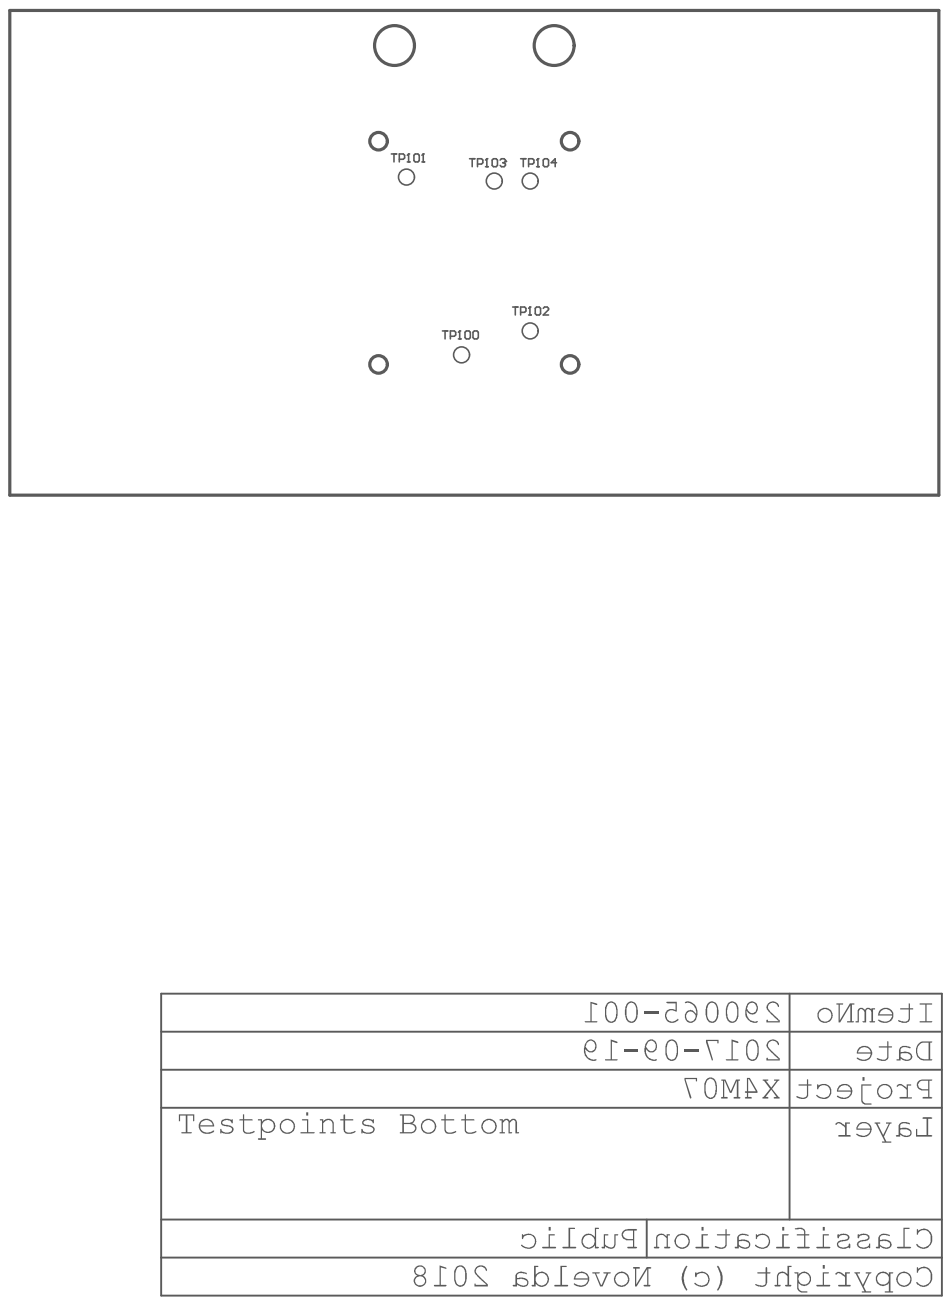
[picture p51: page 12]
