novelda/Legacy-HW/X4SIP02-Rev4_1_Design_Documentation_Public/PCB_Doc_290047-004/PCB_Doc-290047-004.PDF

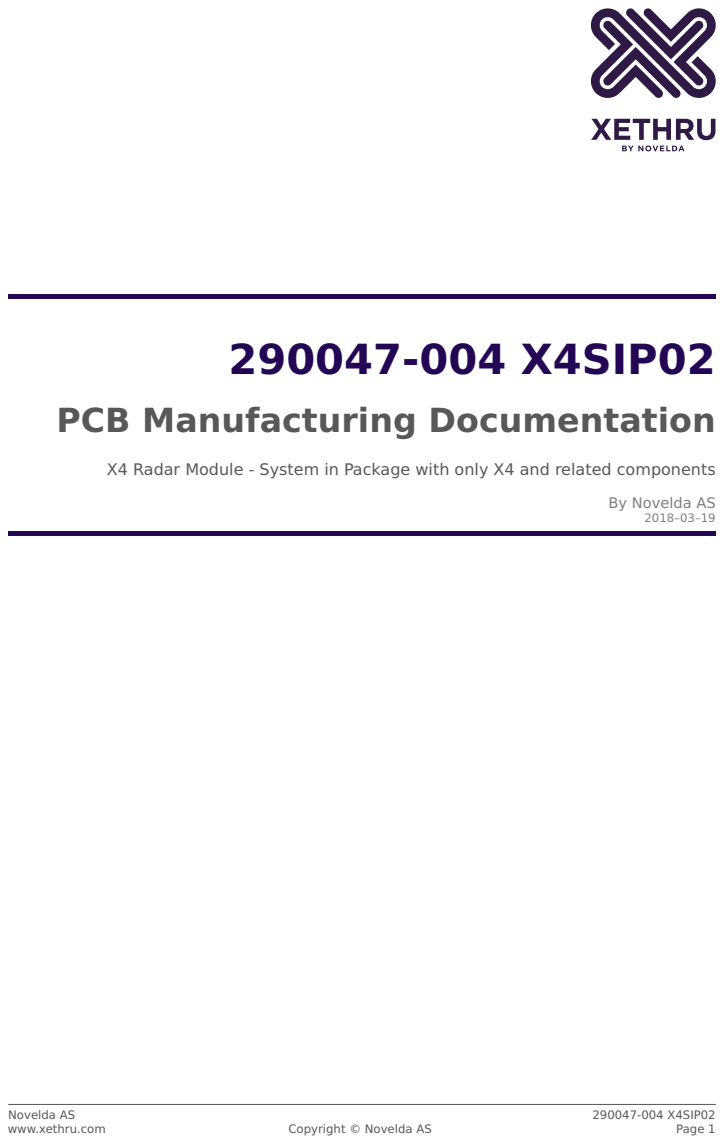
[picture p52: page 1]

X4 Radar Module - System in Package with only X4 and related components

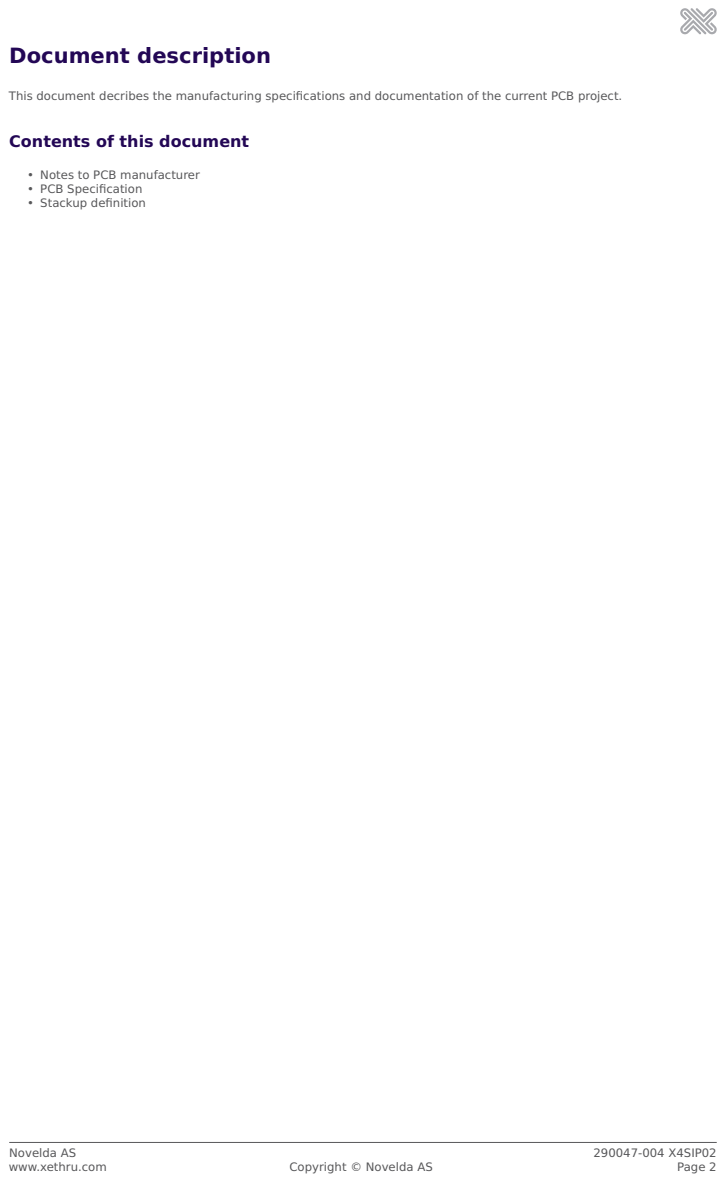
[picture p53: page 2]

This document decribes the manufacturing specifications and documentation of the current PCB project.

Contents of this document

• Notes to PCB manufacturer
• PCB Specification
• Stackup definition

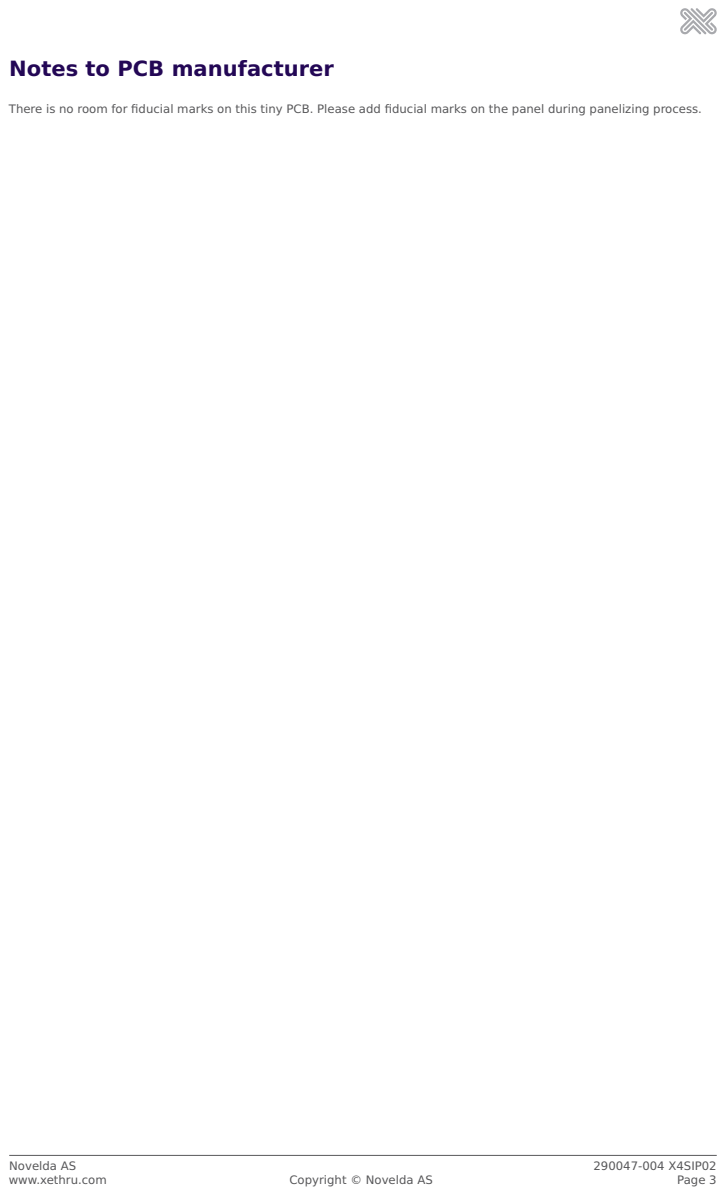
[picture p54: page 3]

Notes to PCB manufacturer

There is no room for fiducial marks on this tiny PCB. Please add fiducial marks on the panel during panelizing process.

# PCB Specification

Category | Property | Value | Comments
Mechanical Data | Board width mm | 16
| Board length mm | 16
Material Data | Final Cu thickness external layers um | 40 | min 33.4
| Final Cu thickness internal layers um | 17 | min 11.4
Soldermask | Solder resist top | Yes
| Solder resist bottom | Yes
| Solder resist color | Blue
Prints / masks | Silkscreen top | Yes
| Silkscreen bottom | No
| Silkscreen color | White
| Pb. free label | Yes
Finish | Hot Air Solder Level (HASL), Lead-free | No
| Electroless nickel immersion gold
| (ENIG) | Yes
Gerber / Drill format | Unit | mil
| Format | 2:4 (0.1mil)
Clearance | External layers um | 100
| Internal layers um | 100
Tolerances | PCB Dimensions / outline mm | +0.2 / -0.1
Vias | Filled | No
| Capped | No

Page 4

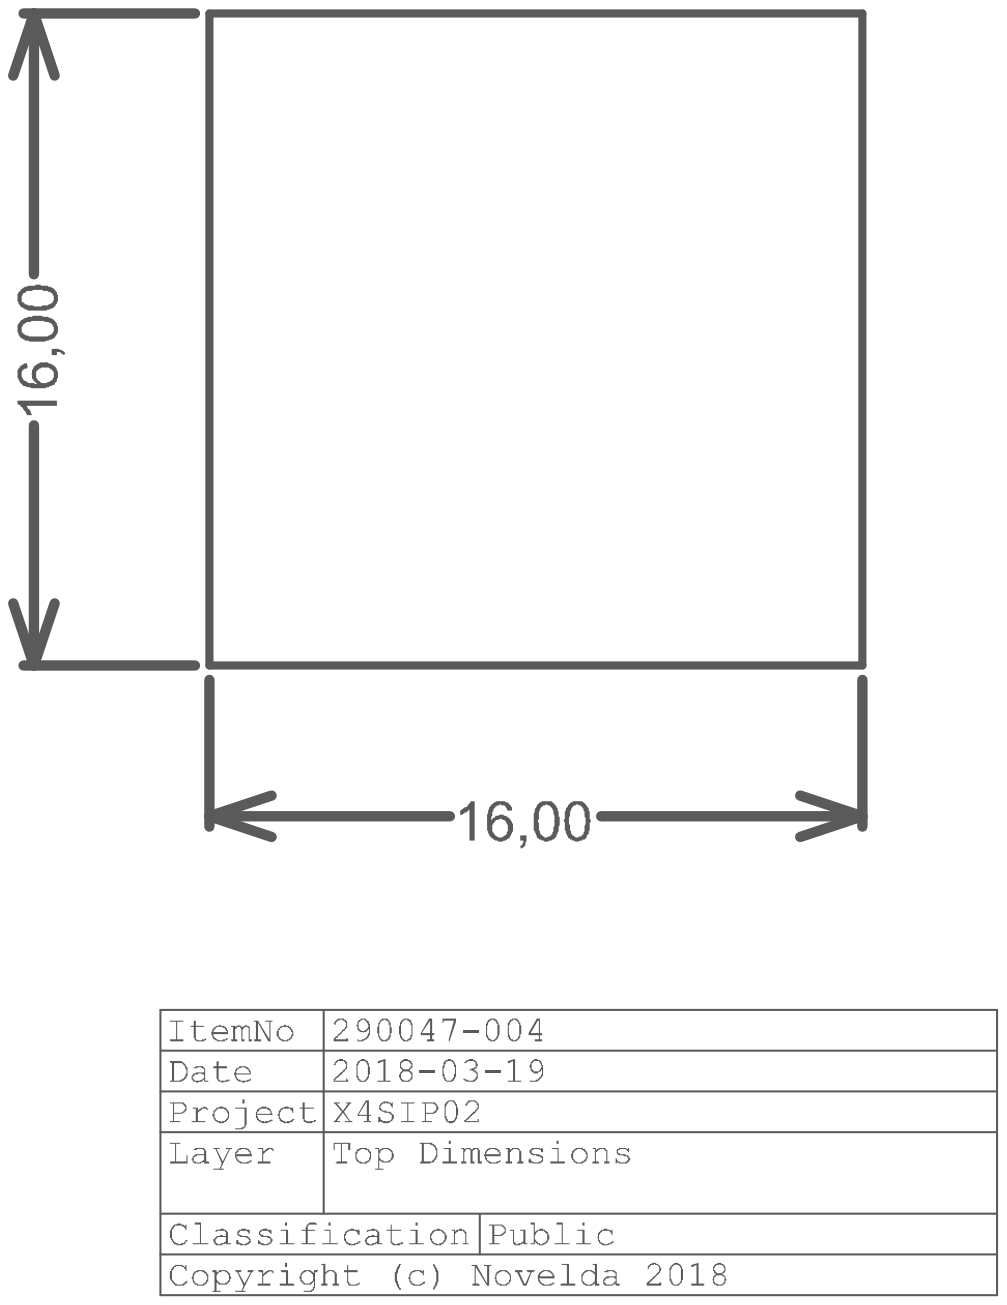
[picture p55: page 5]

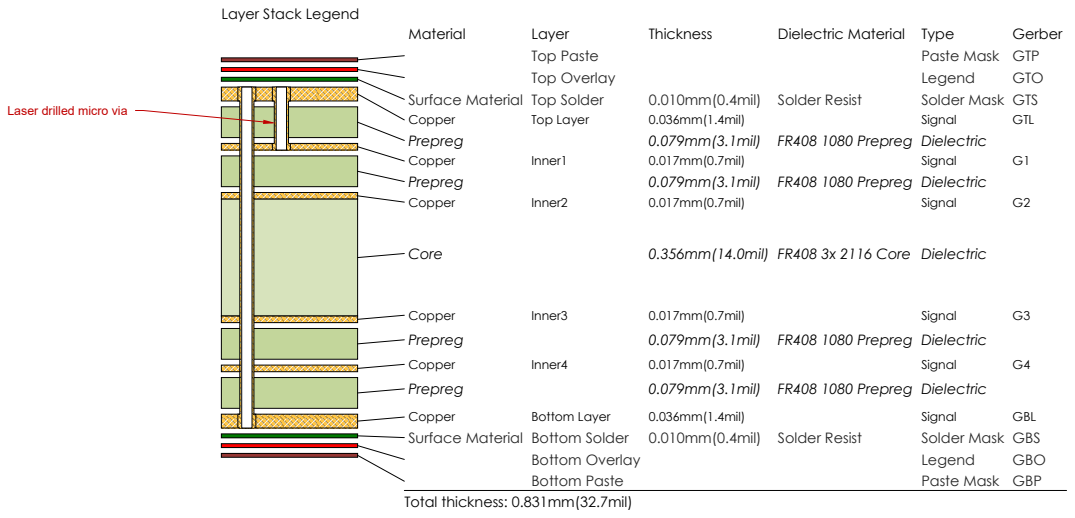
[picture p56: page 6]

Laser drilled micro via

Novelda AS Gjerdrums vei 8, NO-0484 Oslo, Norway

Size: A3 | Scale: 1:1 | Sheet: 1 of 1
ItemNo: | 290047-004
Date: | 2018-03-19
Project: | X4SIP02
Title: | PCB Layer Stack up
Classification: | Public | Copyright © 2018 Novelda AS
