novelda/Legacy-HW/X4SIP02-Rev4_1_Design_Documentation_Public/PCBA_Doc_280022-004/PCBA_Doc-280022-004.PDF

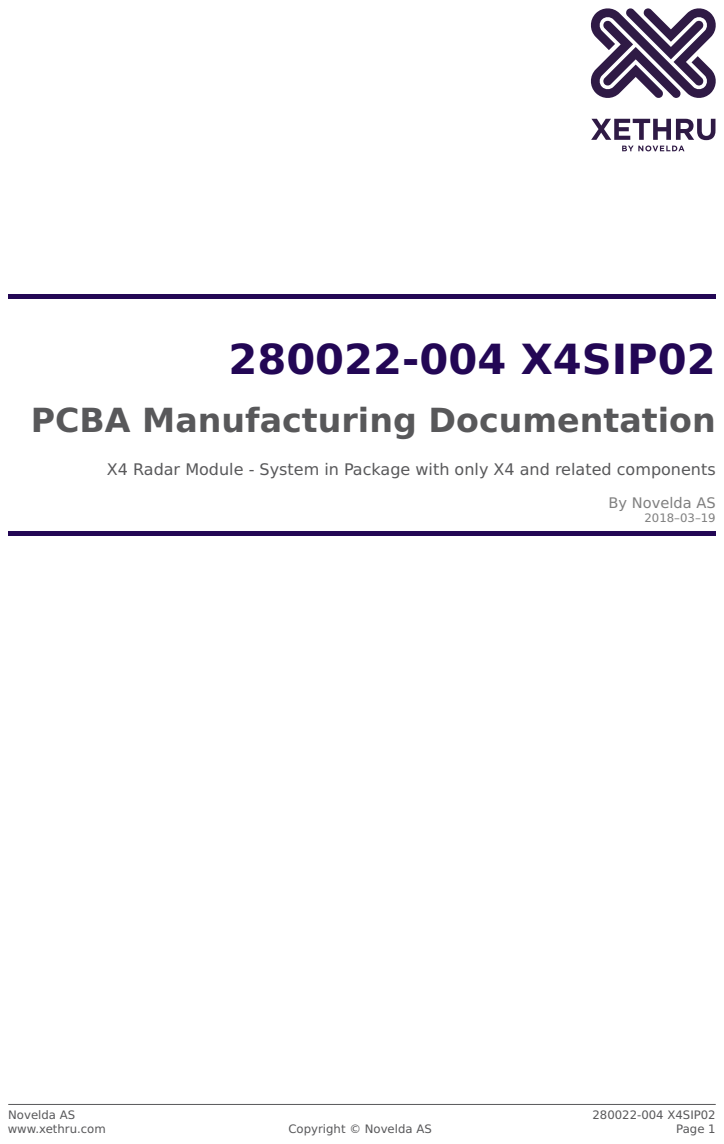
[picture p57: page 1]

X4 Radar Module - System in Package with only X4 and related components

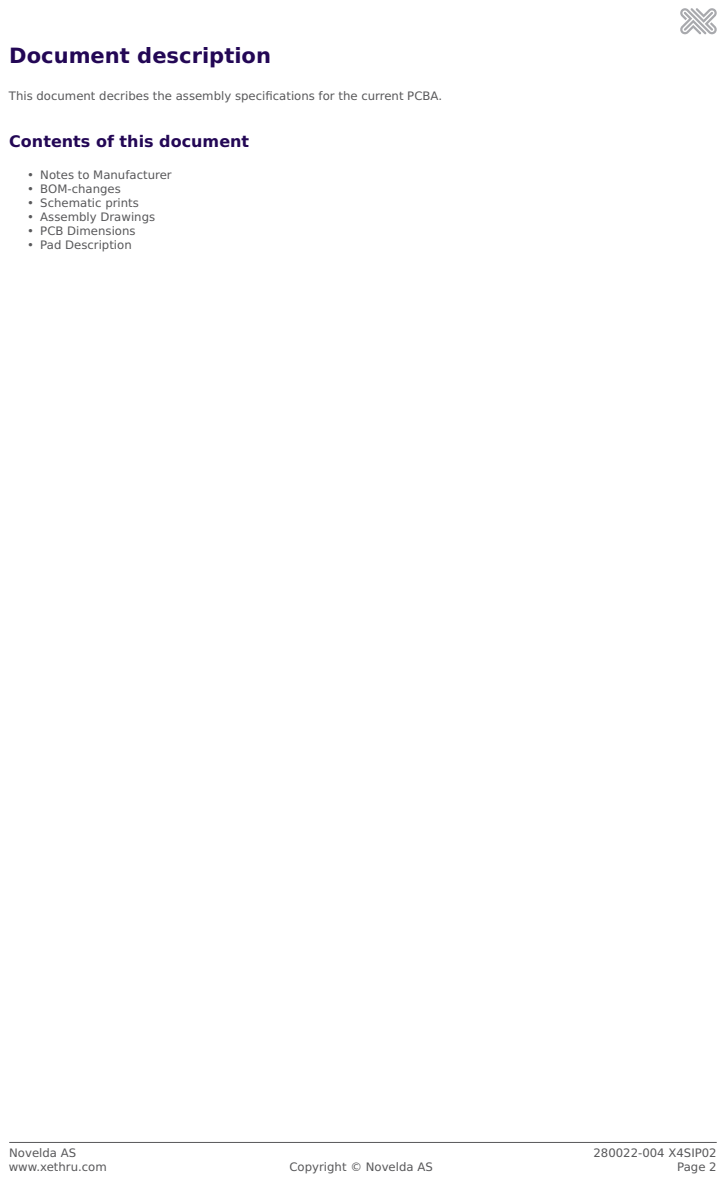
[picture p58: page 2]

This document decribes the assembly specifications for the current PCBA.

Contents of this document

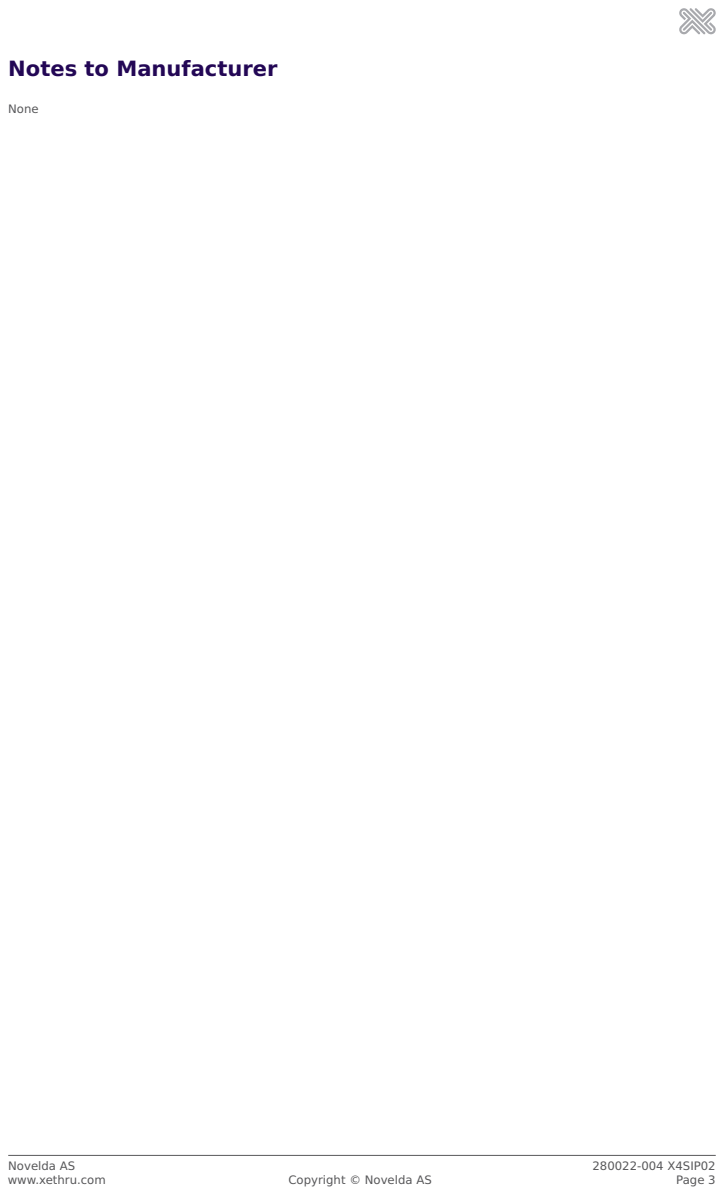
[picture p59: page 3]

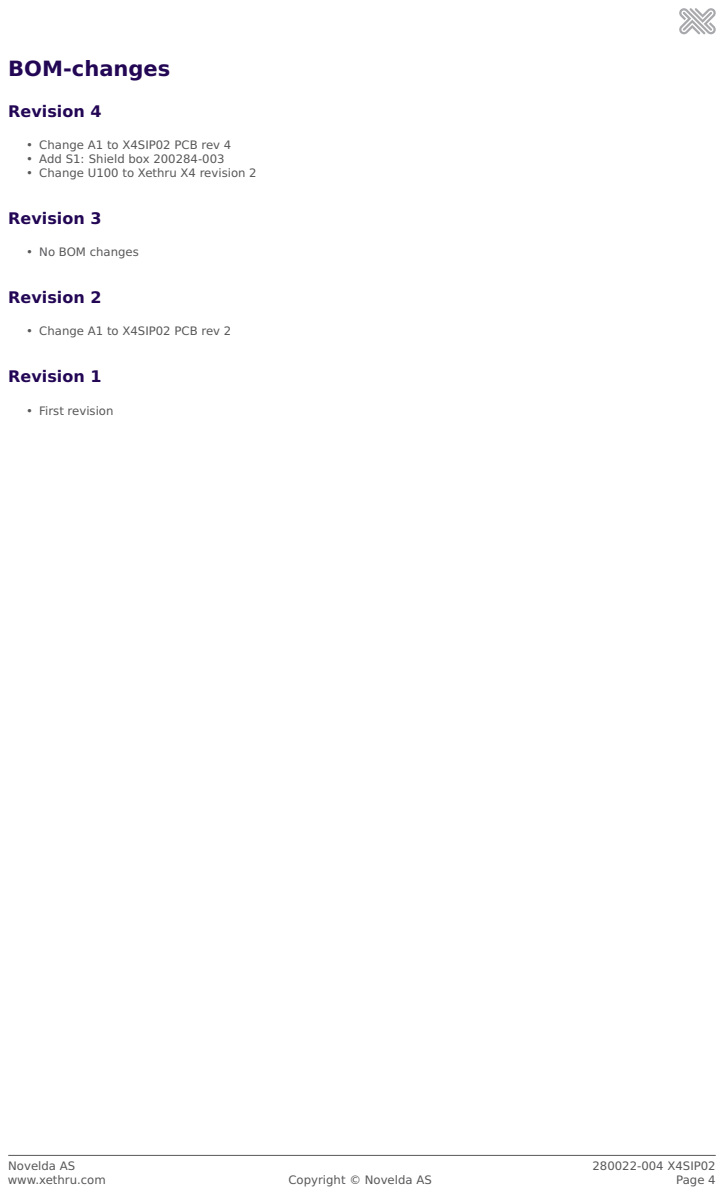
[picture p60: page 4]

• Change A1 to X4SIP02 PCB rev 4
• Add S1: Shield box 200284-003
• Change U100 to Xethru X4 revision 2

• Change A1 to X4SIP02 PCB rev 2

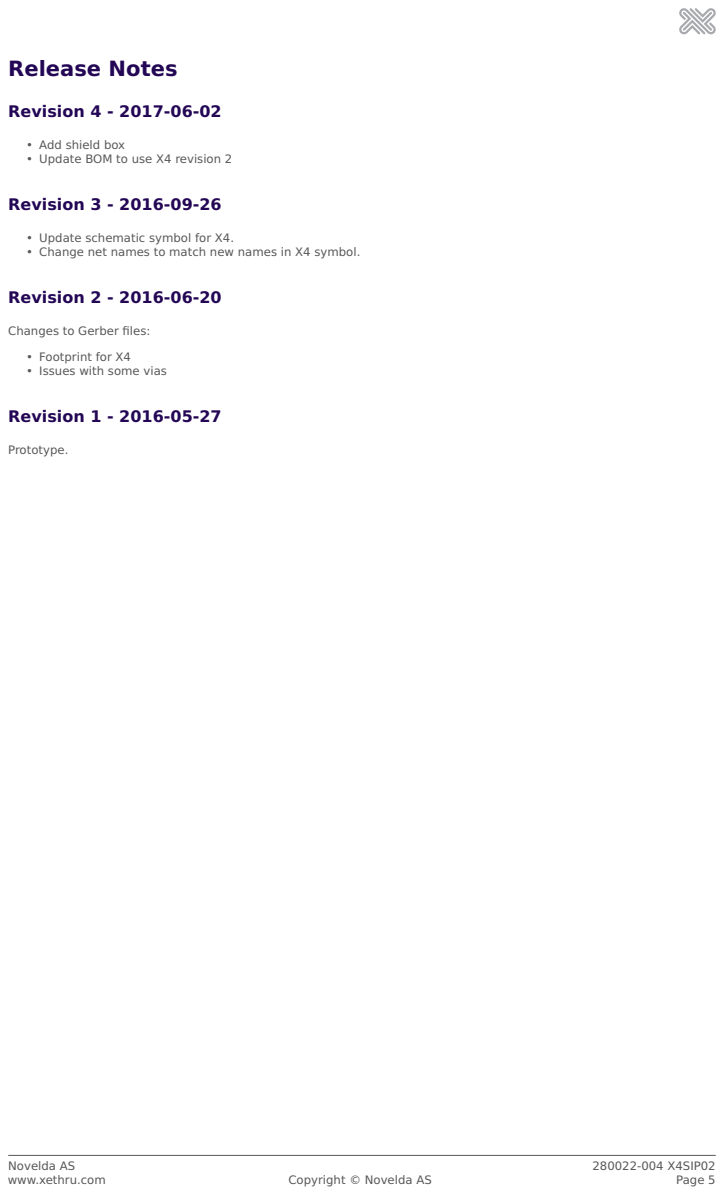
[picture p61: page 5]

• Add shield box
• Update BOM to use X4 revision 2

• Update schematic symbol for X4.
• Change net names to match new names in X4 symbol.

Changes to Gerber files:

• Footprint for X4
• Issues with some vias

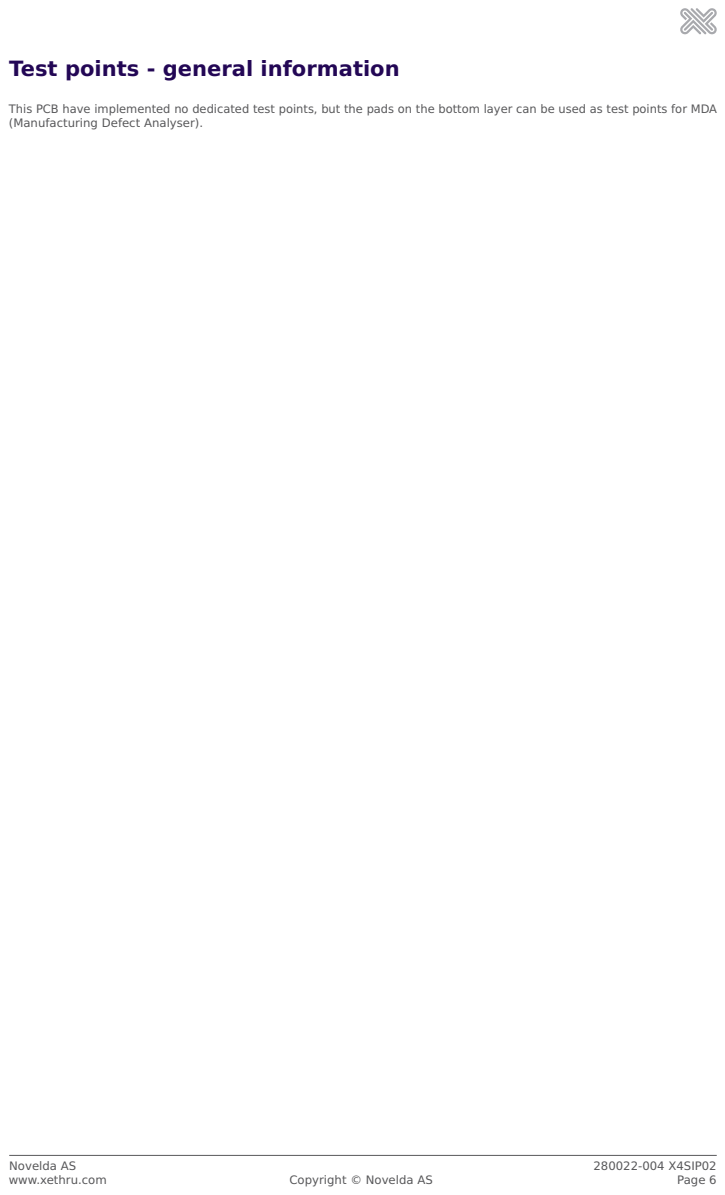
[picture p62: page 6]

Test points - general information

This PCB have implemented no dedicated test points, but the pads on the bottom layer can be used as test points for MDA
(Manufacturing Defect Analyser).

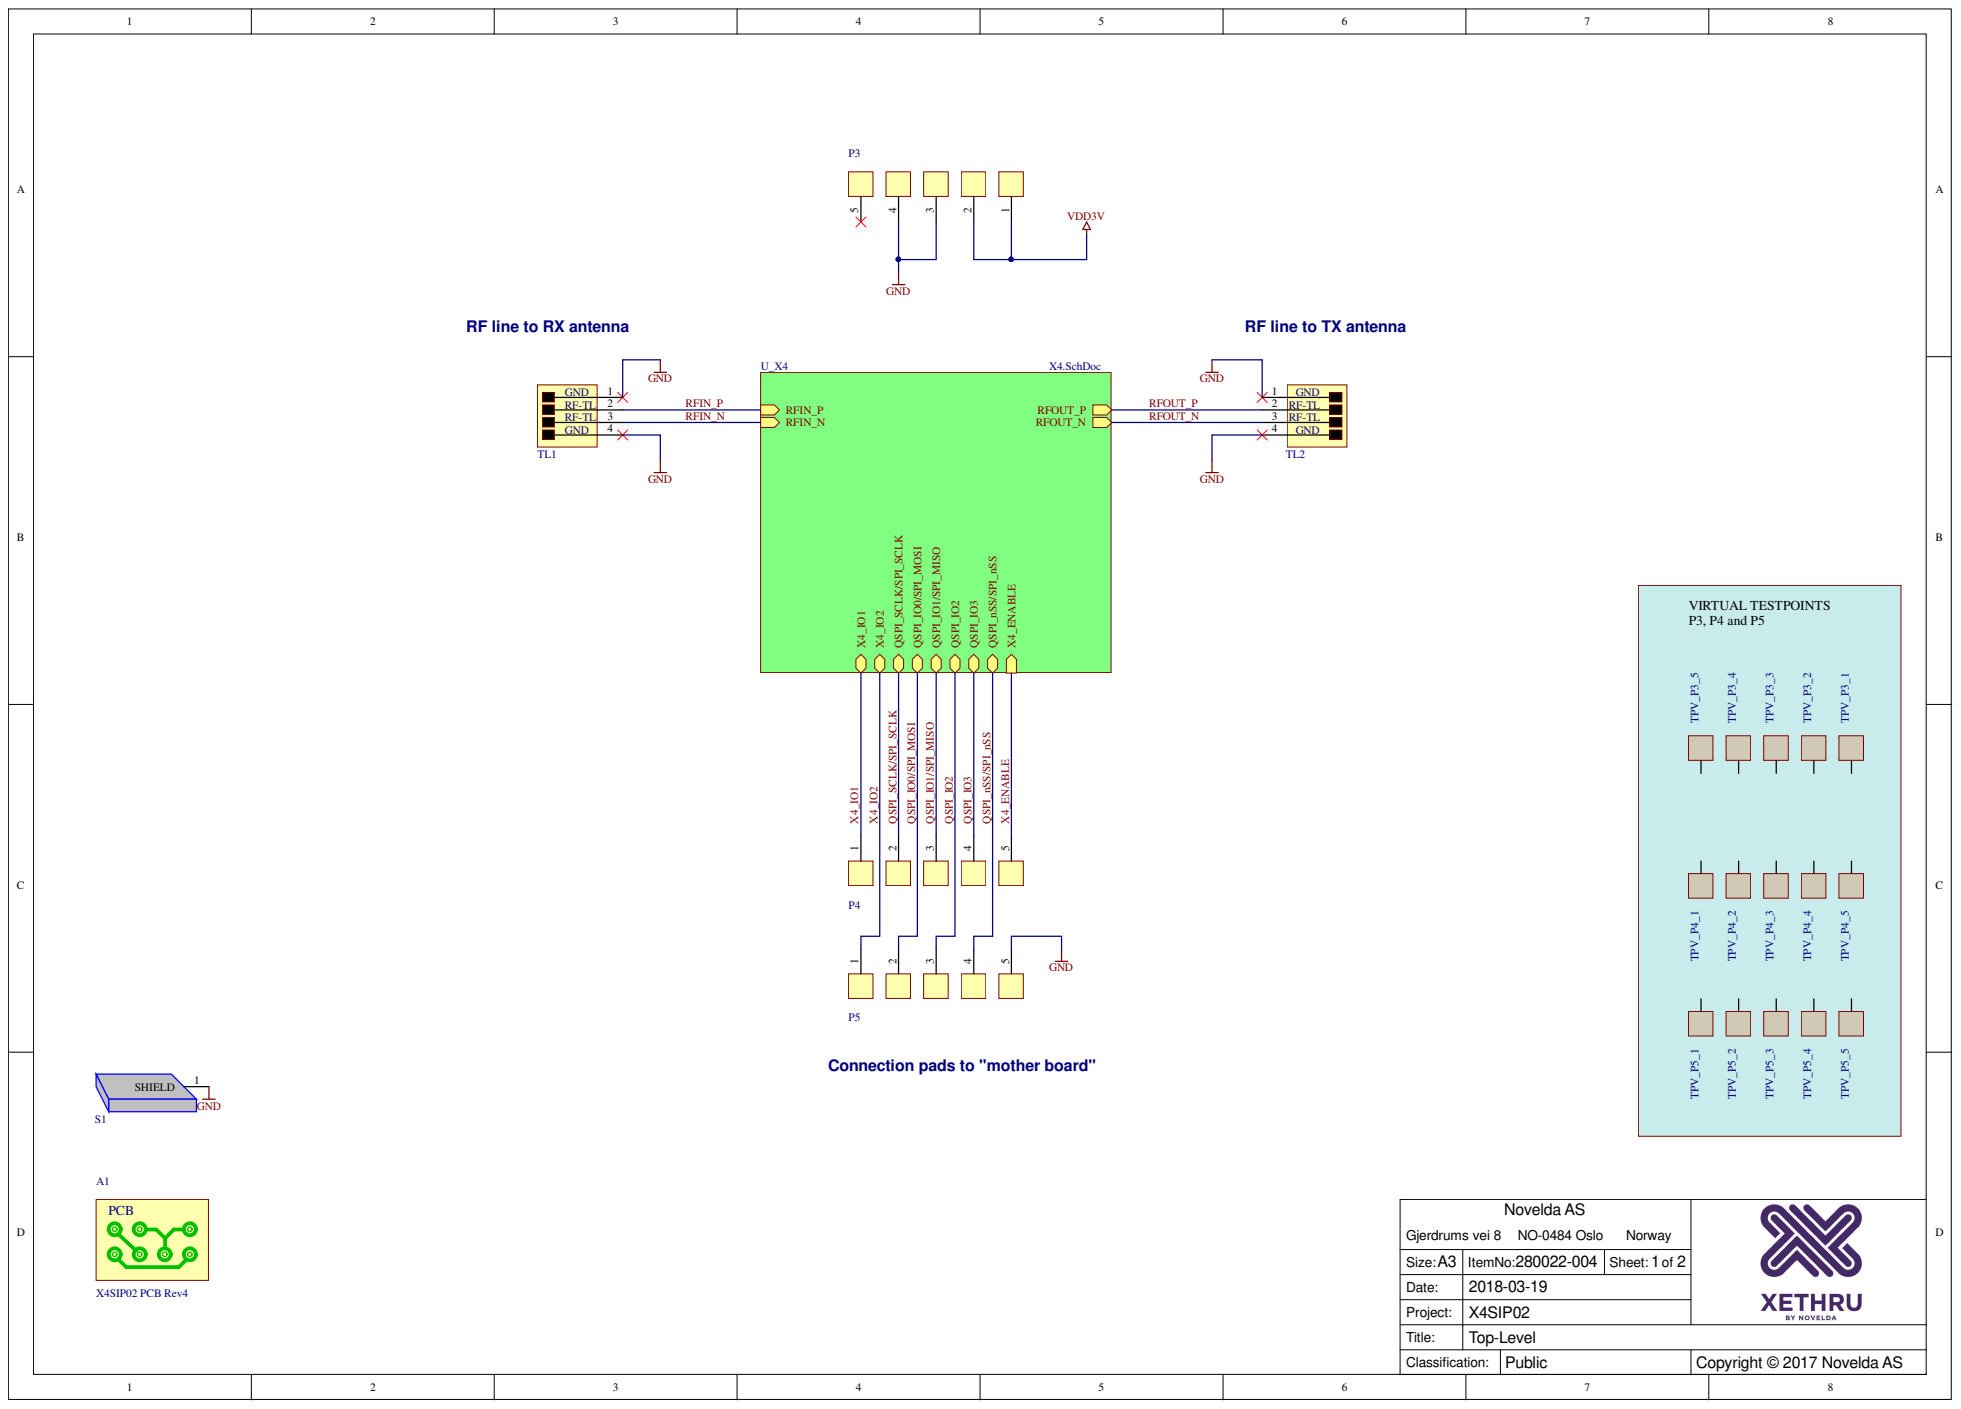
[picture p63: page 7]

RF line to RX antenna

RF line to TX antenna

RF-TL | 3 RFIN_N | RFOUT_N 3 | RF-TL
GND | 4 | 4 | GND

Connection pads to "mother board"

Size:A3 | ItemNo:280022-004 | Sheet: 1of 2
Date: | 2018-03-19

Project: | X4SIP02
Title: | Top-Level
Classification: | Public | Copyright © 2017 Novelda AS

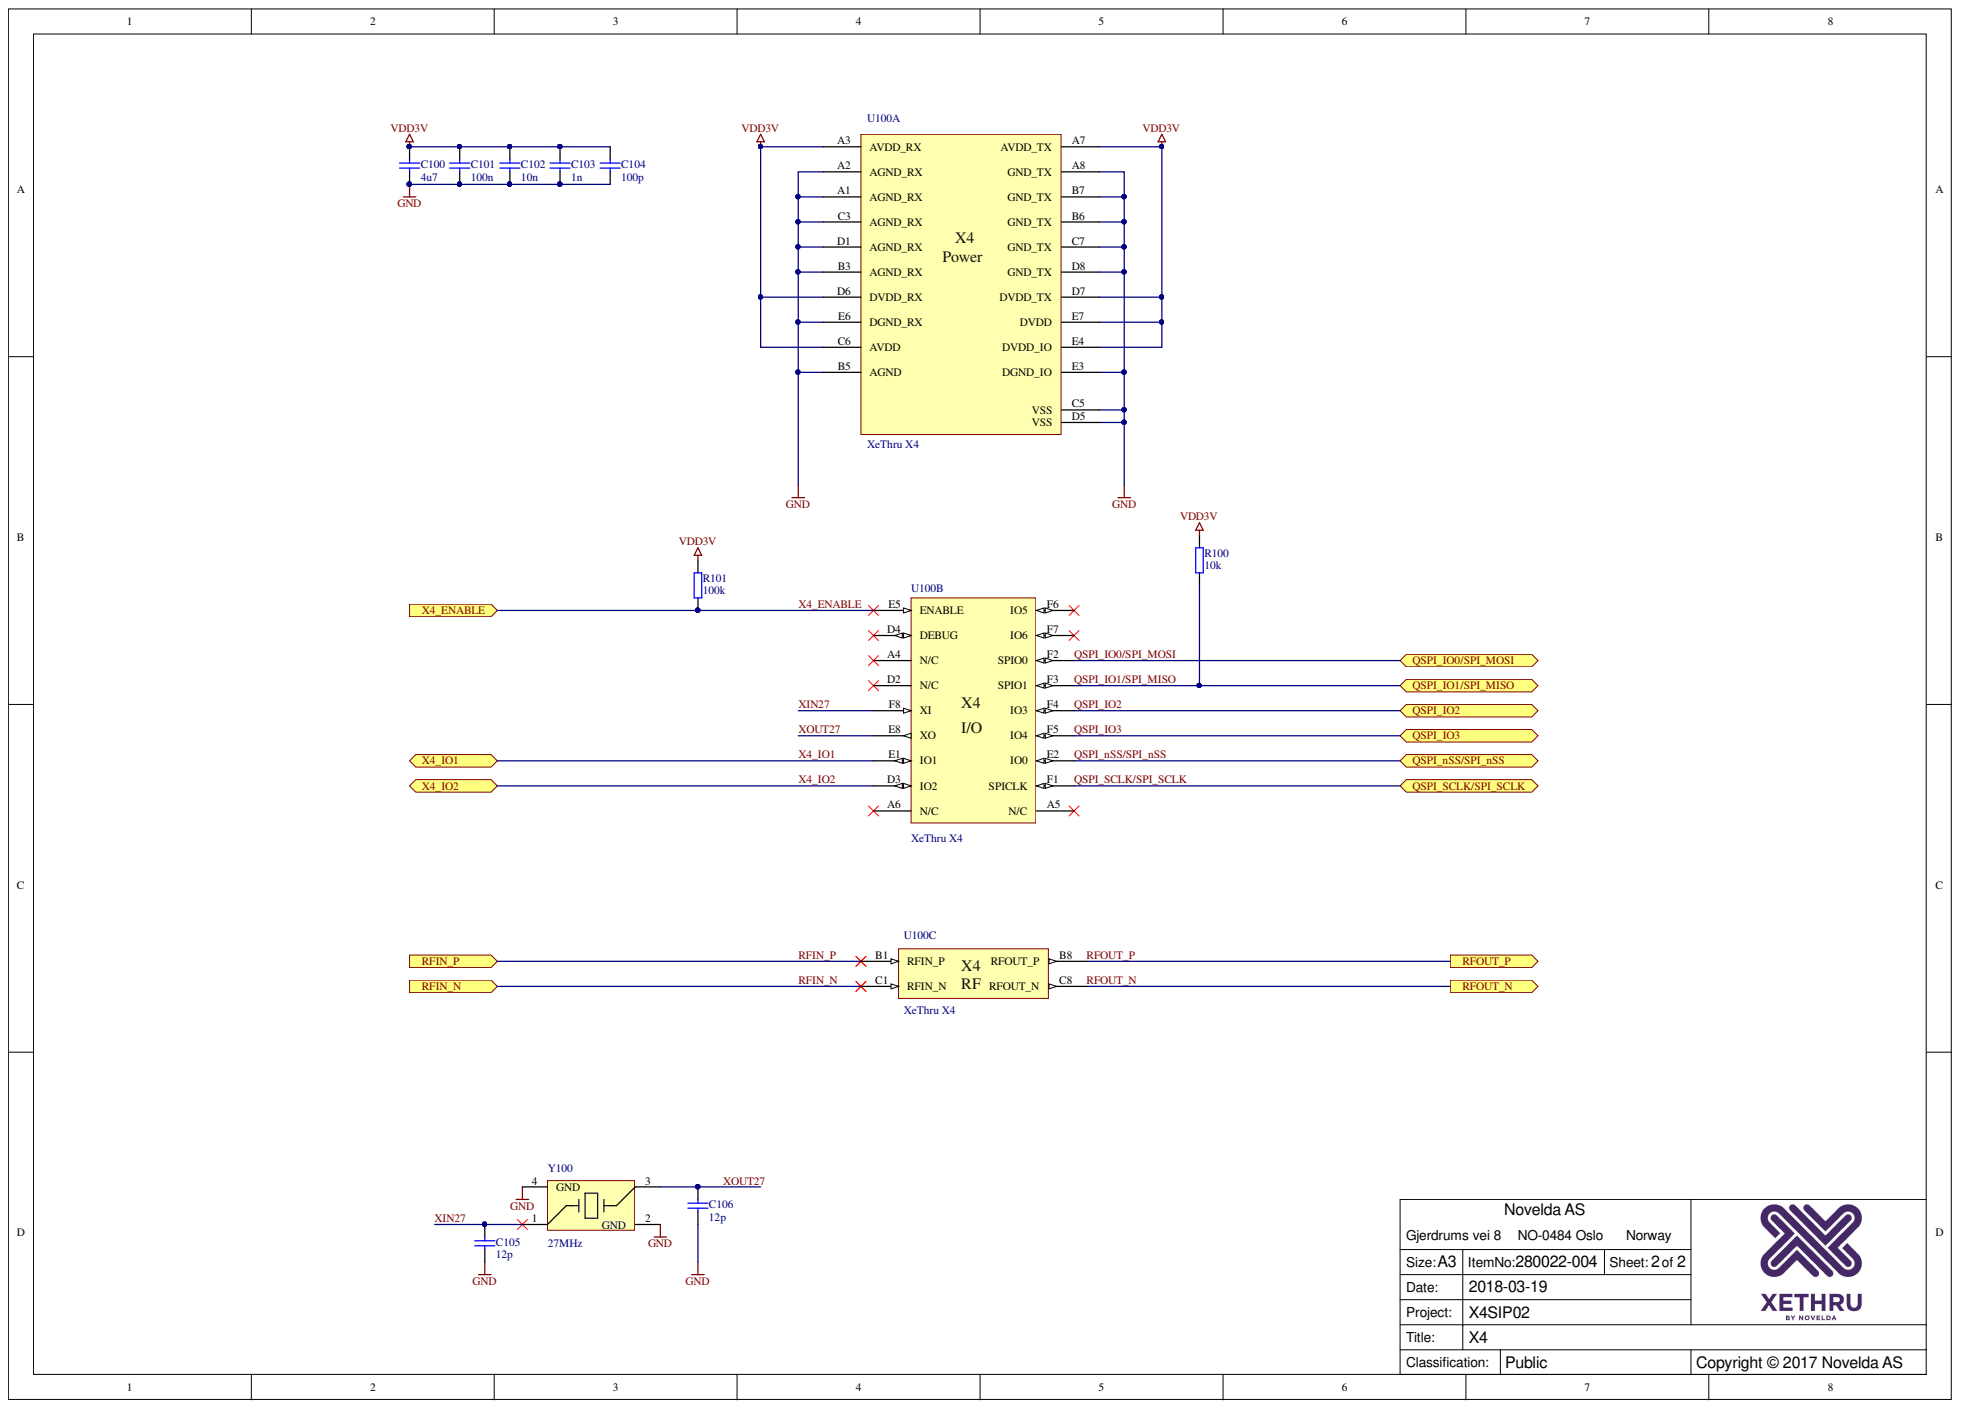
[picture p64: page 8]

Novelda AS Gjerdrums vei 8 NO-0484 Oslo Norway

Size:A3 | ItemNo:280022-004 | Sheet: 2of 2
Date: | 2018-03-19

Project: | X4SIP02

Title: | X4
Classification: | Public | Copyright © 2017 Novelda AS

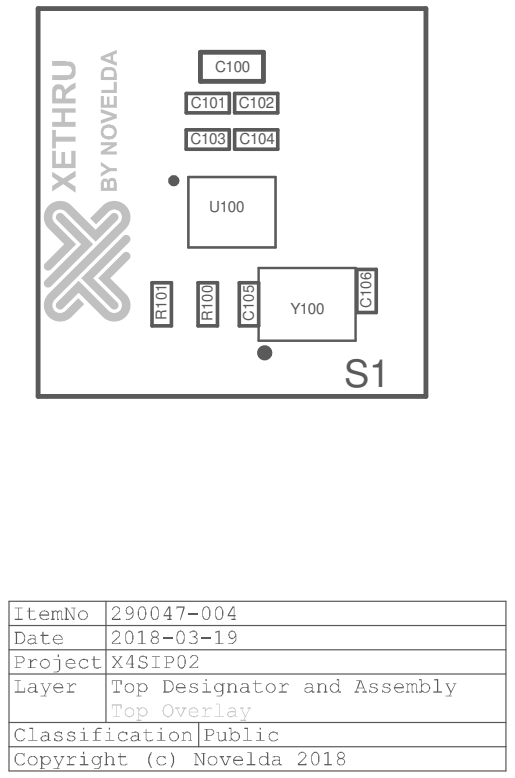
[picture p65: page 9]

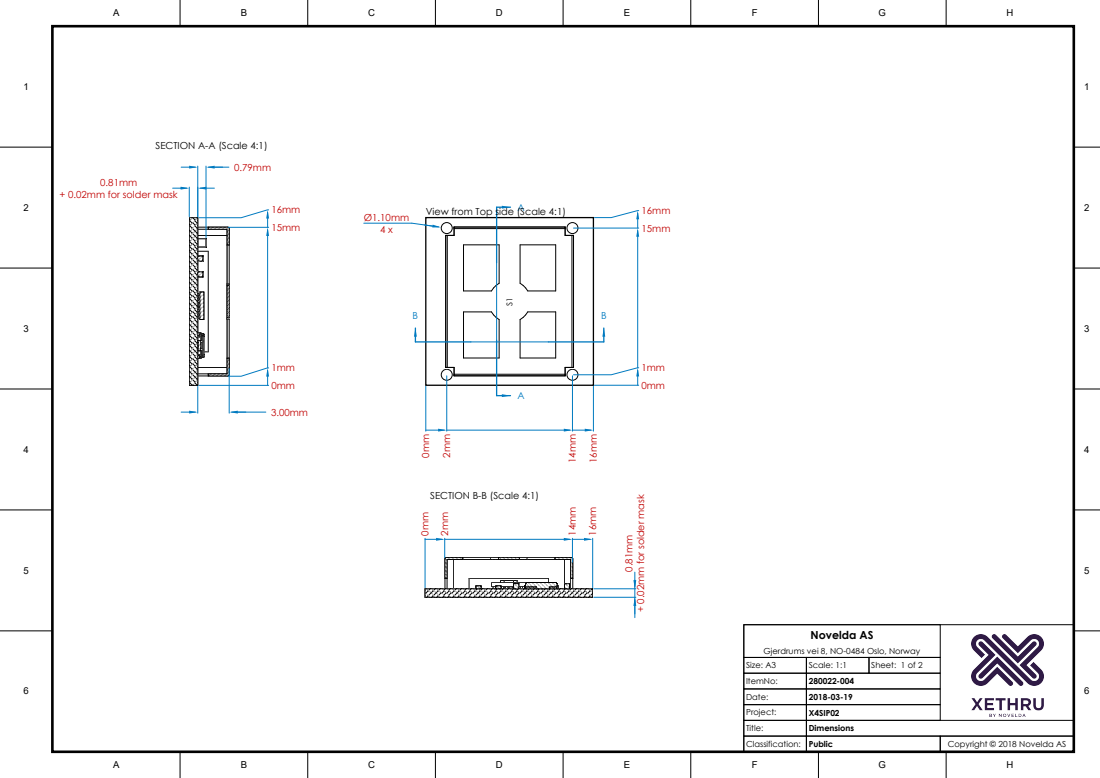
[picture p66: page 10]

View from Top side (Scale 4:1)

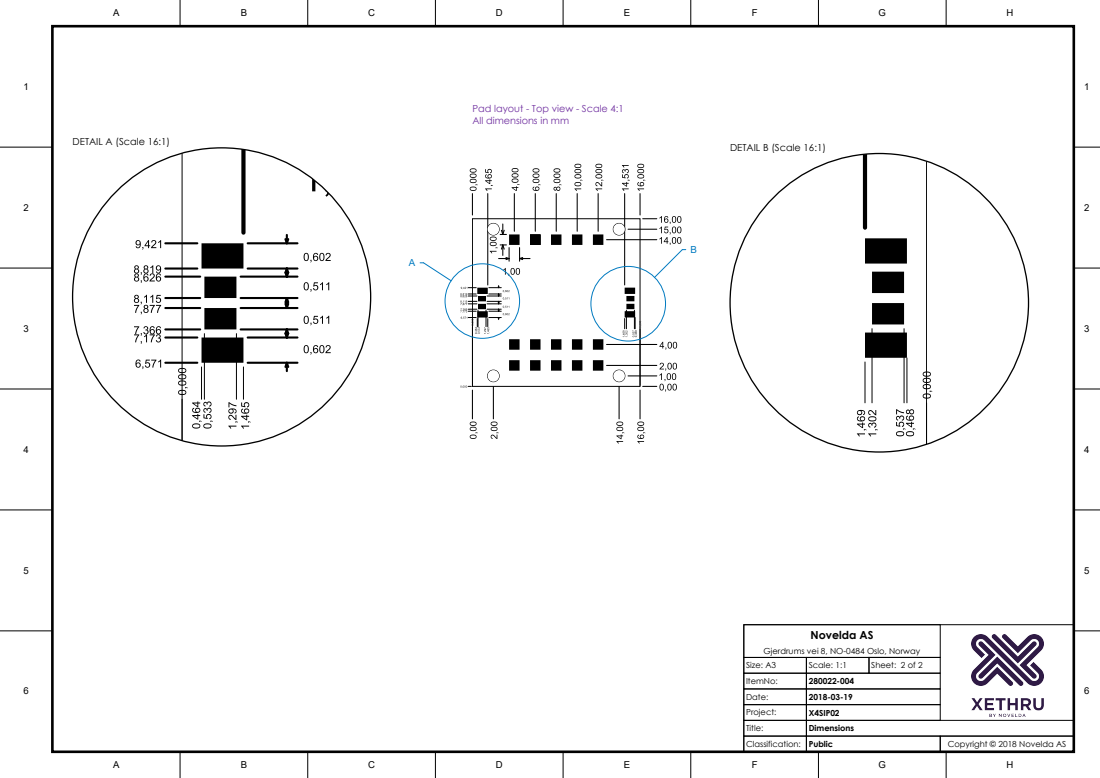
[picture p67: page 11]

Pad layout - Top view - Scale 4:1
All dimensions in mm

Novelda AS Gjerdrums vei 8, NO-0484 Oslo, Norway

Size: A3 | Scale: 1:1 | Sheet: 2 of 2
ItemNo: | 280022-004
Date: | 2018-03-19
Project: | X4SIP02
Title: | Dimensions
Classification: | Public | Copyright © 2018 Novelda AS

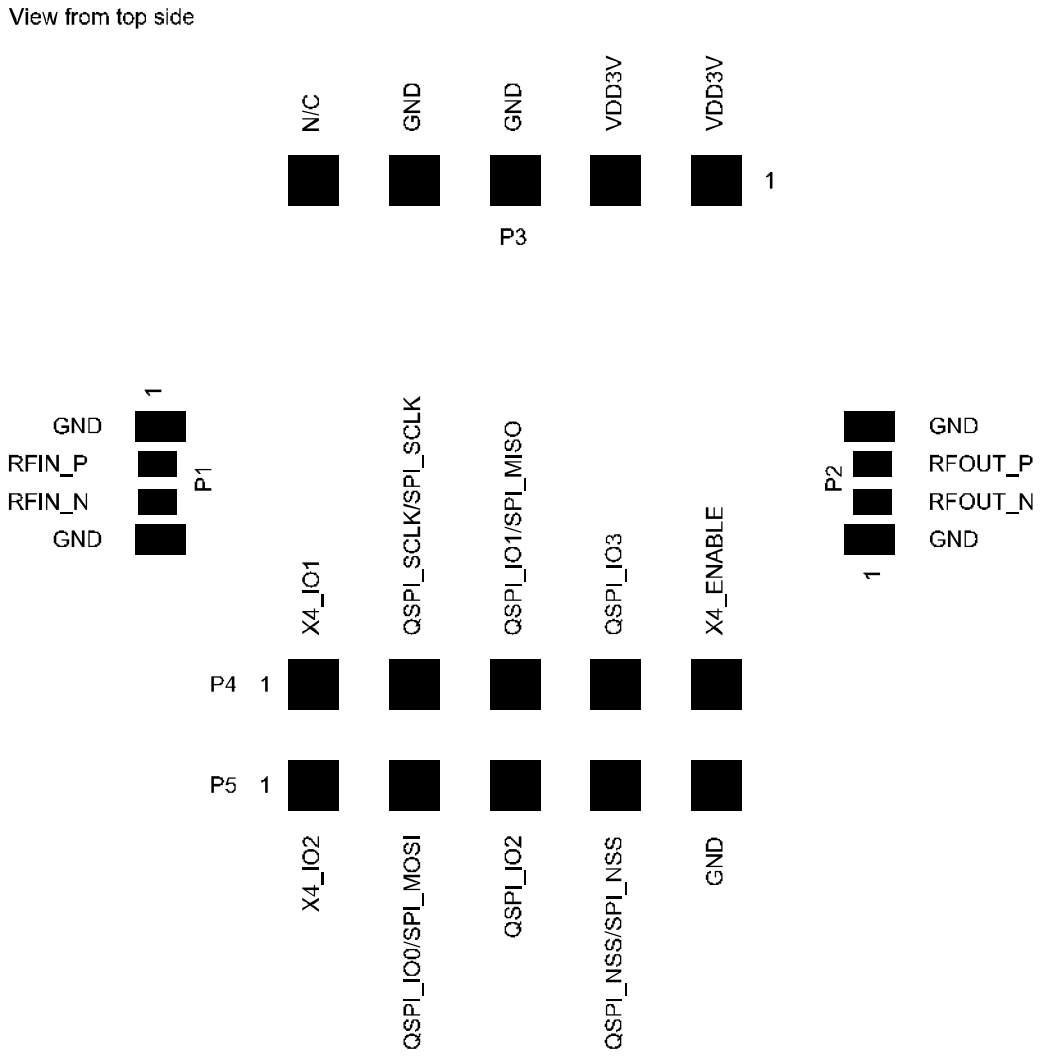
[picture p68: page 12]
