novelda/Legacy-HW/XTMCU02-Rev4_1_Design-Documentation_Public/PCB_Doc_290052-004/PCB_Doc-290052-004.PDF

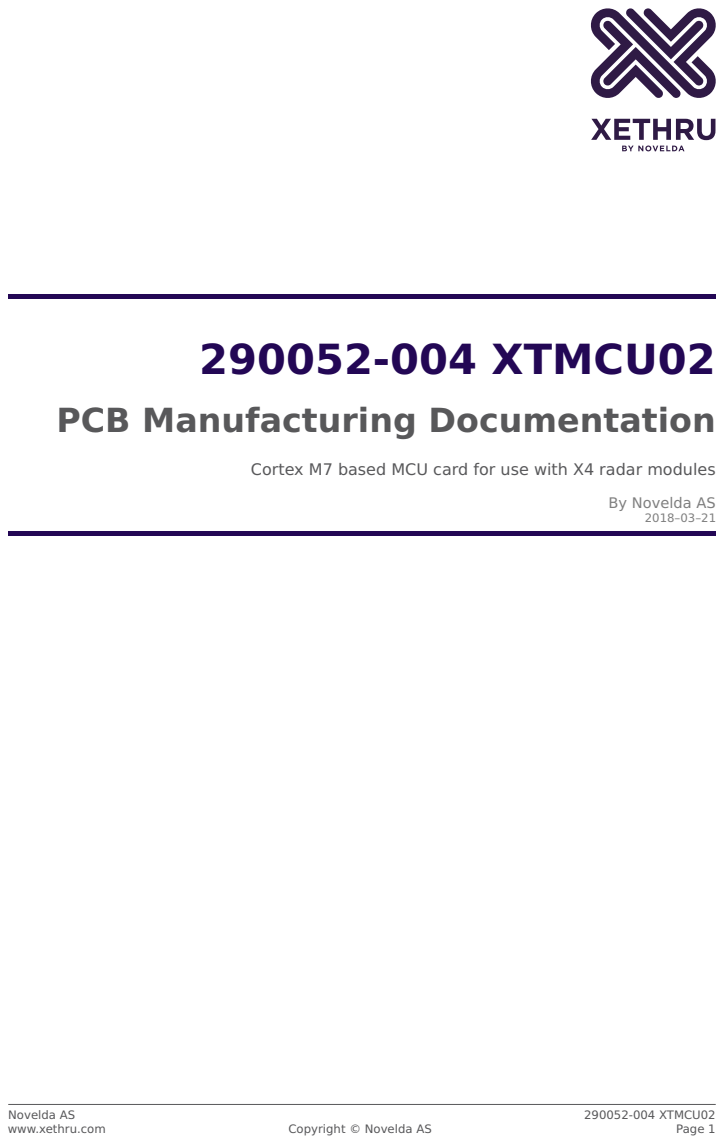
[picture p69: page 1]

Cortex M7 based MCU card for use with X4 radar modules

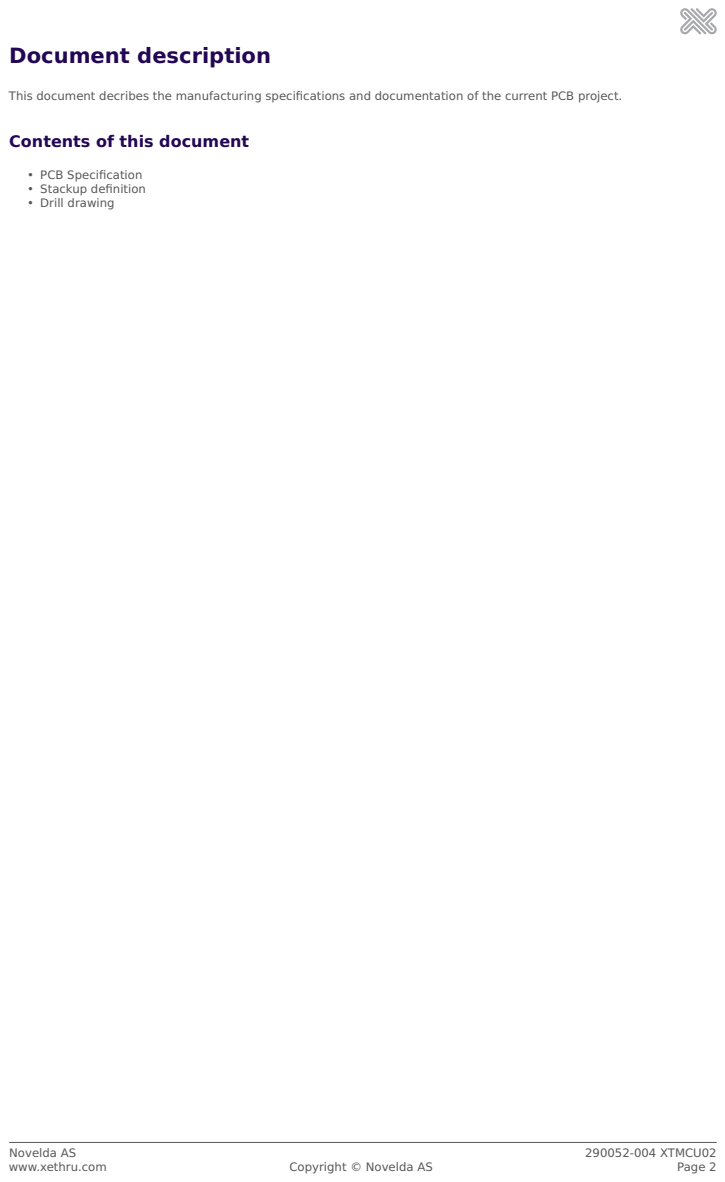
[picture p70: page 2]

This document decribes the manufacturing specifications and documentation of the current PCB project.

Contents of this document

# PCB Specification

Category | Property | Value | Comments
Mechanical Data | No. of Layers | 6
| Board width mm | 33.2
| Board length mm | 27.0
Material Data | Final Cu thickness external layers um | 40 | min 33.4
| Final Cu thickness internal layers um | 40 | min 33.4
Soldermask | Solder resist top | Yes
| Solder resist bottom | Yes
| Solder resist color | Blue
Prints / masks | Silkscreen top | Yes
| Silkscreen bottom | Yes
| Silkscreen color | White
| Pb. free label | Yes
Finish | Hot Air Solder Level (HASL), Lead-free | No
| Electroless nickel immersion gold
| (ENIG) | Yes
Gerber / Drill format | Unit | mil
| Format | 2:4 (0.1mil)
Clearance | External layers um | 100
| Internal layers um | 100
Tolerances | PCB Dimensions / outline mm | +0.2 / -0.1
Vias | Filled | No
| Capped | No

Page 3

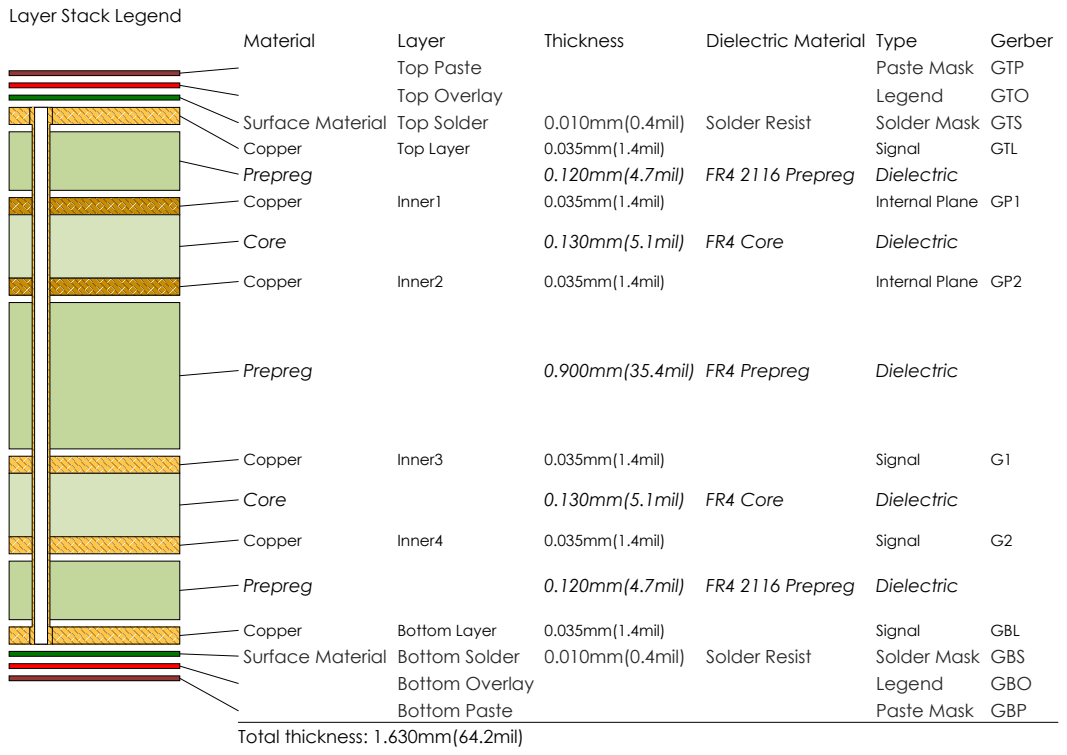
[picture p71: page 4]

Novelda AS Gjerdrums vei 8, NO-0484 Oslo, Norway

Size: A3 | Scale: 1:1 | Sheet: 1 of 1
ItemNo: | 290052-004
Date: | 2018-03-21
Project: | XTMCU02
Title: | PCB Layer Stack up
Classification: | Public | Copyright © 2018 Novelda AS

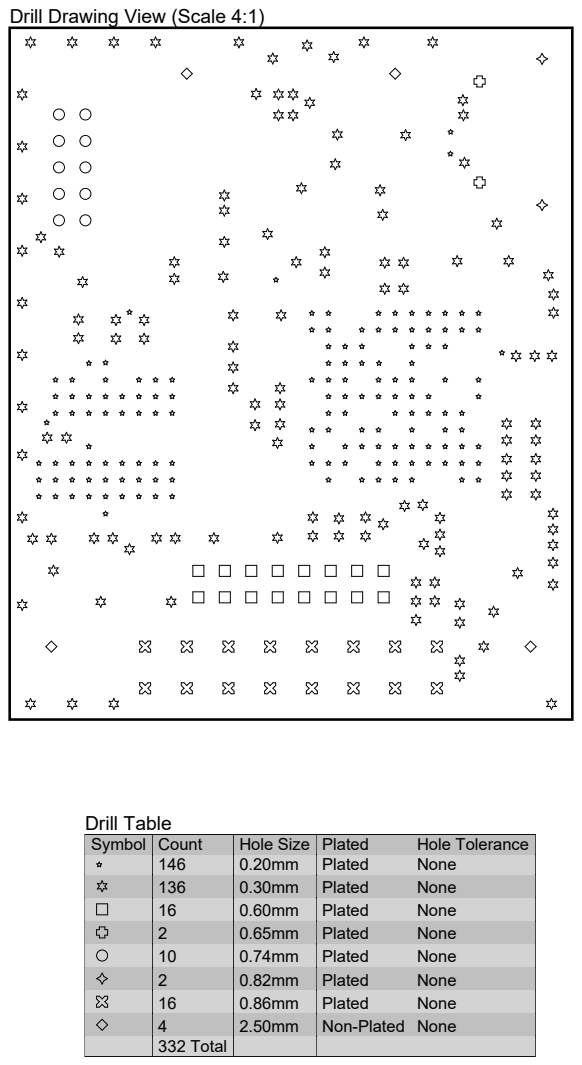
[picture p72: page 5]

Drill Drawing View (Scale 4:1)

Symbol | Count | Hole Size | Plated | Hole Tolerance
146 | 0.20mm | Plated | None
136 | 0.30mm | Plated | None
16 | 0.60mm | Plated | None
2 | 0.65mm | Plated | None
10 | 0.74mm | Plated | None
2 | 0.82mm | Plated | None

Novelda AS Gjerdrums vei 8, NO-0484 Oslo, Norway

4 | 2.50mm | Non-Plated | None
332 Total

ItemNo: | 290052-004
Date: | 2018-03-21
Project: | XTMCU02
Title: | Drill Drawing
Classification: | Public | Copyright © 2018 Novelda AS
