novelda/Legacy-HW/X4A02-PCBA-Rev3_3_Design-Documentation_Public/3D_Print_280024-003.PDF

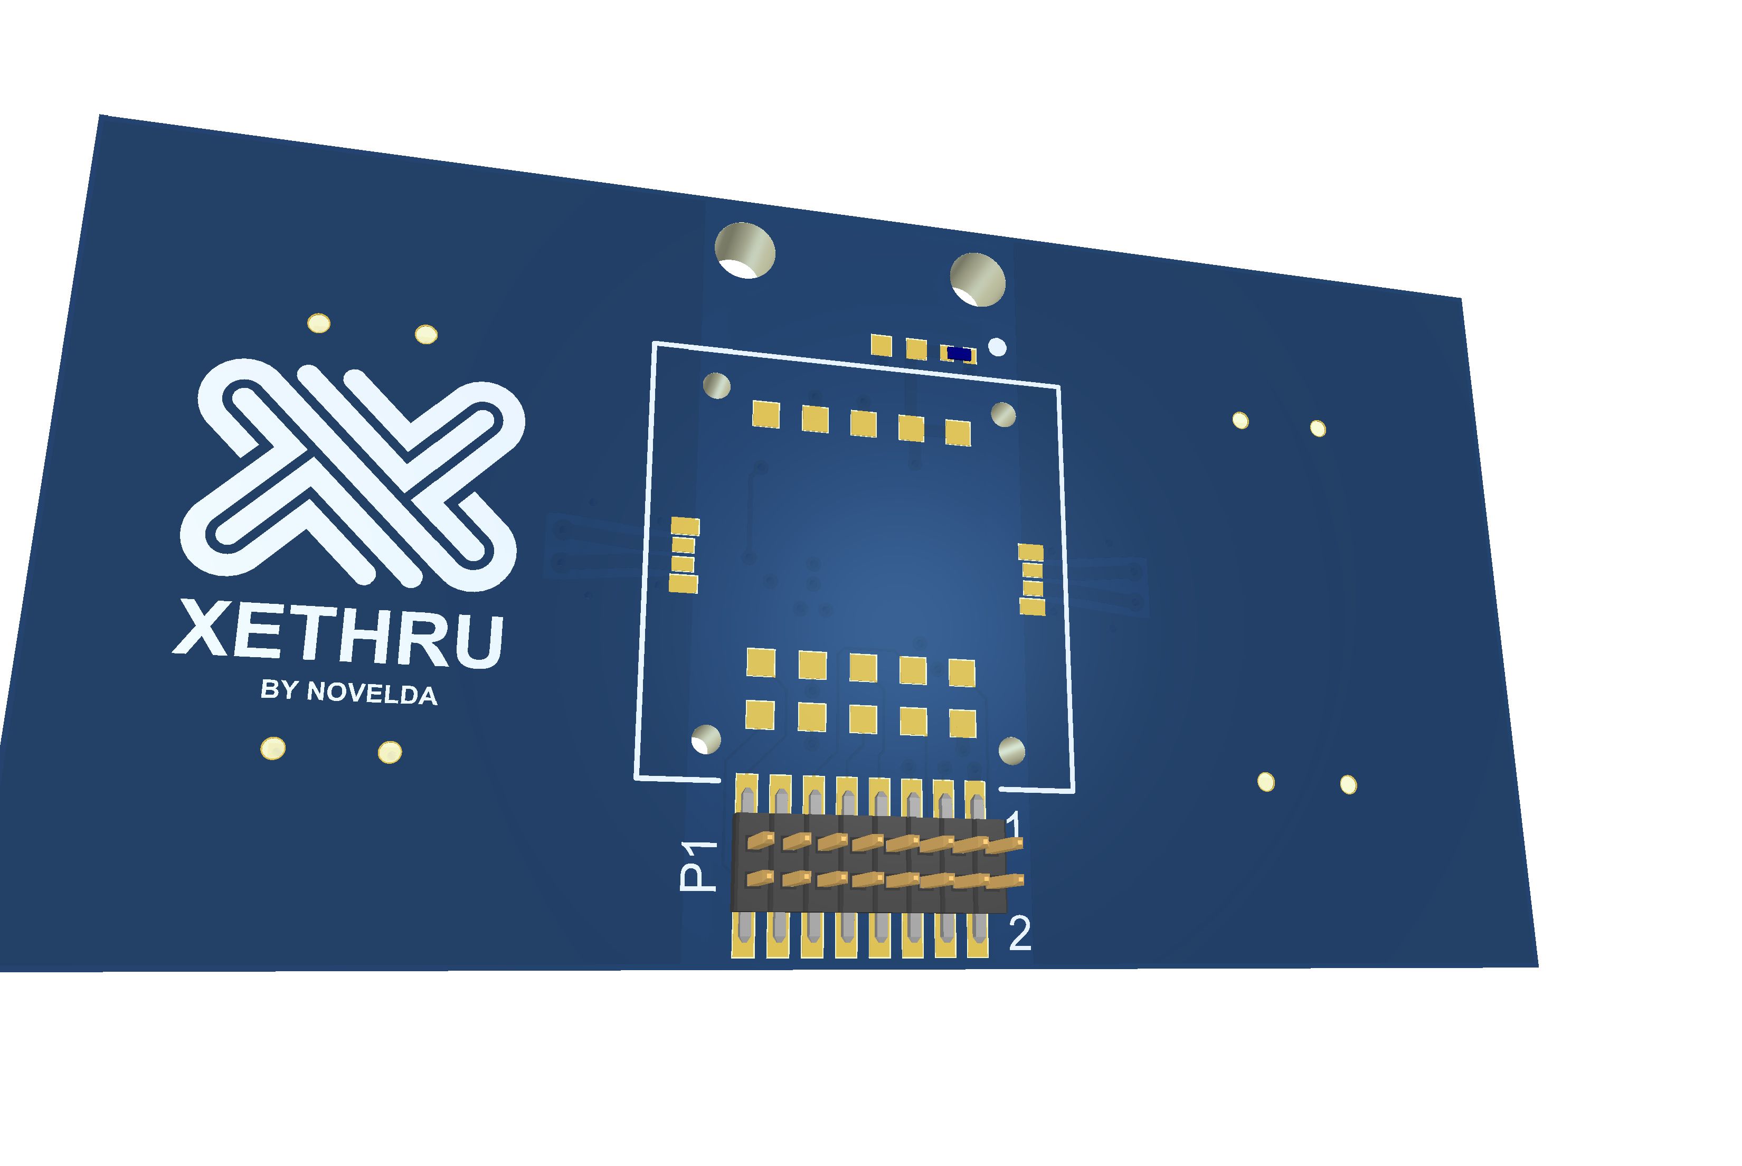
[picture p73: page 1]
