novelda/Legacy-HW/X4M02-PCBA-Rev10_2_Design_Documentation_Public/3D_Print_280031-010.PDF

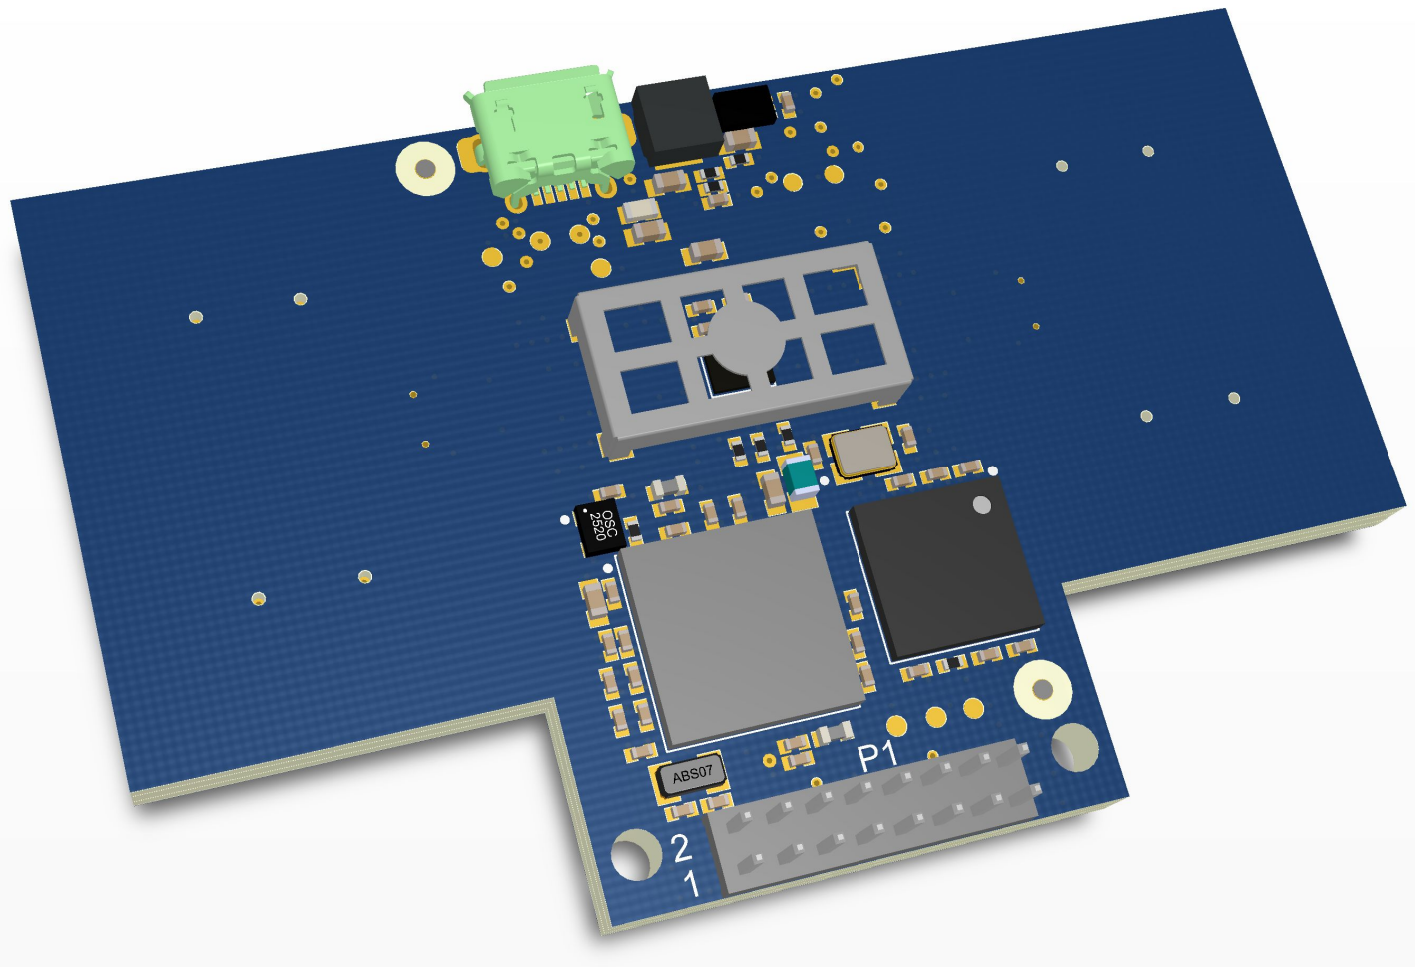
[picture p74: page 1]
