novelda/Legacy-HW/X4M03-Rev5_Design_Documentation_Public/3D_Print_000153-005.PDF

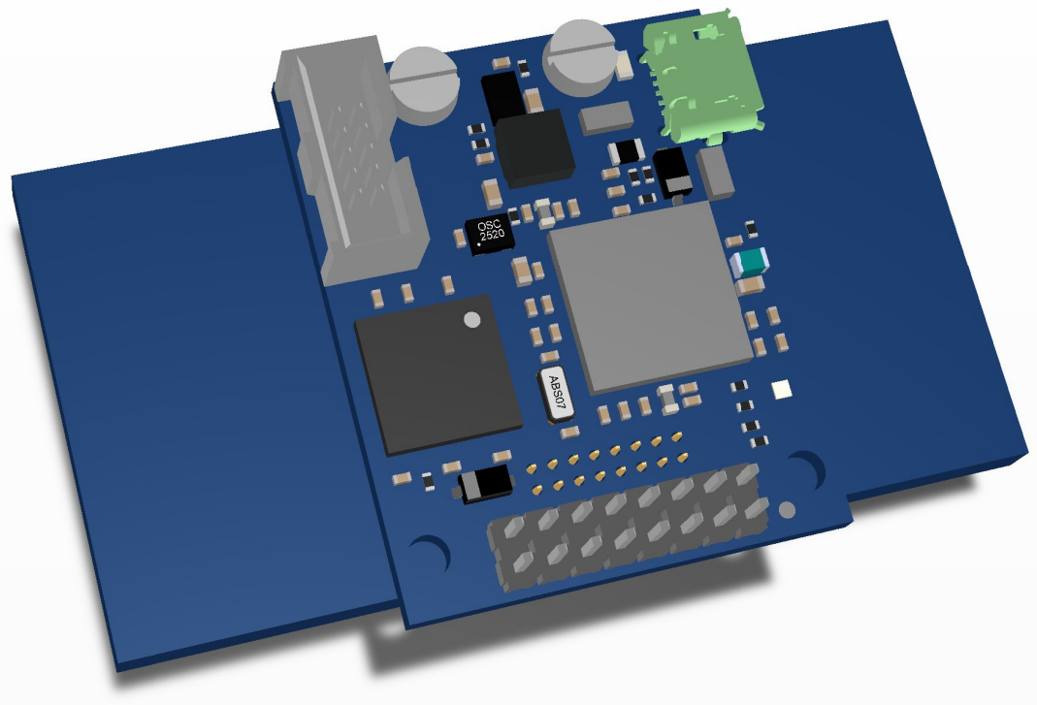
[picture p75: page 1]
