novelda/Legacy-HW/X4M05-Rev3_2_Design_Documentation_Public/3D_Print_280040-003.PDF

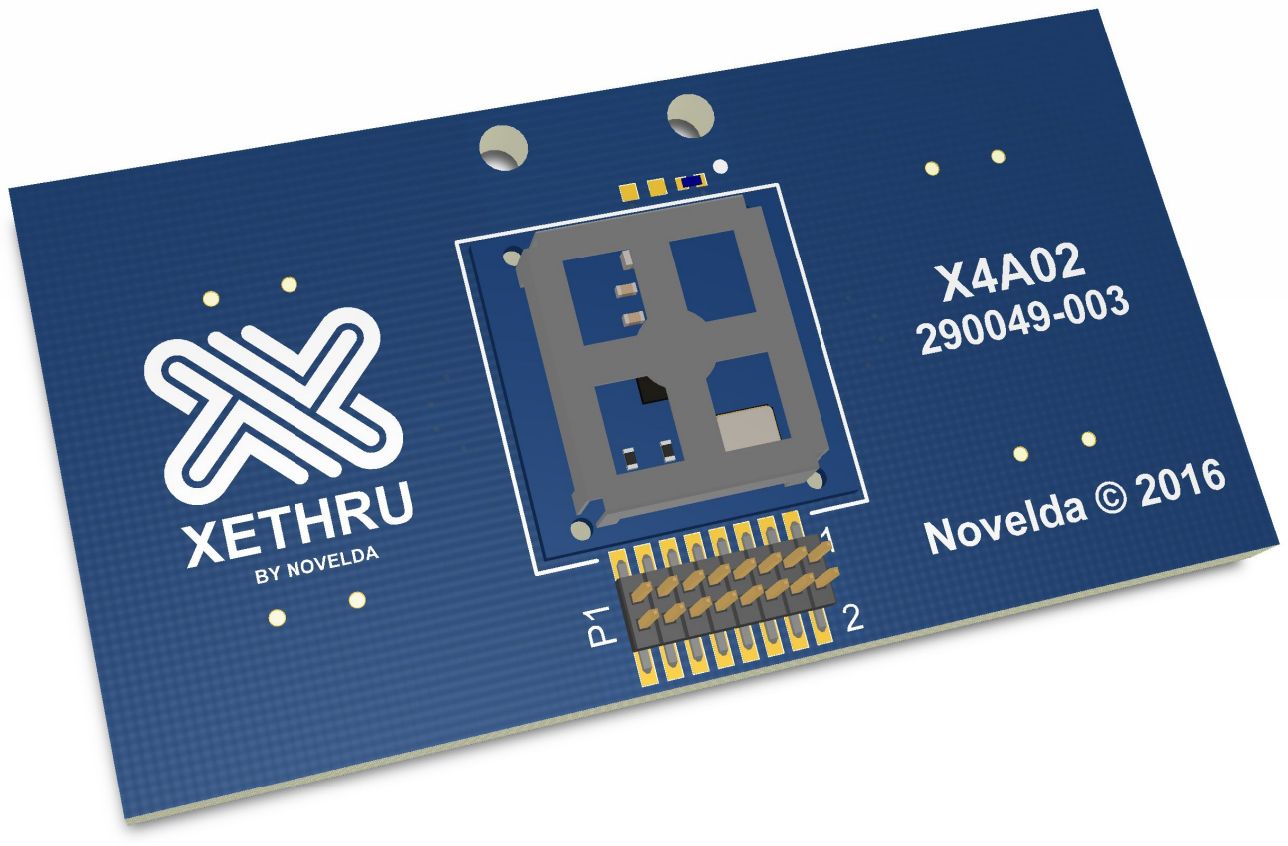
[picture p76: page 1]
