novelda/Legacy-HW/X4M07-Rev2_Design_Documentation_Public/3D_Print_280042-002.PDF

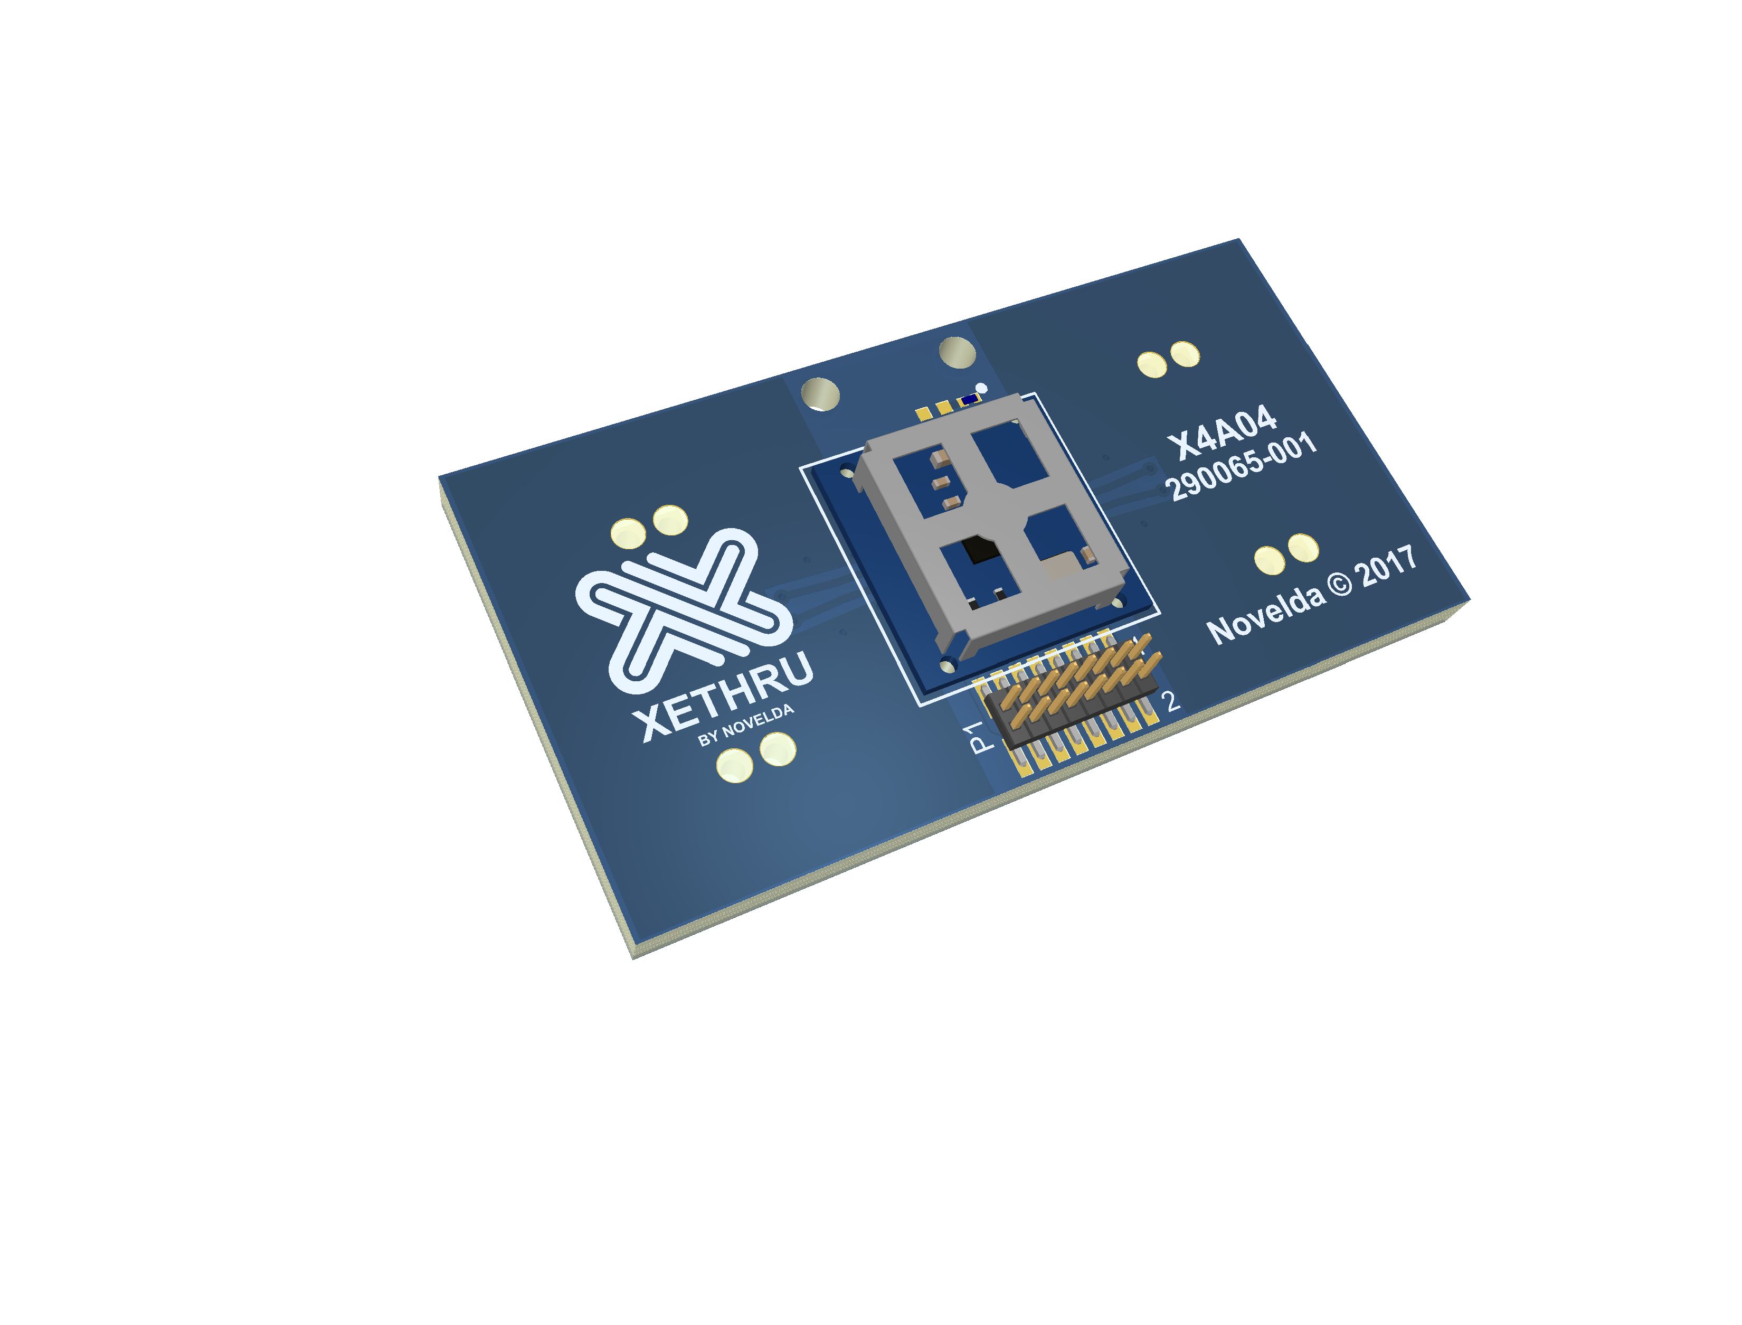
[picture p77: page 1]
