novelda/Legacy-HW/X4SIP02-Rev4_1_Design_Documentation_Public/3D_Print_280022-004.PDF

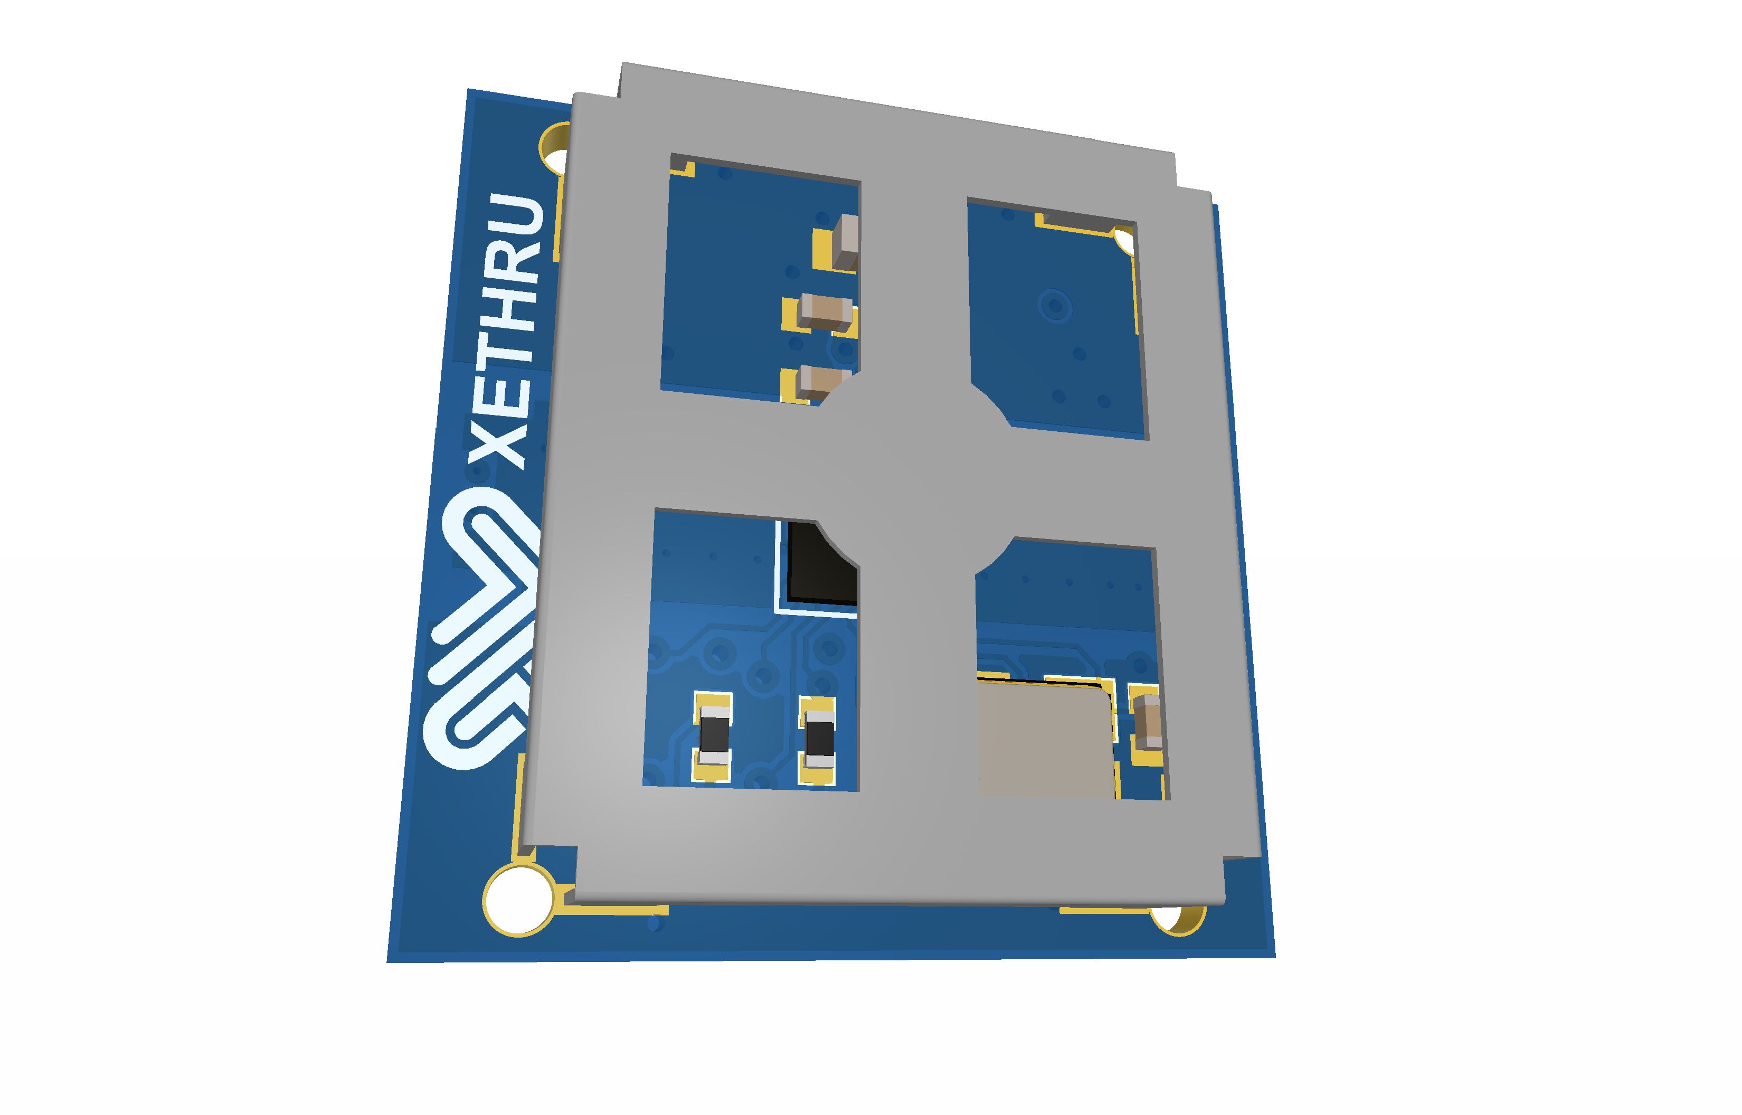
[picture p78: page 1]
