novelda/Legacy-HW/X4SIP02-Rev4_1_Design_Documentation_Public/PCB_Prints_280022-004.PDF

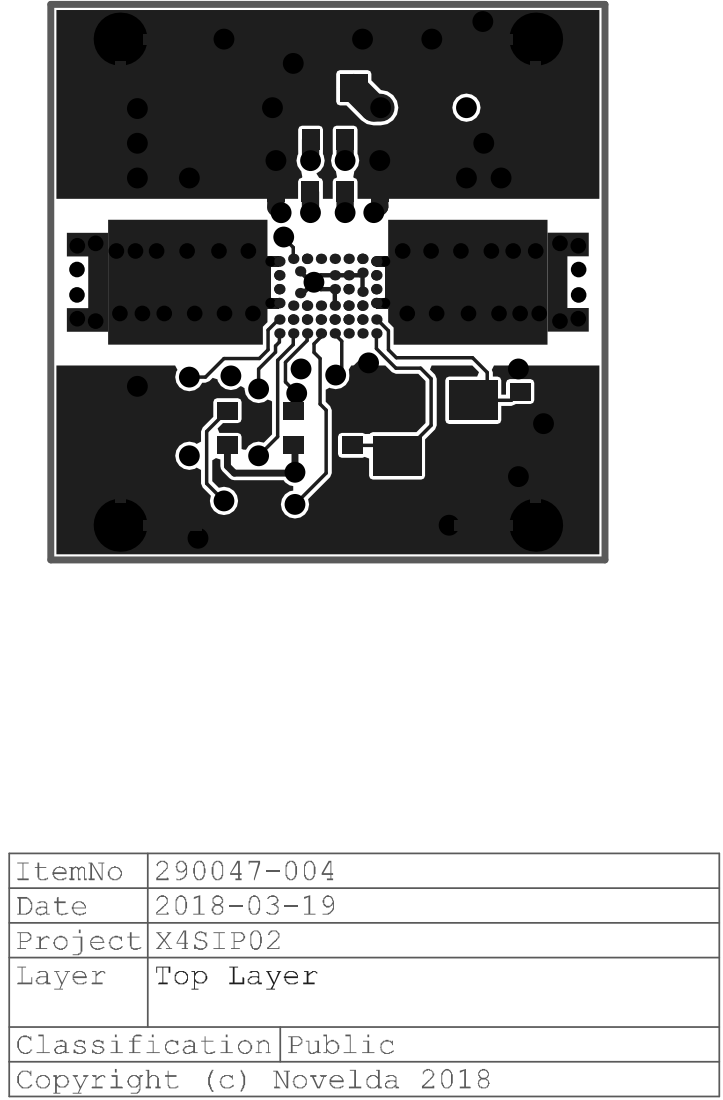
[picture p79: page 1]

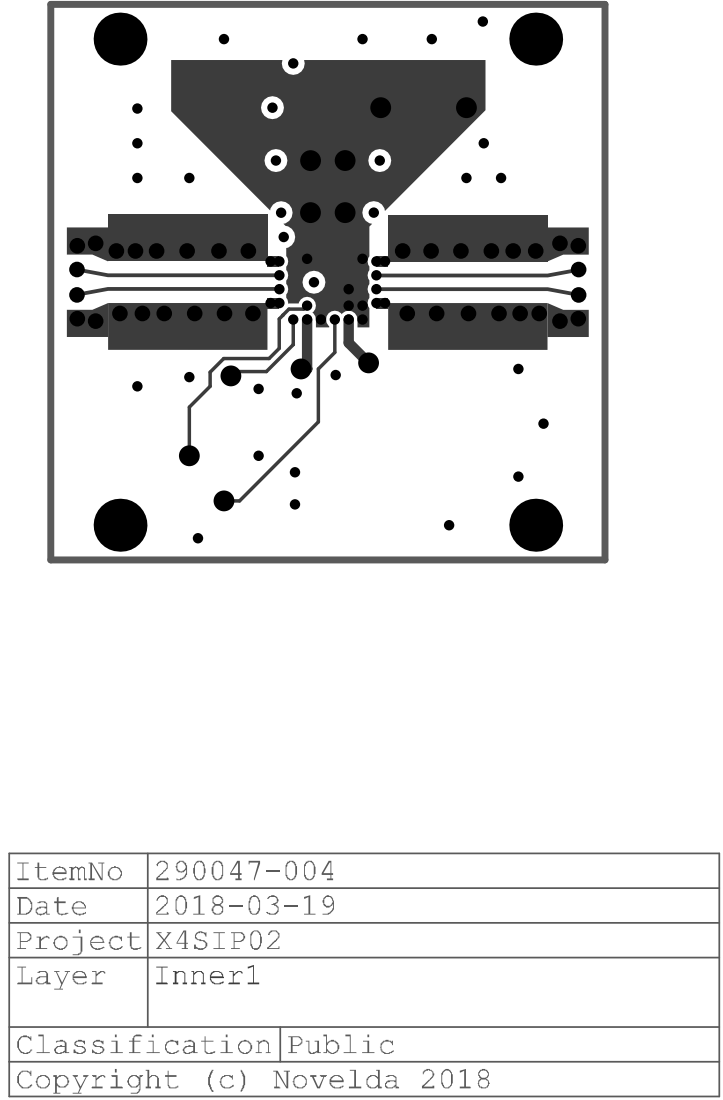
[picture p80: page 2]

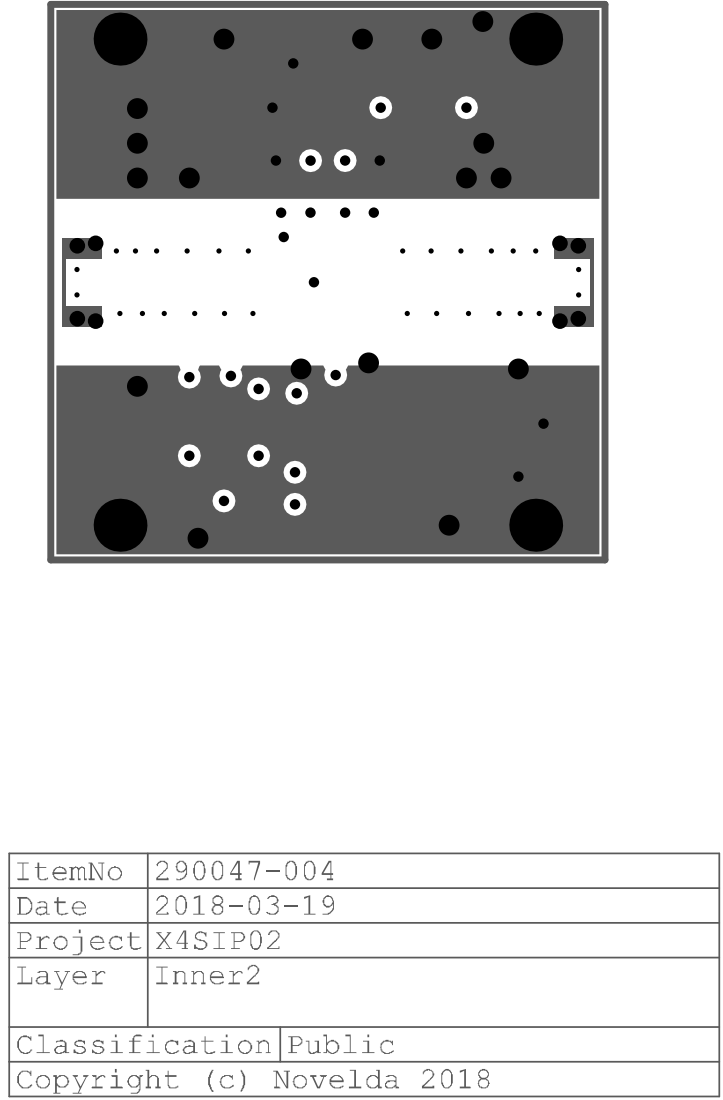
[picture p81: page 3]

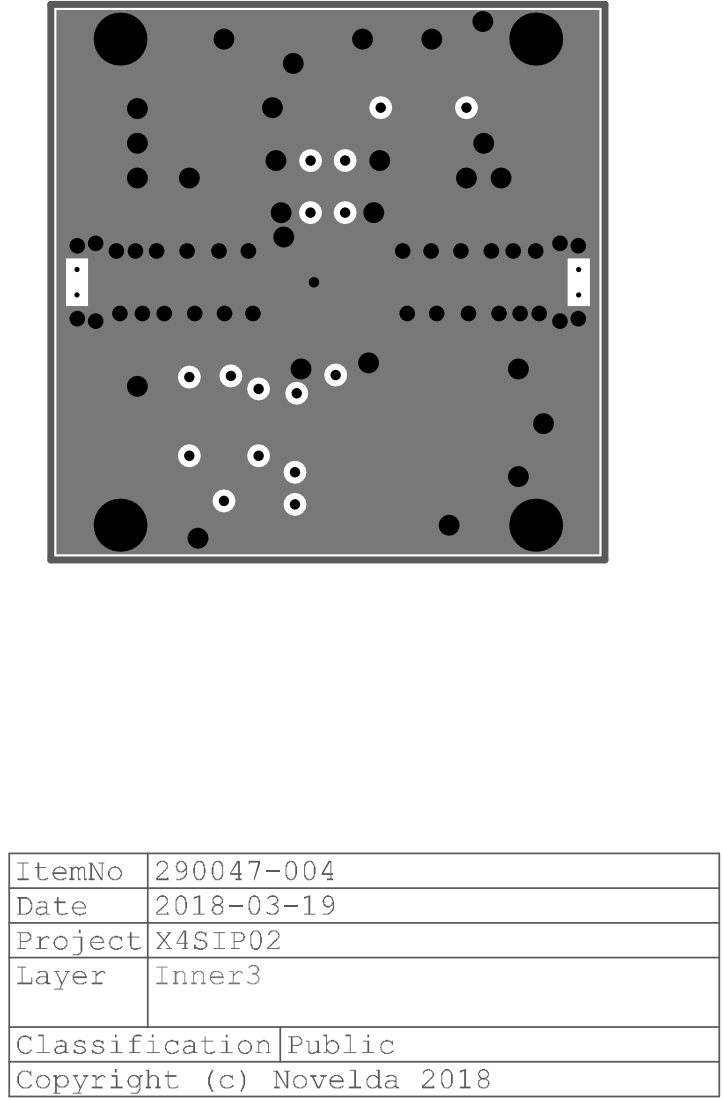
[picture p82: page 4]

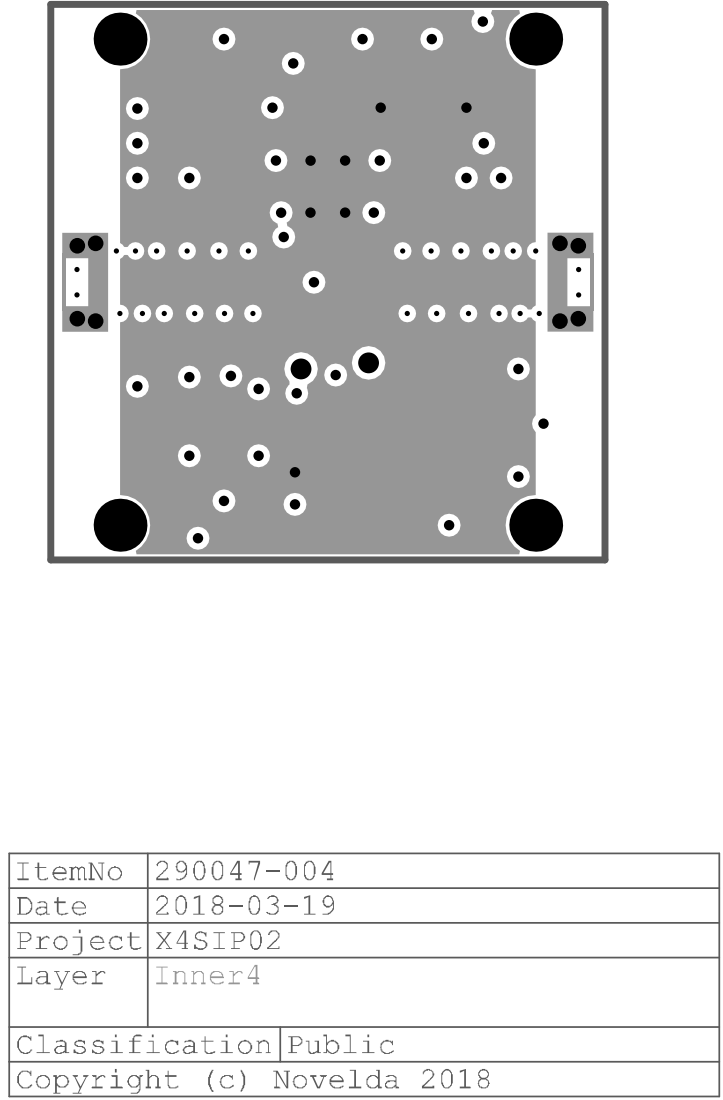
[picture p83: page 5]

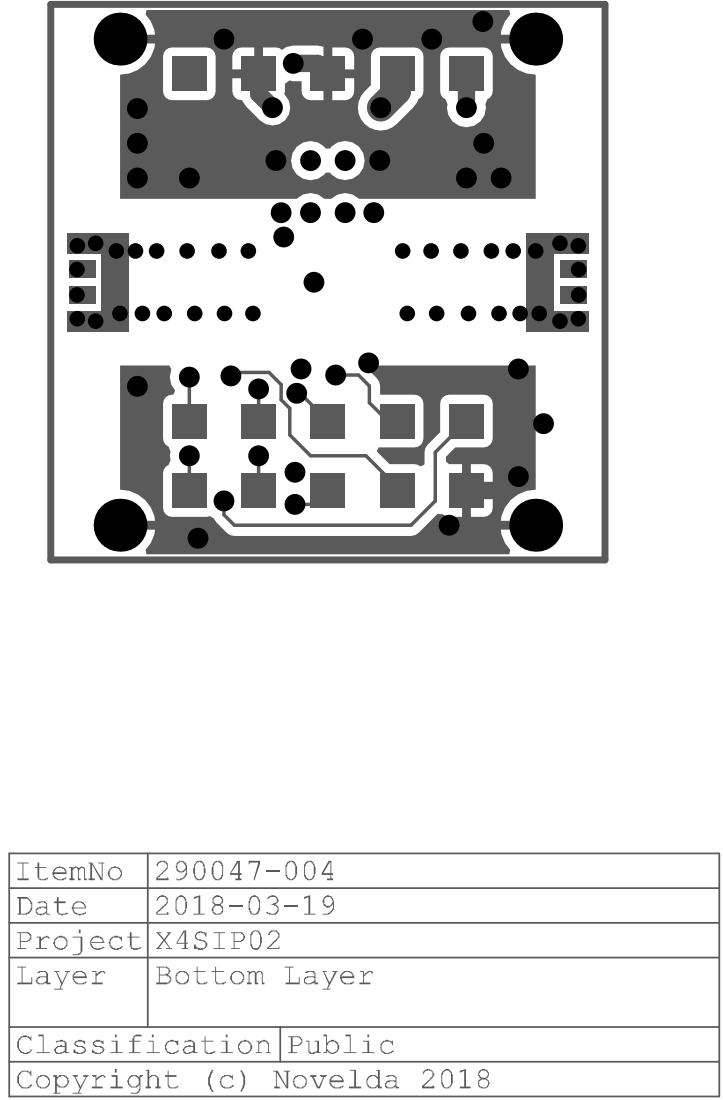
[picture p84: page 6]

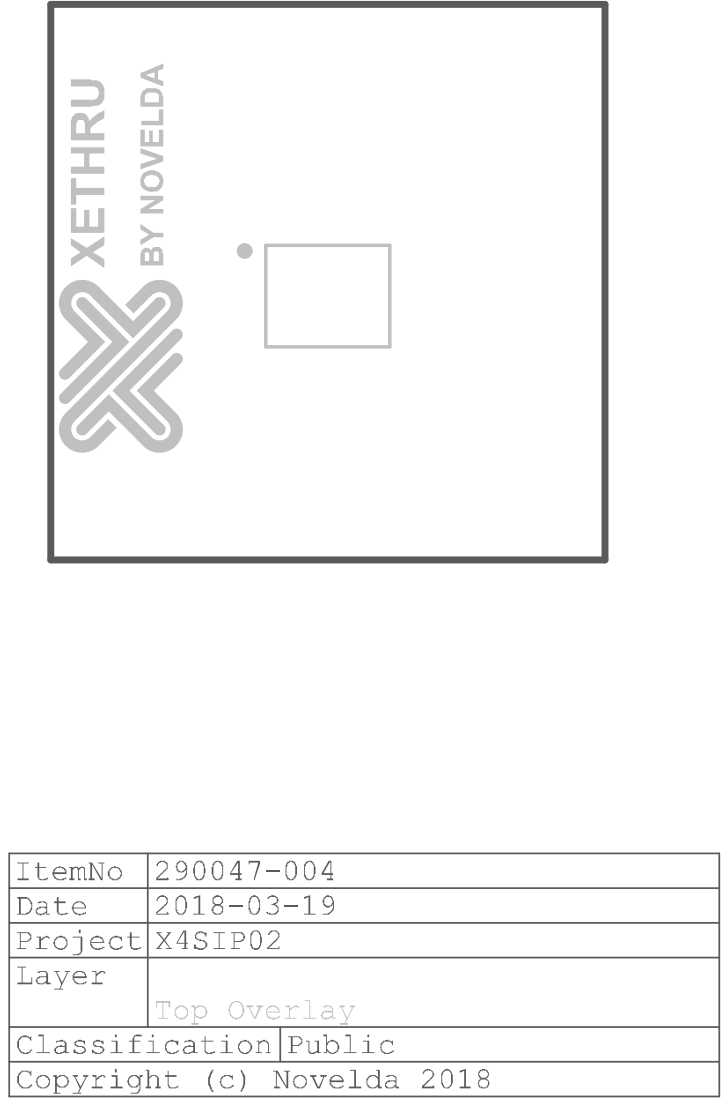
[picture p85: page 7]

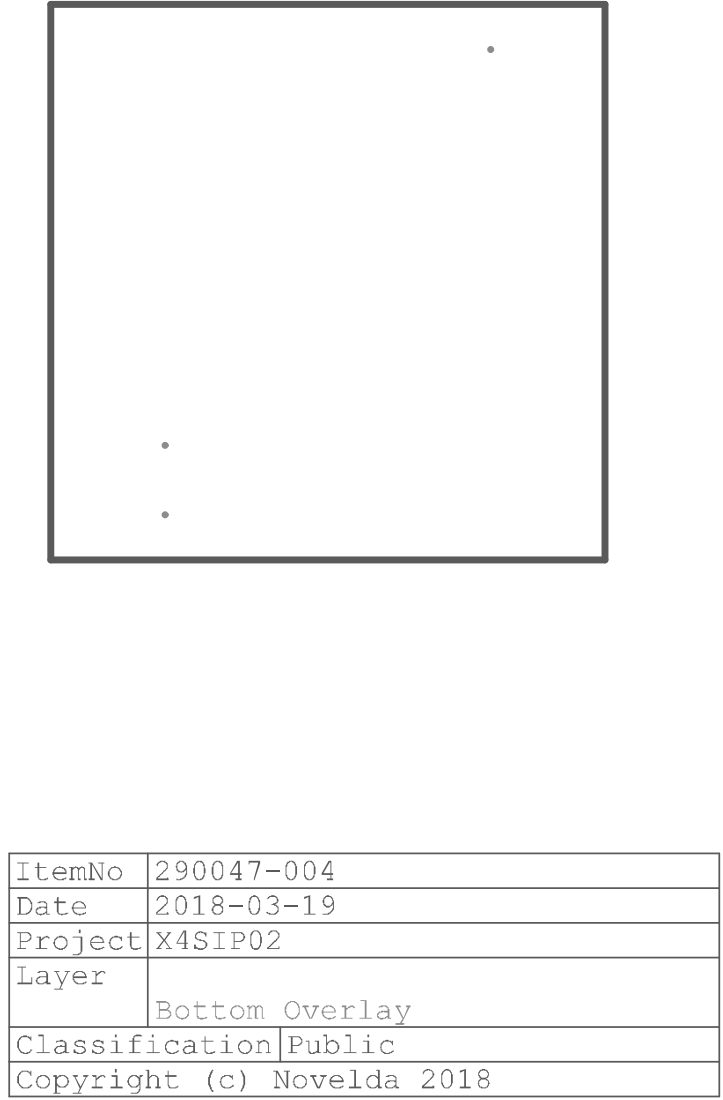
[picture p86: page 8]

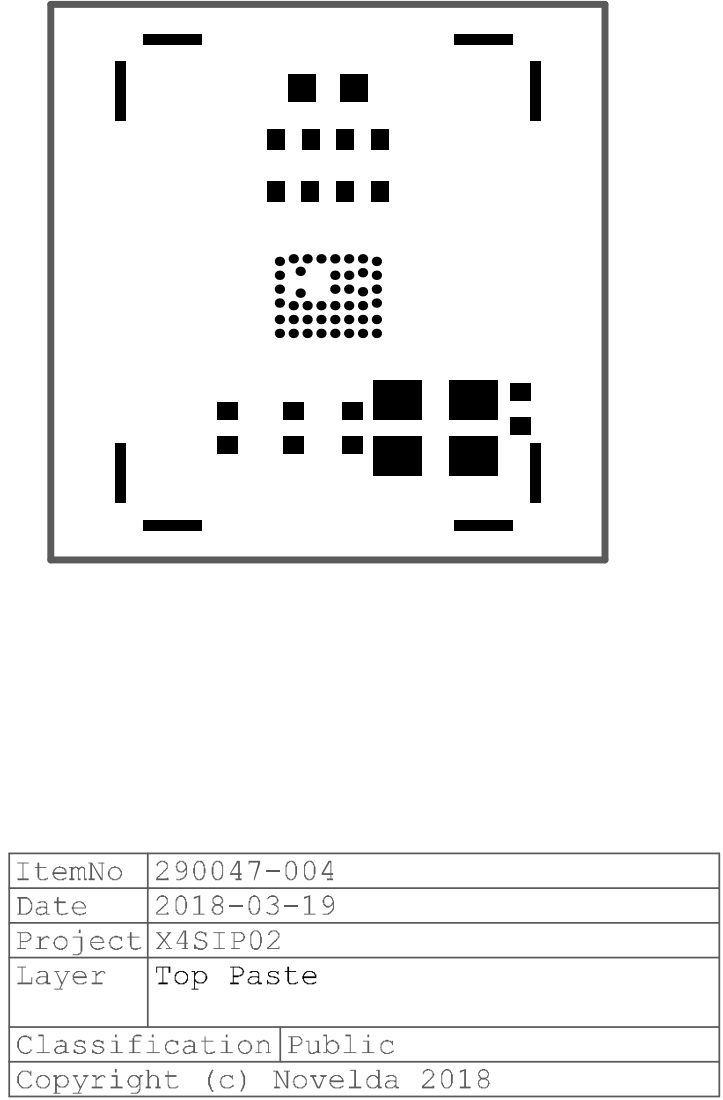
[picture p87: page 9]

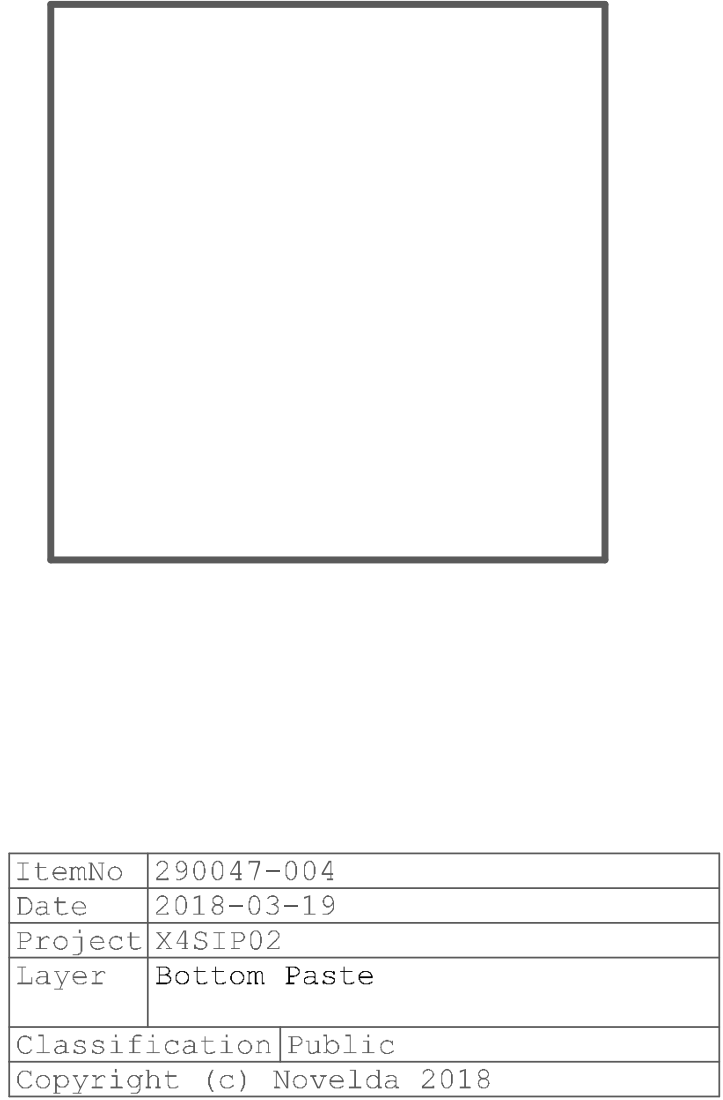
[picture p88: page 10]

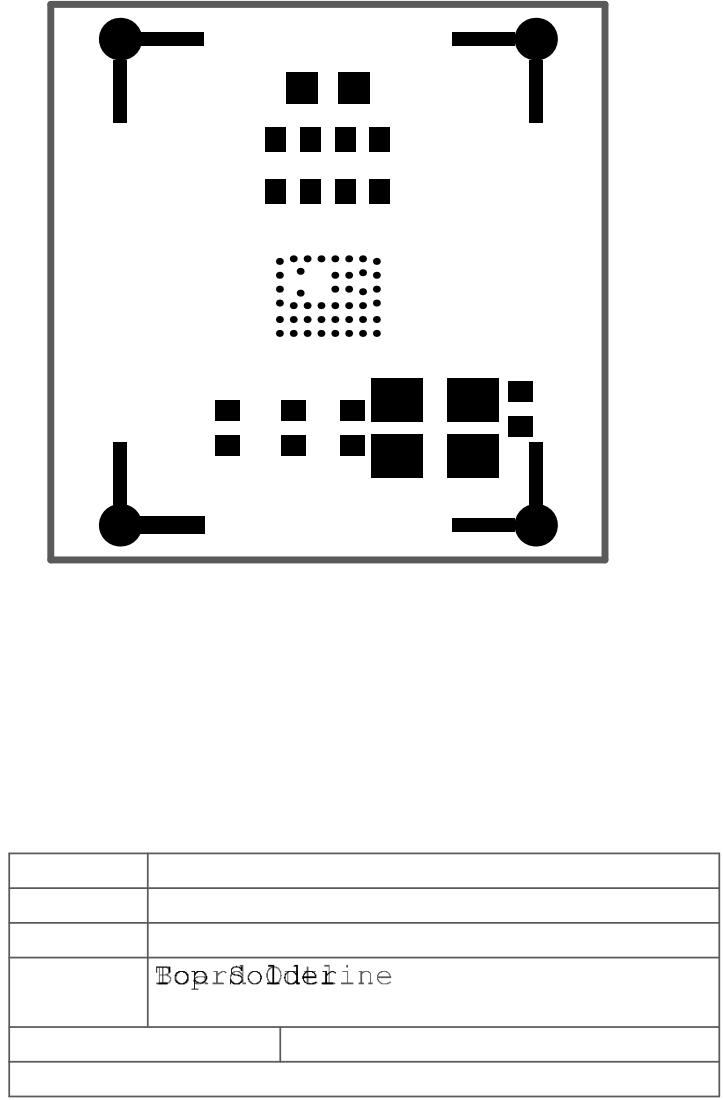
[picture p89: page 11]

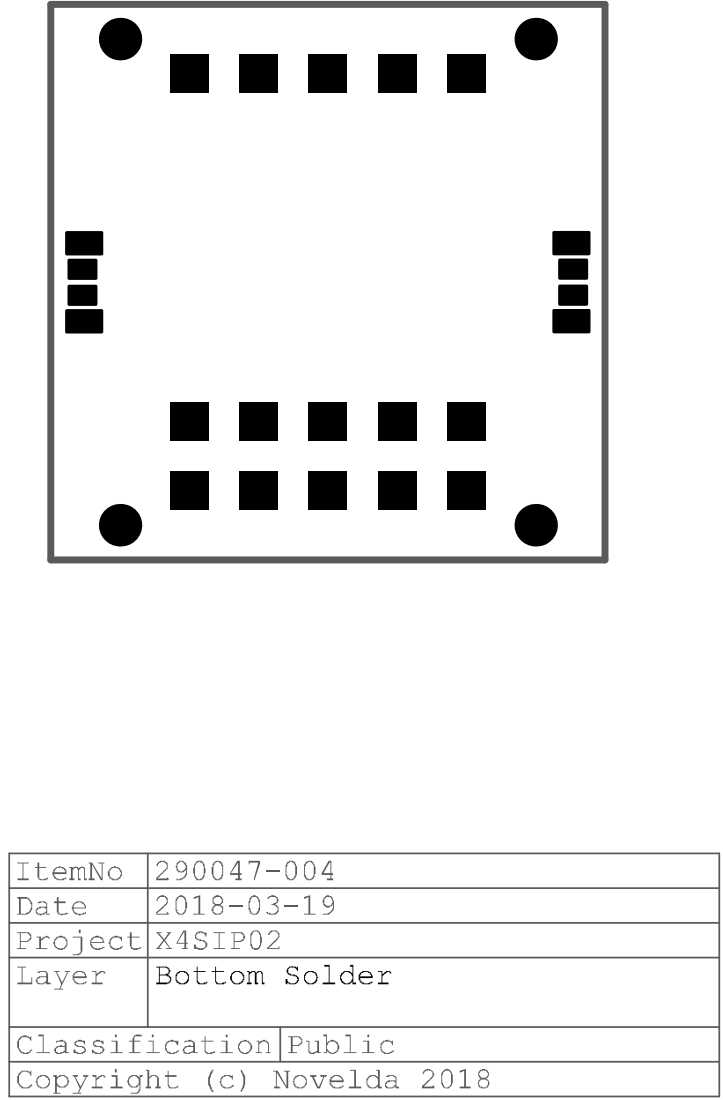
[picture p90: page 12]

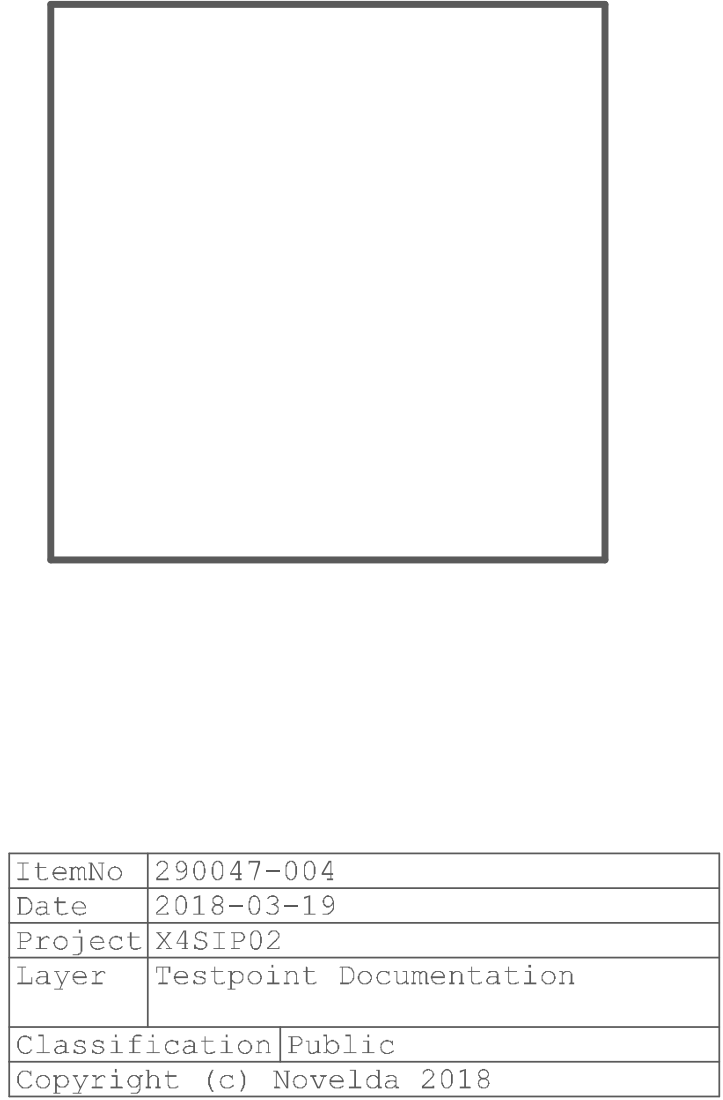
[picture p91: page 13]

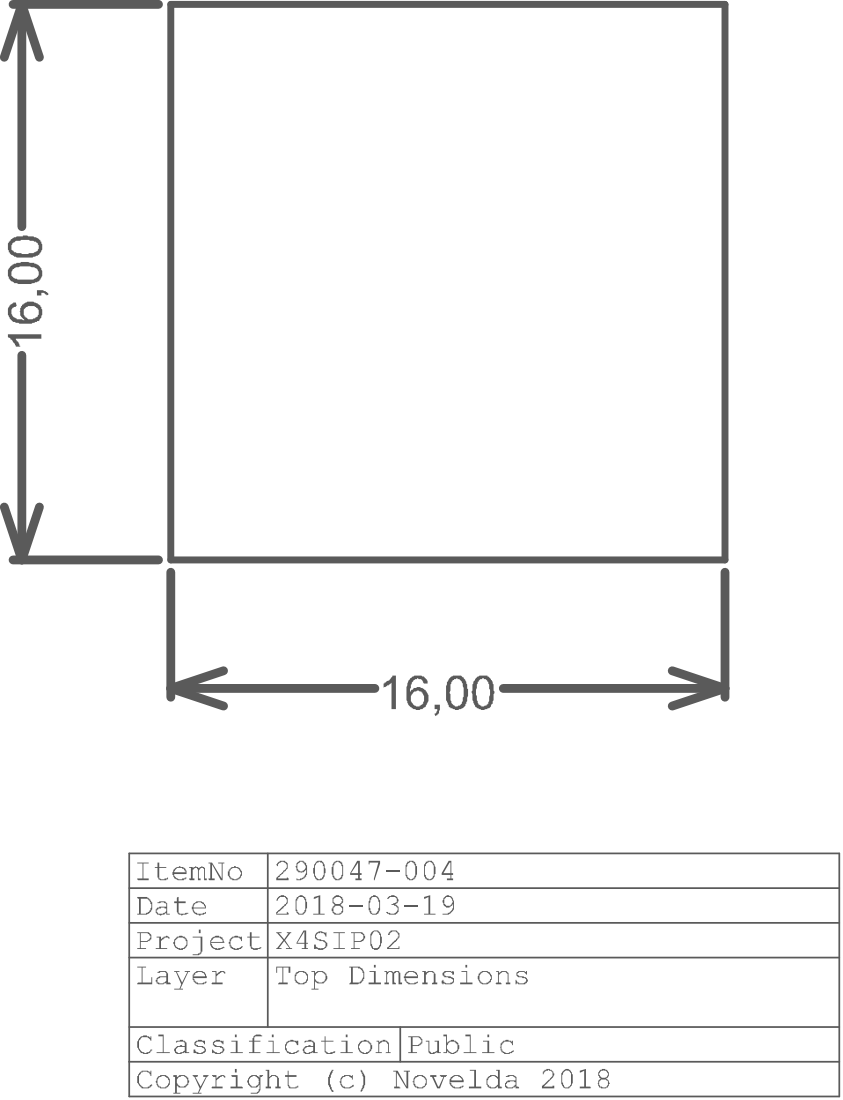
[picture p92: page 14]

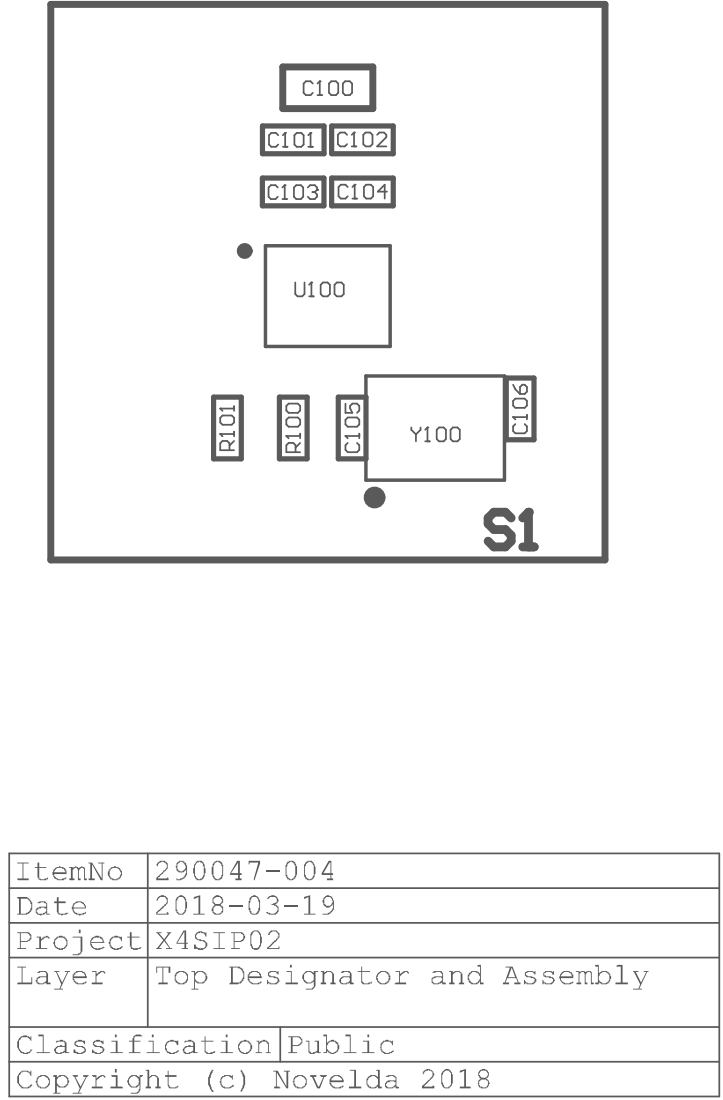
[picture p93: page 15]

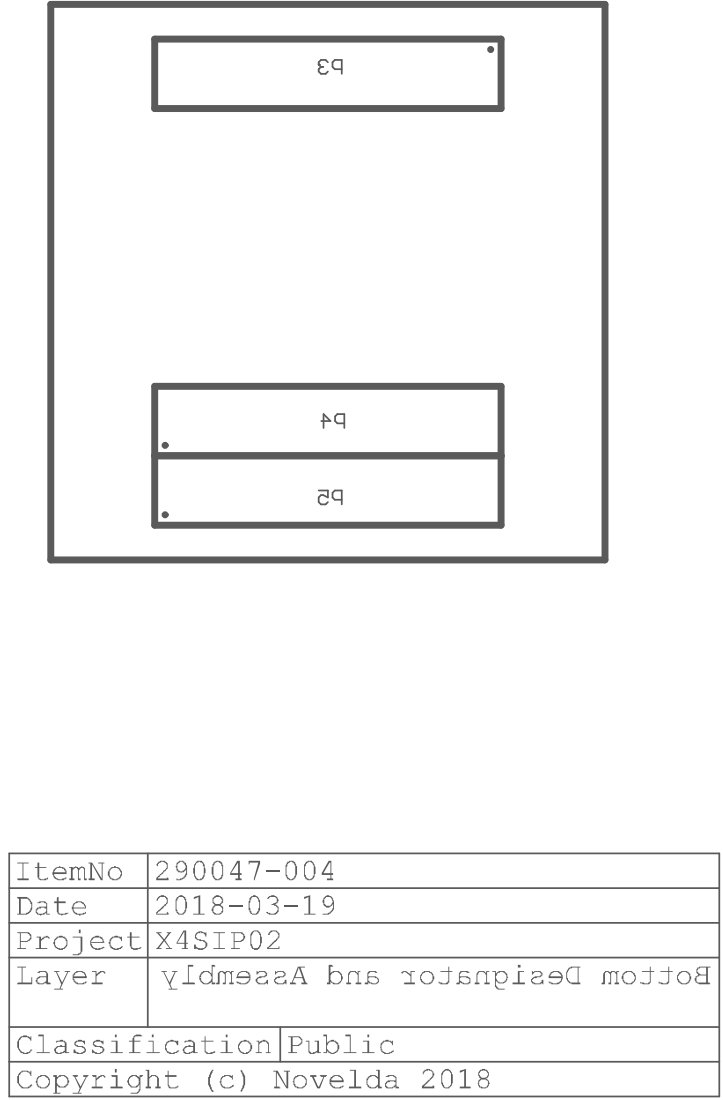
[picture p94: page 16]

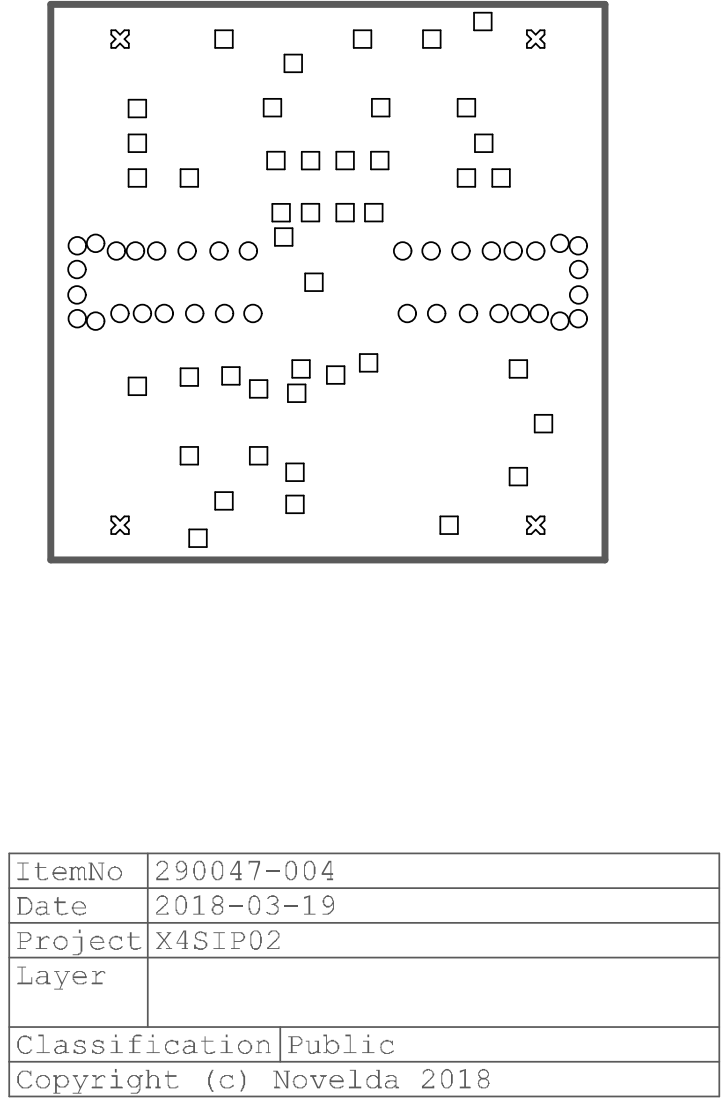
[picture p95: page 17]

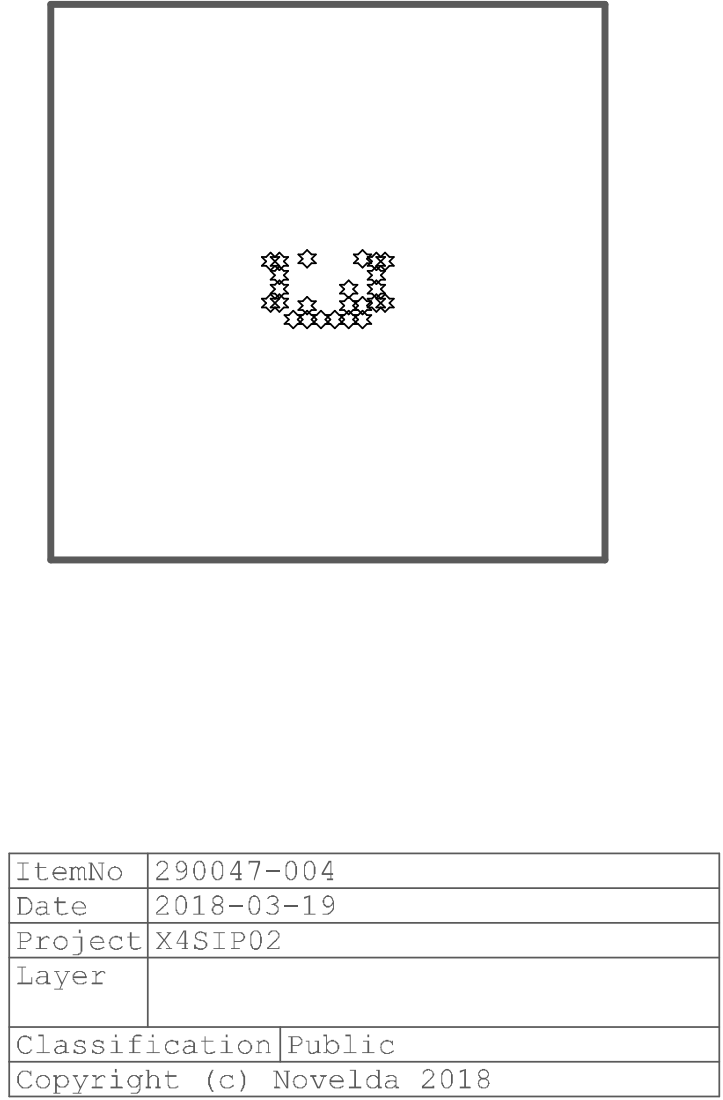
[picture p96: page 18]

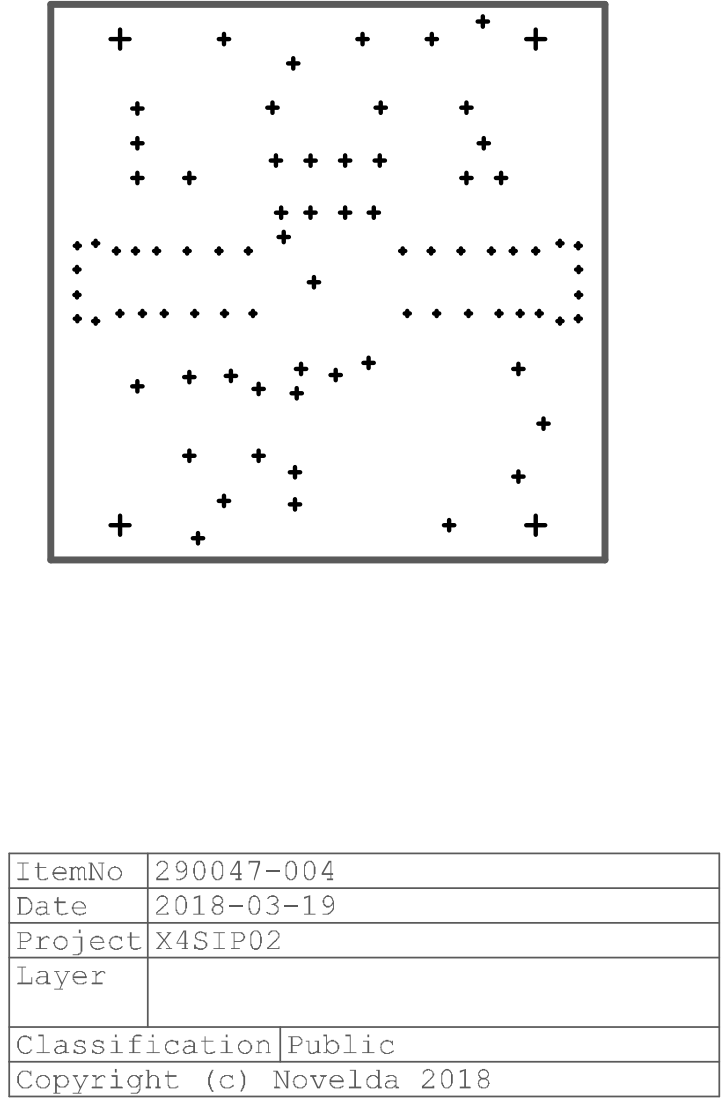
[picture p97: page 19]

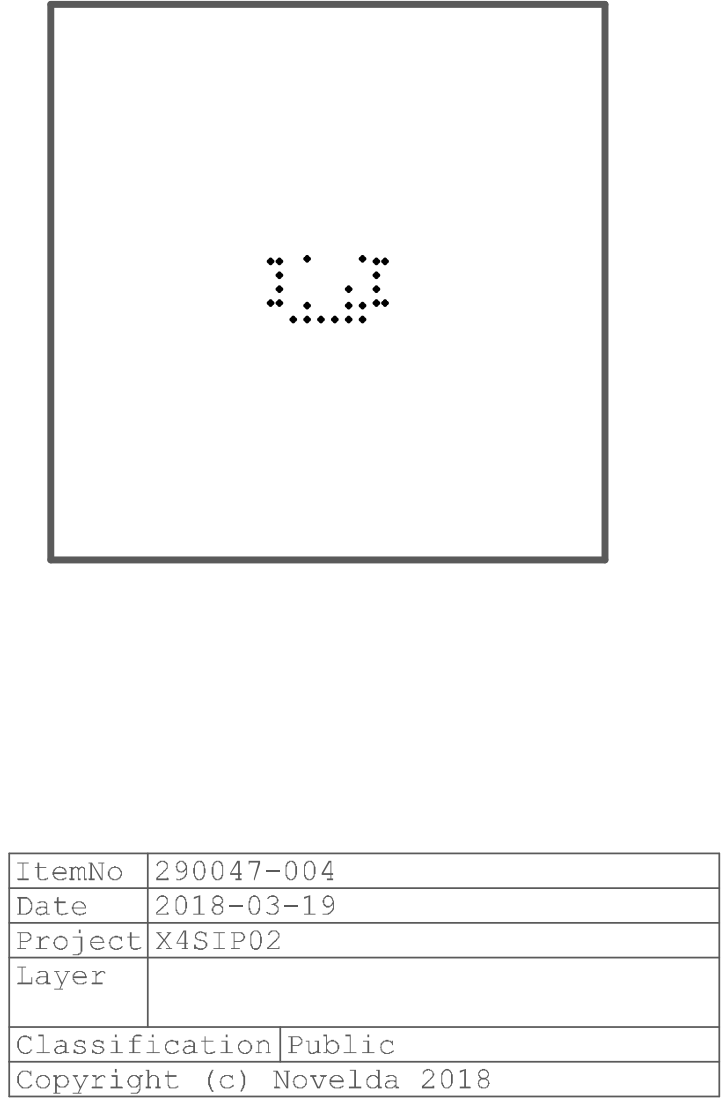
[picture p98: page 20]
