novelda/Legacy-HW/XTMCU02-Rev4_1_Design-Documentation_Public/3D_Print_280027-004.PDF

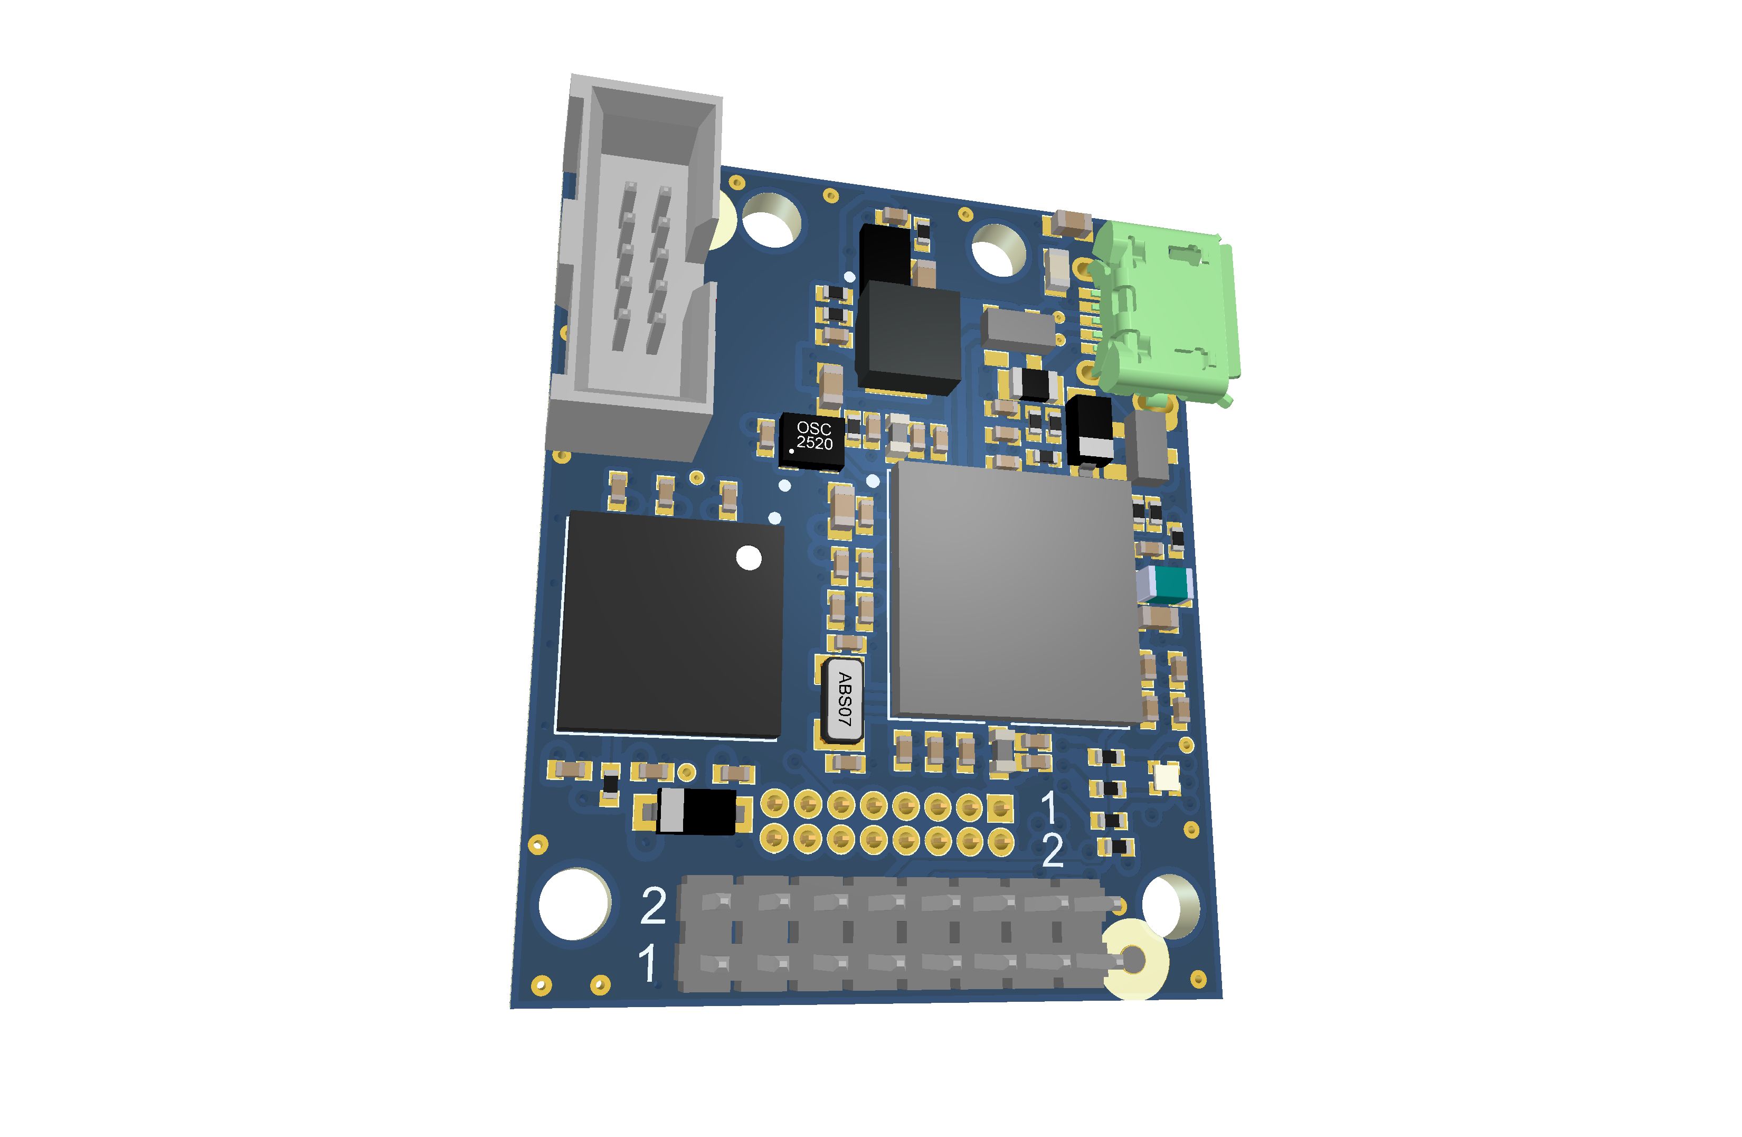
[picture p99: page 1]
