novelda/Legacy-HW/(list of files, drawings)

Other design files:
X4M03-Rev5_Design_Documentation_Public/Altium_Project_000153-005/Main.SchDoc
X4M03-Rev5_Design_Documentation_Public/Altium_Project_000153-005/X4M03.PcbDoc
X4M03-Rev5_Design_Documentation_Public/Altium_Project_000153-005/X4M03.PrjPcb
X4SIP02-Rev4_1_Design_Documentation_Public/Altium_Project_280022-004/Top-Level.SchDoc
X4SIP02-Rev4_1_Design_Documentation_Public/Altium_Project_280022-004/X4.SchDoc
X4SIP02-Rev4_1_Design_Documentation_Public/Altium_Project_280022-004/X4SIP02.PcbDoc
X4SIP02-Rev4_1_Design_Documentation_Public/Altium_Project_280022-004/X4SIP02.PrjPcb
XTMCU02-Rev4_1_Design-Documentation_Public/Altium_Project_280027-004/MCU.SchDoc
XTMCU02-Rev4_1_Design-Documentation_Public/Altium_Project_280027-004/Power.SchDoc
XTMCU02-Rev4_1_Design-Documentation_Public/Altium_Project_280027-004/Top-level.SchDoc
XTMCU02-Rev4_1_Design-Documentation_Public/Altium_Project_280027-004/XTMCU02.PrjPcb
